sventurag/watchman-readout/Documentation/TARGETC_Datasheet/figures/targetchip.jpg

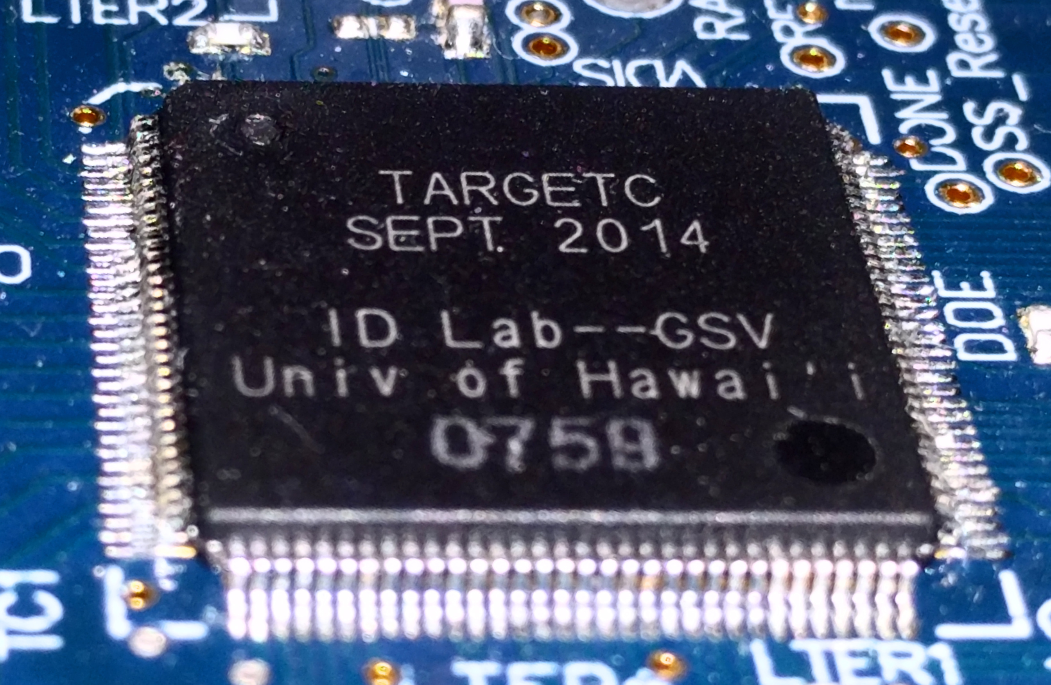
Documentation/TARGETC_Datasheet/figures/targetchip.jpg
