sventurag/watchman-readout/Documentation/MICROZED/Avnet Zed Board Definitions/picozed_7030_fmc2/1.1/PZCC-FMC-V2.jpg

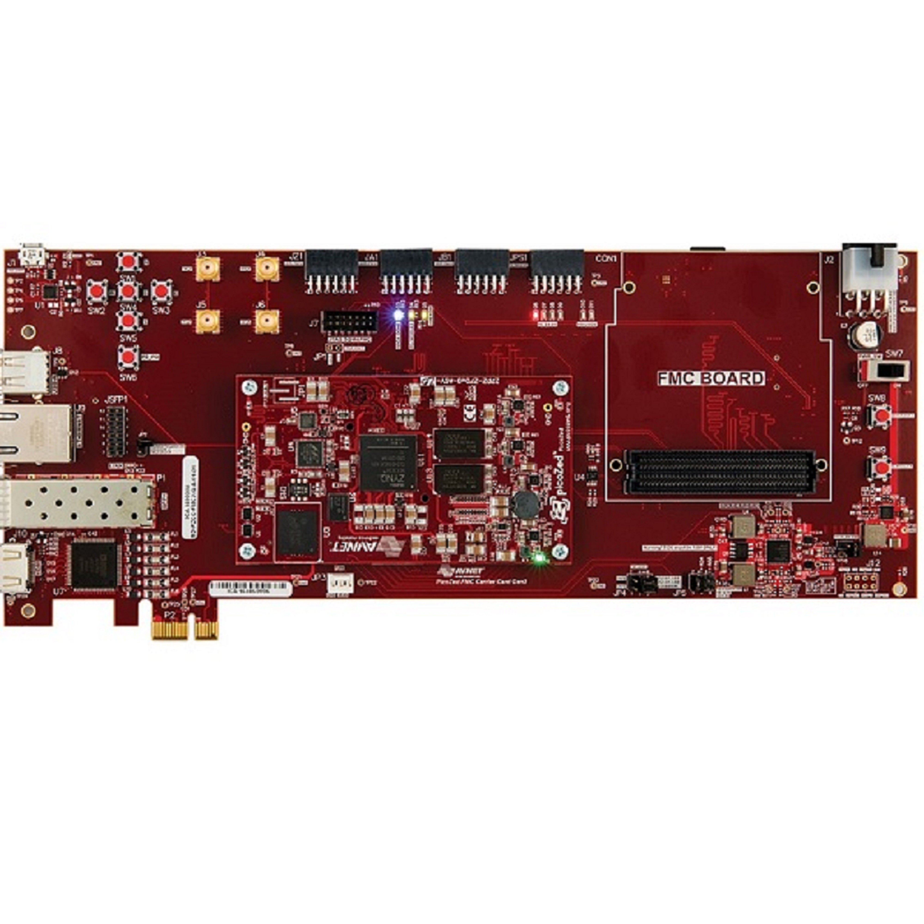
Documentation/MICROZED/Avnet Zed Board Definitions/picozed_7030_fmc2/1.1/PZCC-FMC-V2.jpg
