sventurag/watchman-readout/README.md

# watchman-readout repository
Vivado, SDK and Python files for the development of the readout for WATCHMAN project at the IDLAB.

# March, 2019

## Collaborators :
#### Jose Duron
#### Ky Ho
#### Anthony Schluchin
#### Hendriks Jonathan
#### Vasiliy Shebalin
#### Salvador Ventura
#### Elise Sueoka

## Folder Structure

#### Documentation
Documentation of the project and tutorials

#### GUI
Main interface based on Python 3.

#### Vivado Projects
Vivado Projects for implementing the watchman-readout project.

This repository was created from the original repository [WATCHMAN](https://github.com/WMidlab/WATCHMAN).
