sventurag/watchman-readout/Documentation/firmware_reports/clock_utilization_report.txt

Copyright 1986-2018 Xilinx, Inc. All Rights Reserved.
---------------------------------------------------------------------------------------------------------------------------------------------------------------------------------------------------
| Tool Version : Vivado v.2018.2 (lin64) Build 2258646 Thu Jun 14 20:02:38 MDT 2018
| Date         : Wed Aug 14 15:52:18 2019
| Host         : idlab52-OptiPlex-790 running 64-bit Ubuntu 14.04.6 LTS
| Command      : report_clock_utilization -name clock_utilization_2 -file /home/idlab-52/salvador_fork/fix_WR_address/watchman-readout/Documentation/firmware_reports/clock_utilization_report.txt
| Design       : base_zynq_wrapper
| Device       : 7z010-clg400
| Speed File   : -1  PRODUCTION 1.11 2014-09-11
---------------------------------------------------------------------------------------------------------------------------------------------------------------------------------------------------

Clock Utilization Report

Table of Contents
-----------------
1. Clock Primitive Utilization
2. Global Clock Resources
3. Global Clock Source Details
4. Clock Regions: Key Resource Utilization
5. Clock Regions : Global Clock Summary
6. Device Cell Placement Summary for Global Clock g0
7. Device Cell Placement Summary for Global Clock g1
8. Device Cell Placement Summary for Global Clock g2
9. Device Cell Placement Summary for Global Clock g3
10. Clock Region Cell Placement per Global Clock: Region X0Y0
11. Clock Region Cell Placement per Global Clock: Region X1Y0
12. Clock Region Cell Placement per Global Clock: Region X0Y1
13. Clock Region Cell Placement per Global Clock: Region X1Y1

1. Clock Primitive Utilization
------------------------------

+----------+------+-----------+-----+--------------+--------+
| Type     | Used | Available | LOC | Clock Region | Pblock |
+----------+------+-----------+-----+--------------+--------+
| BUFGCTRL |    4 |        32 |   0 |            0 |      0 |
| BUFH     |    0 |        48 |   0 |            0 |      0 |
| BUFIO    |    0 |         8 |   0 |            0 |      0 |
| BUFMR    |    0 |         4 |   0 |            0 |      0 |
| BUFR     |    0 |         8 |   0 |            0 |      0 |
| MMCM     |    1 |         2 |   0 |            0 |      0 |
| PLL      |    0 |         2 |   0 |            0 |      0 |
+----------+------+-----------+-----+--------------+--------+

2. Global Clock Resources
-------------------------

+-----------+-----------+-----------------+------------+---------------+--------------+-------------------+-------------+-----------------+--------------+--------------+---------------------------------------------------------------------------+------------------------------------------------------------------------+
| Global Id | Source Id | Driver Type/Pin | Constraint | Site          | Clock Region | Load Clock Region | Clock Loads | Non-Clock Loads | Clock Period | Clock        | Driver Pin                                                                | Net                                                                    |
+-----------+-----------+-----------------+------------+---------------+--------------+-------------------+-------------+-----------------+--------------+--------------+---------------------------------------------------------------------------+------------------------------------------------------------------------+
| g0        | src0      | BUFG/O          | None       | BUFGCTRL_X0Y0 | n/a          |                 4 |        8403 |               0 |       10.000 | clk_fpga_0   | base_zynq_i/processing_system7_0/inst/buffer_fclk_clk_0.FCLK_CLK_0_BUFG/O | base_zynq_i/processing_system7_0/inst/FCLK_CLK0                        |
| g1        | src1      | BUFG/O          | None       | BUFGCTRL_X0Y1 | n/a          |                 1 |           2 |               1 |        8.000 | CLK125MHzraw | base_zynq_i/TARGET_C_TopLevel_Sy_0/U0/TC_ClockMgmt_inst/BUFG_OUTCLK250/O  | base_zynq_i/TARGET_C_TopLevel_Sy_0/U0/TC_ClockMgmt_inst/CLK125MHz_bufg |
| g2        | src1      | BUFG/O          | None       | BUFGCTRL_X0Y2 | n/a          |                 1 |           1 |               0 |       10.000 | clkFbOut     | base_zynq_i/TARGET_C_TopLevel_Sy_0/U0/TC_ClockMgmt_inst/BUFG_FB/O         | base_zynq_i/TARGET_C_TopLevel_Sy_0/U0/TC_ClockMgmt_inst/CLKFBIN        |
| g3        | src1      | BUFG/O          | None       | BUFGCTRL_X0Y3 | n/a          |                 1 |           0 |               1 |       10.000 | CLK100MHzraw | base_zynq_i/TARGET_C_TopLevel_Sy_0/U0/TC_ClockMgmt_inst/BUFG_OUTCLK100/O  | base_zynq_i/TARGET_C_TopLevel_Sy_0/U0/TC_ClockMgmt_inst/CLK100MHz_bufg |
+-----------+-----------+-----------------+------------+---------------+--------------+-------------------+-------------+-----------------+--------------+--------------+---------------------------------------------------------------------------+------------------------------------------------------------------------+
* Clock Loads column represents the clock pin loads (pin count)
** Non-Clock Loads column represents the non-clock pin loads (pin count)

3. Global Clock Source Details
------------------------------

+-----------+-----------+---------------------+------------+-----------------+--------------+-------------+-----------------+---------------------+--------------+----------------------------------------------------------------------------------+----------------------------------------------------------------------+
| Source Id | Global Id | Driver Type/Pin     | Constraint | Site            | Clock Region | Clock Loads | Non-Clock Loads | Source Clock Period | Source Clock | Driver Pin                                                                       | Net                                                                  |
+-----------+-----------+---------------------+------------+-----------------+--------------+-------------+-----------------+---------------------+--------------+----------------------------------------------------------------------------------+----------------------------------------------------------------------+
| src0      | g0        | PS7/FCLKCLK[0]      | PS7_X0Y0   | PS7_X0Y0        | X0Y1         |           1 |               0 |              10.000 | clk_fpga_0   | base_zynq_i/processing_system7_0/inst/PS7_i/FCLKCLK[0]                           | base_zynq_i/processing_system7_0/inst/FCLK_CLK_unbuffered[0]         |
| src1      | g3        | MMCME2_ADV/CLKOUT0  | None       | MMCME2_ADV_X0Y0 | X1Y0         |           1 |               0 |              10.000 | CLK100MHzraw | base_zynq_i/TARGET_C_TopLevel_Sy_0/U0/TC_ClockMgmt_inst/TC_CLK_MNG_inst/CLKOUT0  | base_zynq_i/TARGET_C_TopLevel_Sy_0/U0/TC_ClockMgmt_inst/CLK100MHzraw |
| src1      | g1        | MMCME2_ADV/CLKOUT1  | None       | MMCME2_ADV_X0Y0 | X1Y0         |           1 |               0 |               8.000 | CLK125MHzraw | base_zynq_i/TARGET_C_TopLevel_Sy_0/U0/TC_ClockMgmt_inst/TC_CLK_MNG_inst/CLKOUT1  | base_zynq_i/TARGET_C_TopLevel_Sy_0/U0/TC_ClockMgmt_inst/CLK125MHzraw |
| src1      | g2        | MMCME2_ADV/CLKFBOUT | None       | MMCME2_ADV_X0Y0 | X1Y0         |           1 |               0 |              10.000 | clkFbOut     | base_zynq_i/TARGET_C_TopLevel_Sy_0/U0/TC_ClockMgmt_inst/TC_CLK_MNG_inst/CLKFBOUT | base_zynq_i/TARGET_C_TopLevel_Sy_0/U0/TC_ClockMgmt_inst/clkFbOut     |
+-----------+-----------+---------------------+------------+-----------------+--------------+-------------+-----------------+---------------------+--------------+----------------------------------------------------------------------------------+----------------------------------------------------------------------+
* Clock Loads column represents the clock pin loads (pin count)
** Non-Clock Loads column represents the non-clock pin loads (pin count)

4. Clock Regions: Key Resource Utilization
------------------------------------------

+-------------------+--------------+--------------+--------------+--------------+--------------+--------------+--------------+--------------+--------------+--------------+--------------+--------------+--------------+--------------+--------------+
|                   | Global Clock |     BUFRs    |    BUFMRs    |    BUFIOs    |     MMCM     |      PLL     |      GT      |      PCI     |    ILOGIC    |    OLOGIC    |      FF      |     LUTM     |    RAMB18    |    RAMB36    |    DSP48E2   |
+-------------------+------+-------+------+-------+------+-------+------+-------+------+-------+------+-------+------+-------+------+-------+------+-------+------+-------+------+-------+------+-------+------+-------+------+-------+------+-------+
| Clock Region Name | Used | Avail | Used | Avail | Used | Avail | Used | Avail | Used | Avail | Used | Avail | Used | Avail | Used | Avail | Used | Avail | Used | Avail | Used | Avail | Used | Avail | Used | Avail | Used | Avail | Used | Avail |
+-------------------+------+-------+------+-------+------+-------+------+-------+------+-------+------+-------+------+-------+------+-------+------+-------+------+-------+------+-------+------+-------+------+-------+------+-------+------+-------+
| X0Y0              |    1 |    12 |    0 |     0 |    0 |     0 |    0 |     0 |    0 |     0 |    0 |     0 |    0 |     0 |    0 |     0 |    0 |     0 |    0 |     0 | 3010 |  1100 | 1262 |   400 |    0 |    20 |    1 |    10 |    0 |    20 |
| X1Y0              |    4 |    12 |    0 |     4 |    0 |     2 |    0 |     4 |    1 |     1 |    0 |     1 |    0 |     0 |    0 |     0 |    0 |    50 |    0 |    50 | 1213 |  1100 |  311 |   350 |    1 |    40 |    1 |    20 |    0 |    20 |
| X0Y1              |    1 |    12 |    0 |     0 |    0 |     0 |    0 |     0 |    0 |     0 |    0 |     0 |    0 |     0 |    0 |     0 |    0 |     0 |    0 |     0 | 2429 |  1100 |  939 |   400 |    0 |    20 |    0 |    10 |    0 |    20 |
| X1Y1              |    1 |    12 |    0 |     4 |    0 |     2 |    0 |     4 |    0 |     1 |    0 |     1 |    0 |     0 |    0 |     0 |    0 |    50 |    0 |    50 | 1521 |  1100 |  458 |   350 |    0 |    40 |    0 |    20 |    0 |    20 |
+-------------------+------+-------+------+-------+------+-------+------+-------+------+-------+------+-------+------+-------+------+-------+------+-------+------+-------+------+-------+------+-------+------+-------+------+-------+------+-------+
* Global Clock column represents track count; while other columns represents cell counts

5. Clock Regions : Global Clock Summary
---------------------------------------

All Modules
+----+----+----+
|    | X0 | X1 |
+----+----+----+
| Y1 |  1 |  1 |
| Y0 |  1 |  4 |
+----+----+----+

6. Device Cell Placement Summary for Global Clock g0
----------------------------------------------------

+-----------+-----------------+-------------------+------------+-------------+---------------+-------------+----------+----------------+----------+-------------------------------------------------+
| Global Id | Driver Type/Pin | Driver Region (D) | Clock      | Period (ns) | Waveform (ns) | Slice Loads | IO Loads | Clocking Loads | GT Loads | Net                                             |
+-----------+-----------------+-------------------+------------+-------------+---------------+-------------+----------+----------------+----------+-------------------------------------------------+
| g0        | BUFG/O          | n/a               | clk_fpga_0 |      10.000 | {0.000 5.000} |        8363 |        0 |              1 |        0 | base_zynq_i/processing_system7_0/inst/FCLK_CLK0 |
+-----------+-----------------+-------------------+------------+-------------+---------------+-------------+----------+----------------+----------+-------------------------------------------------+
* Logic Loads column represents load cell count of all cell types other than IO, GT and clock resources
** IO Loads column represents load cell count of IO types
*** Clocking Loads column represents load cell count that are clock resources (global clock buffer, MMCM, PLL, etc)
**** GT Loads column represents load cell count of GT types

+----+-------+-------+
|    | X0    | X1    |
+----+-------+-------+
| Y1 |  2430 |  1521 |
| Y0 |  3197 |  1216 |
+----+-------+-------+

7. Device Cell Placement Summary for Global Clock g1
----------------------------------------------------

+-----------+-----------------+-------------------+--------------+-------------+---------------+-------------+----------+----------------+----------+------------------------------------------------------------------------+
| Global Id | Driver Type/Pin | Driver Region (D) | Clock        | Period (ns) | Waveform (ns) | Slice Loads | IO Loads | Clocking Loads | GT Loads | Net                                                                    |
+-----------+-----------------+-------------------+--------------+-------------+---------------+-------------+----------+----------------+----------+------------------------------------------------------------------------+
| g1        | BUFG/O          | n/a               | CLK125MHzraw |       8.000 | {0.000 4.000} |           3 |        0 |              0 |        0 | base_zynq_i/TARGET_C_TopLevel_Sy_0/U0/TC_ClockMgmt_inst/CLK125MHz_bufg |
+-----------+-----------------+-------------------+--------------+-------------+---------------+-------------+----------+----------------+----------+------------------------------------------------------------------------+
* Logic Loads column represents load cell count of all cell types other than IO, GT and clock resources
** IO Loads column represents load cell count of IO types
*** Clocking Loads column represents load cell count that are clock resources (global clock buffer, MMCM, PLL, etc)
**** GT Loads column represents load cell count of GT types

+----+----+----+
|    | X0 | X1 |
+----+----+----+
| Y1 |  0 |  0 |
| Y0 |  0 |  3 |
+----+----+----+

8. Device Cell Placement Summary for Global Clock g2
----------------------------------------------------

+-----------+-----------------+-------------------+----------+-------------+---------------+-------------+----------+----------------+----------+-----------------------------------------------------------------+
| Global Id | Driver Type/Pin | Driver Region (D) | Clock    | Period (ns) | Waveform (ns) | Slice Loads | IO Loads | Clocking Loads | GT Loads | Net                                                             |
+-----------+-----------------+-------------------+----------+-------------+---------------+-------------+----------+----------------+----------+-----------------------------------------------------------------+
| g2        | BUFG/O          | n/a               | clkFbOut |      10.000 | {0.000 5.000} |           0 |        0 |              1 |        0 | base_zynq_i/TARGET_C_TopLevel_Sy_0/U0/TC_ClockMgmt_inst/CLKFBIN |
+-----------+-----------------+-------------------+----------+-------------+---------------+-------------+----------+----------------+----------+-----------------------------------------------------------------+
* Logic Loads column represents load cell count of all cell types other than IO, GT and clock resources
** IO Loads column represents load cell count of IO types
*** Clocking Loads column represents load cell count that are clock resources (global clock buffer, MMCM, PLL, etc)
**** GT Loads column represents load cell count of GT types

+----+----+----+
|    | X0 | X1 |
+----+----+----+
| Y1 |  0 |  0 |
| Y0 |  0 |  1 |
+----+----+----+

9. Device Cell Placement Summary for Global Clock g3
----------------------------------------------------

+-----------+-----------------+-------------------+--------------+-------------+---------------+-------------+----------+----------------+----------+------------------------------------------------------------------------+
| Global Id | Driver Type/Pin | Driver Region (D) | Clock        | Period (ns) | Waveform (ns) | Slice Loads | IO Loads | Clocking Loads | GT Loads | Net                                                                    |
+-----------+-----------------+-------------------+--------------+-------------+---------------+-------------+----------+----------------+----------+------------------------------------------------------------------------+
| g3        | BUFG/O          | n/a               | CLK100MHzraw |      10.000 | {0.000 5.000} |           1 |        0 |              0 |        0 | base_zynq_i/TARGET_C_TopLevel_Sy_0/U0/TC_ClockMgmt_inst/CLK100MHz_bufg |
+-----------+-----------------+-------------------+--------------+-------------+---------------+-------------+----------+----------------+----------+------------------------------------------------------------------------+
* Logic Loads column represents load cell count of all cell types other than IO, GT and clock resources
** IO Loads column represents load cell count of IO types
*** Clocking Loads column represents load cell count that are clock resources (global clock buffer, MMCM, PLL, etc)
**** GT Loads column represents load cell count of GT types

+----+----+----+
|    | X0 | X1 |
+----+----+----+
| Y1 |  0 |  0 |
| Y0 |  0 |  1 |
+----+----+----+

10. Clock Region Cell Placement per Global Clock: Region X0Y0
-------------------------------------------------------------

+-----------+-------+-----------------+------------+-------------+-----------------+------+--------+------+-----+----+------+-----+---------+-------------------------------------------------+
| Global Id | Track | Driver Type/Pin | Constraint | Clock Loads | Non-Clock Loads | FF   | LUTRAM | RAMB | DSP | GT | MMCM | PLL | Hard IP | Net                                             |
+-----------+-------+-----------------+------------+-------------+-----------------+------+--------+------+-----+----+------+-----+---------+-------------------------------------------------+
| g0        | n/a   | BUFG/O          | None       |        3197 |               0 | 3010 |    185 |    1 |   0 |  0 |    0 |   0 |       0 | base_zynq_i/processing_system7_0/inst/FCLK_CLK0 |
+-----------+-------+-----------------+------------+-------------+-----------------+------+--------+------+-----+----+------+-----+---------+-------------------------------------------------+
* Clock Loads column represents the clock pin loads (pin count)
** Non-Clock Loads column represents the non-clock pin loads (pin count)
*** Columns FF, LUTRAM, RAMB through 'Hard IP' represents load cell counts

11. Clock Region Cell Placement per Global Clock: Region X1Y0
-------------------------------------------------------------

+-----------+-------+-----------------+------------+-------------+-----------------+------+--------+------+-----+----+------+-----+---------+------------------------------------------------------------------------+
| Global Id | Track | Driver Type/Pin | Constraint | Clock Loads | Non-Clock Loads | FF   | LUTRAM | RAMB | DSP | GT | MMCM | PLL | Hard IP | Net                                                                    |
+-----------+-------+-----------------+------------+-------------+-----------------+------+--------+------+-----+----+------+-----+---------+------------------------------------------------------------------------+
| g0        | n/a   | BUFG/O          | None       |        1216 |               0 | 1211 |      0 |    2 |   0 |  0 |    1 |   0 |       0 | base_zynq_i/processing_system7_0/inst/FCLK_CLK0                        |
| g1        | n/a   | BUFG/O          | None       |           2 |               1 |    2 |      0 |    0 |   0 |  0 |    0 |   0 |       0 | base_zynq_i/TARGET_C_TopLevel_Sy_0/U0/TC_ClockMgmt_inst/CLK125MHz_bufg |
| g2        | n/a   | BUFG/O          | None       |           1 |               0 |    0 |      0 |    0 |   0 |  0 |    1 |   0 |       0 | base_zynq_i/TARGET_C_TopLevel_Sy_0/U0/TC_ClockMgmt_inst/CLKFBIN        |
| g3        | n/a   | BUFG/O          | None       |           0 |               1 |    0 |      0 |    0 |   0 |  0 |    0 |   0 |       0 | base_zynq_i/TARGET_C_TopLevel_Sy_0/U0/TC_ClockMgmt_inst/CLK100MHz_bufg |
+-----------+-------+-----------------+------------+-------------+-----------------+------+--------+------+-----+----+------+-----+---------+------------------------------------------------------------------------+
* Clock Loads column represents the clock pin loads (pin count)
** Non-Clock Loads column represents the non-clock pin loads (pin count)
*** Columns FF, LUTRAM, RAMB through 'Hard IP' represents load cell counts

12. Clock Region Cell Placement per Global Clock: Region X0Y1
-------------------------------------------------------------

+-----------+-------+-----------------+------------+-------------+-----------------+------+--------+------+-----+----+------+-----+---------+-------------------------------------------------+
| Global Id | Track | Driver Type/Pin | Constraint | Clock Loads | Non-Clock Loads | FF   | LUTRAM | RAMB | DSP | GT | MMCM | PLL | Hard IP | Net                                             |
+-----------+-------+-----------------+------------+-------------+-----------------+------+--------+------+-----+----+------+-----+---------+-------------------------------------------------+
| g0        | n/a   | BUFG/O          | None       |        2430 |               0 | 2429 |      0 |    0 |   0 |  0 |    0 |   0 |       0 | base_zynq_i/processing_system7_0/inst/FCLK_CLK0 |
+-----------+-------+-----------------+------------+-------------+-----------------+------+--------+------+-----+----+------+-----+---------+-------------------------------------------------+
* Clock Loads column represents the clock pin loads (pin count)
** Non-Clock Loads column represents the non-clock pin loads (pin count)
*** Columns FF, LUTRAM, RAMB through 'Hard IP' represents load cell counts

13. Clock Region Cell Placement per Global Clock: Region X1Y1
-------------------------------------------------------------

+-----------+-------+-----------------+------------+-------------+-----------------+------+--------+------+-----+----+------+-----+---------+-------------------------------------------------+
| Global Id | Track | Driver Type/Pin | Constraint | Clock Loads | Non-Clock Loads | FF   | LUTRAM | RAMB | DSP | GT | MMCM | PLL | Hard IP | Net                                             |
+-----------+-------+-----------------+------------+-------------+-----------------+------+--------+------+-----+----+------+-----+---------+-------------------------------------------------+
| g0        | n/a   | BUFG/O          | None       |        1521 |               0 | 1521 |      0 |    0 |   0 |  0 |    0 |   0 |       0 | base_zynq_i/processing_system7_0/inst/FCLK_CLK0 |
+-----------+-------+-----------------+------------+-------------+-----------------+------+--------+------+-----+----+------+-----+---------+-------------------------------------------------+
* Clock Loads column represents the clock pin loads (pin count)
** Non-Clock Loads column represents the non-clock pin loads (pin count)
*** Columns FF, LUTRAM, RAMB through 'Hard IP' represents load cell counts

# Location of BUFG Primitives 
set_property LOC BUFGCTRL_X0Y0 [get_cells base_zynq_i/processing_system7_0/inst/buffer_fclk_clk_0.FCLK_CLK_0_BUFG]
set_property LOC BUFGCTRL_X0Y2 [get_cells base_zynq_i/TARGET_C_TopLevel_Sy_0/U0/TC_ClockMgmt_inst/BUFG_FB]
set_property LOC BUFGCTRL_X0Y1 [get_cells base_zynq_i/TARGET_C_TopLevel_Sy_0/U0/TC_ClockMgmt_inst/BUFG_OUTCLK250]
set_property LOC BUFGCTRL_X0Y3 [get_cells base_zynq_i/TARGET_C_TopLevel_Sy_0/U0/TC_ClockMgmt_inst/BUFG_OUTCLK100]

# Location of IO Primitives which is load of clock spine

# Location of clock ports

# Clock net "base_zynq_i/processing_system7_0/inst/FCLK_CLK0" driven by instance "base_zynq_i/processing_system7_0/inst/buffer_fclk_clk_0.FCLK_CLK_0_BUFG" located at site "BUFGCTRL_X0Y0"
#startgroup
create_pblock {CLKAG_base_zynq_i/processing_system7_0/inst/FCLK_CLK0}
add_cells_to_pblock [get_pblocks  {CLKAG_base_zynq_i/processing_system7_0/inst/FCLK_CLK0}] [get_cells -filter { PRIMITIVE_GROUP != I/O && IS_PRIMITIVE==1 && PRIMITIVE_LEVEL !=INTERNAL && NAME!=base_zynq_i/TARGET_C_TopLevel_Sy_0/U0/TC_ClockMgmt_inst/TC_CLK_MNG_inst} -of_object [get_pins -filter {DIRECTION==IN} -of_objects [get_nets -hierarchical -filter {PARENT=="base_zynq_i/processing_system7_0/inst/FCLK_CLK0"}]]]
resize_pblock [get_pblocks {CLKAG_base_zynq_i/processing_system7_0/inst/FCLK_CLK0}] -add {CLOCKREGION_X0Y0:CLOCKREGION_X0Y0 CLOCKREGION_X0Y1:CLOCKREGION_X0Y1 CLOCKREGION_X1Y0:CLOCKREGION_X1Y0 CLOCKREGION_X1Y1:CLOCKREGION_X1Y1}
#endgroup

# Clock net "base_zynq_i/TARGET_C_TopLevel_Sy_0/U0/TC_ClockMgmt_inst/CLK125MHz_bufg" driven by instance "base_zynq_i/TARGET_C_TopLevel_Sy_0/U0/TC_ClockMgmt_inst/BUFG_OUTCLK250" located at site "BUFGCTRL_X0Y1"
#startgroup
create_pblock {CLKAG_base_zynq_i/TARGET_C_TopLevel_Sy_0/U0/TC_ClockMgmt_inst/CLK125MHz_bufg}
add_cells_to_pblock [get_pblocks  {CLKAG_base_zynq_i/TARGET_C_TopLevel_Sy_0/U0/TC_ClockMgmt_inst/CLK125MHz_bufg}] [get_cells -filter { PRIMITIVE_GROUP != I/O && IS_PRIMITIVE==1 && PRIMITIVE_LEVEL !=INTERNAL } -of_object [get_pins -filter {DIRECTION==IN} -of_objects [get_nets -hierarchical -filter {PARENT=="base_zynq_i/TARGET_C_TopLevel_Sy_0/U0/TC_ClockMgmt_inst/CLK125MHz_bufg"}]]]
resize_pblock [get_pblocks {CLKAG_base_zynq_i/TARGET_C_TopLevel_Sy_0/U0/TC_ClockMgmt_inst/CLK125MHz_bufg}] -add {CLOCKREGION_X1Y0:CLOCKREGION_X1Y0}
#endgroup

# Clock net "base_zynq_i/TARGET_C_TopLevel_Sy_0/U0/TC_ClockMgmt_inst/CLK100MHz_bufg" driven by instance "base_zynq_i/TARGET_C_TopLevel_Sy_0/U0/TC_ClockMgmt_inst/BUFG_OUTCLK100" located at site "BUFGCTRL_X0Y3"
#startgroup
create_pblock {CLKAG_base_zynq_i/TARGET_C_TopLevel_Sy_0/U0/TC_ClockMgmt_inst/CLK100MHz_bufg}
add_cells_to_pblock [get_pblocks  {CLKAG_base_zynq_i/TARGET_C_TopLevel_Sy_0/U0/TC_ClockMgmt_inst/CLK100MHz_bufg}] [get_cells -filter { PRIMITIVE_GROUP != I/O && IS_PRIMITIVE==1 && PRIMITIVE_LEVEL !=INTERNAL } -of_object [get_pins -filter {DIRECTION==IN} -of_objects [get_nets -hierarchical -filter {PARENT=="base_zynq_i/TARGET_C_TopLevel_Sy_0/U0/TC_ClockMgmt_inst/CLK100MHz_bufg"}]]]
resize_pblock [get_pblocks {CLKAG_base_zynq_i/TARGET_C_TopLevel_Sy_0/U0/TC_ClockMgmt_inst/CLK100MHz_bufg}] -add {CLOCKREGION_X1Y0:CLOCKREGION_X1Y0}
#endgroup
