sventurag/watchman-readout/Documentation/TARGETC_Datasheet/src/TARGETC_pinout_hej.xlsx

Sheet: Sheet1
TARGETC ASIC pinout
Pin # | Pin Name | Direction | Connection type | Comments | = VDD
1 | RFin_1 |  | PMT input Ch. 1 | termination R | = GND
2 | RFN_1 |  | Termination ref input Ch. 1 | external, between pins | = Digital to FPGA
3 | RFin_2 |  | PMT input Ch. 2 | termination R | = Digital from FPGA
4 | RFN_2 |  | Termination ref input Ch. 2 | external, between pins | = Analog/bias value
5 | RFin_3 |  | PMT input Ch. 3 | termination R | = Feed to CCTV
6 | RFN_3 |  | Termination ref input Ch. 3 | external, between pins | = Signal input
7 | RFin_4 |  | PMT input Ch. 4 | termination R | = Reference terminal
8 | RFN_4 |  | Termination ref input Ch. 4 | external, between pins | = Test point
9 | RFin_5 |  | PMT input Ch. 5 | termination R | = LVDS inputs
10 | RFN_5 |  | Termination ref input Ch. 5 | external, between pins | = LVDS outputs
11 | RFin_6 |  | PMT input Ch. 6 | termination R
12 | RFN_6 |  | Termination ref input Ch. 6 | external, between pins | = no connect
13 | RFin_7 |  | PMT input Ch. 7 | termination R
14 | RFN_7 |  | Termination ref input Ch. 7 | external, between pins
15 | RFin_8 |  | PMT input Ch. 8 | termination R
16 | RFN_8 |  | Termination ref input Ch. 8 | external, between pins
17 | RFin_9 |  | PMT input Ch. 9 | termination R
18 | RFN_9 |  | Termination ref input Ch. 9 | external, between pins
19 | RFin_10 |  | PMT input Ch. 10 | termination R
20 | RFN_10 |  | Termination ref input Ch. 10 | external, between pins
21 | RFin_11 |  | PMT input Ch. 11 | termination R
22 | RFN_11 |  | Termination ref input Ch. 11 | external, between pins
23 | RFin_12 |  | PMT input Ch. 12 | termination R
24 | RFN_12 |  | Termination ref input Ch. 12 | external, between pins
25 | RFin_13 |  | PMT input Ch. 13 | termination R
26 | RFN_13 |  | Termination ref input Ch. 13 | external, between pins
27 | RFin_14 |  | PMT input Ch. 14 | termination R
28 | RFN_14 |  | Termination ref input Ch. 14 | external, between pins
29 | RFin_15 |  | PMT input Ch. 15 | termination R
30 | RFN_15 |  | Termination ref input Ch. 15 | external, between pins
31 | RFin_16 |  | PMT input Ch. 16 | termination R
32 | RFN_16 |  | Termination ref input Ch. 16 | external, between pins
33 | GND33 | GND | 0V power (GND = VSS)
34 | VDD34 | VDD | 2.5V power (VDD)
35 | eSin |  | Serial Input data | all bits, last = first
36 | eSCLK |  | Serial clock advance | shift in each bit
37 | ePCLK |  | Parallel clock load | transfer shifted data
38 | eSHout |  | Serial Shift Out | monitor output
39 | GND39 | GND | 0V power (GND = VSS)
40 | VDD40 | VDD | 2.5V power (VDD)
41 |  |  | no connect
42
43 | eHSclkN |  | Data Shift-out Clock | n
44 | eHSclkP |  | LVDS | p
45 | GND43 | GND | 0V power (GND = VSS)
46 | eWR_RS_S0 |  | WR Row Select Addr. 0 | Select
47 | eWR_CS_S1 |  | WR Row Select Addr. 1 | group
48 | eWR_CS_S0 |  | WR Column Select Addr. 0 | of 32
49 | eWR_CS_S1 |  | WR Column Select Addr. 1 | samples
50 | eWR_CS_S2 |  | WR Column Select Addr. 2 | for transfer to
51 | eWR_CS_S3 |  | WR Column Select Addr. 3 | Storage
52 | VDD52 | VDD | 2.5V power (VDD)
53 | GND53 | GND | 0V power (GND = VSS)
54 | eWR_CS_S4 |  | WR Column Select Addr. 4 | group of 32 to write
55 | eWR_CS_S5 |  | WR Column Select Addr. 5
56 | eGCC_Reset |  | Gray Code Counter Reset
57 | WL_CLK_n |  | Wilkinson Clock LVDS | n
58 | WL_CLK_p |  | Wilkinson Clock LVDS | p
59 | GND59 | GND | 0V power (GND = VSS)
60 | VDD60 | VDD | 2.5V power (VDD)
61 | eRDAD_clk |  | Read Address Set SCLK
62 | eRDAD_sin |  | Read Address Set Serial Input
63 | eRDAD_dir |  | Read Address Set DIR
64 |  |  | no connect
65 |  |  | no connect
66 | eSmplSl_Any |  | SelANY_TPG | TPG select
67 | VDD67 |  | 2.5V power (VDD)
68 | GND68 |  | 0V power (GND = VSS)
69 | eDO_16 |  | Serial Data Out Ch. 16 | MSB to LSB
70 | eDO_15 |  | Serial Data Out Ch. 15
71 | eDO_14 |  | Serial Data Out Ch. 14 | MSB to LSB
72 | eDO_13 |  | Serial Data Out Ch. 13
73 | eDO_12 |  | Serial Data Out Ch. 12 | MSB to LSB
74 | eDO_11 |  | Serial Data Out Ch. 11
75 | eDO_10 |  | Serial Data Out Ch. 10 | MSB to LSB
76 | eDO_9 |  | Serial Data Out Ch. 9
77 | VDD77 |  | 2.5V power (VDD)
78 | GND78 |  | 0V power (GND = VSS)
79 | eSS_Incr |  | Sample Select increment
80 | eDOE |  | Data Output Enable | tie high for CTA
81 |  |  | no connect
82 | VDD82 |  | 2.5V power (VDD)
83 | GND83 |  | 0V power (GND = VSS)
84 | eDO_8 |  | Serial Data Out Ch. 8 | MSB to LSB
85 | eDO_7 |  | Serial Data Out Ch. 7
86 | eDO_6 |  | Serial Data Out Ch. 6 | MSB to LSB
87 | eDO_5 |  | Serial Data Out Ch. 5
88 | eDO_4 |  | Serial Data Out Ch. 4 | MSB to LSB
89 | eDO_3 |  | Serial Data Out Ch. 3
90 | eDO_2 |  | Serial Data Out Ch. 2 | MSB to LSB
91 | eDO_1 |  | Serial Data Out Ch. 1
92 | VDD92 |  | 2.5V power (VDD)
93 | GND93 |  | 0V power (GND = VSS)
94 | eDONE |  | AND of all DONE | ADC complete
95 | eSS_Reset |  | Sample Select reset
96 | GND96 |  | 0V power (GND = VSS)
97 | VDD97 |  | 2.5V power (VDD)
98 | GND98 |  | 0V power (GND = VSS)
99 | eRegCLR |  | Global register clear | clear all registers
100 | emDOE |  | monitor DOE (was PCLK2)
101 | GND101 |  | 0V power (GND = VSS)
102 | VDD102 | VDD | 2.5V power (VDD)
103 | eSS_LD_sin |  | Sample select load data
104 | eSS_LD_dir |  | Sample select load ctrl
105 |  |  | no connect
106 | GND106 | GND | 0V power (GND = VSS)
107 | VDD107 | VDD | 2.5V power (VDD)
108 | eRamp |  | Wilkinson Ramp control | H=Ramp; L=Vdisc
109 | GND109 | GND | 0V power (GND = VSS)
110 | Vdischarge |  | Wilkinson Ramp Start voltage | set by int. DAC
111 | RampMon |  | Buffered copy of Wilk Ramp | direct observation
112 | ISEL |  | Monitor for Wilk Ramp I (V out) | set by int. DAC
113 | VrampRef |  | Charging node | 50-100pF typ
114 | GND114 | GND | 0V power (GND = VSS)
115 | VDD115 | VDD | 2.5V power (VDD)
116 |  |  | no connect
117 | eMonTimeN |  | Monitor internal Timebase gen | n
118 | eMonTimeP |  |  | p
119 |  |  | no connect
120
121 | GND121 | GND | 0V power (GND = VSS)
122 | VadjN |  | Sampling NMOS current Adj | int/ext
123 |  |  | no connect
124 | VadjP |  | Sampling PMOS current Adj | int/ext
125 | SSTin_p |  | SSTin LVDS | p
126 | SSTin_n |  | SSTin LVDS | n
127 | GND127 | GND | 0V power (GND = VSS)
128 | VDD128 | VDD | 2.5V power (VDD)

Sheet: Compatibility Report
Compatibility Report for TARGET2_pinout.xls
Run on 4/4/2011 11:09
The following features in this workbook are not supported by earlier versions of Excel. These features may be lost or degraded when you save this workbook in an earlier file format.
Minor loss of fidelity | # of occurrences
Some cells or styles in this workbook contain formatting that is not supported by the selected file format. These formats will be converted to the closest format available. | 1
