sventurag/watchman-readout/6UVMEboard_Zynq/hw/sim/TargetC_Internal_TB/TC_GCC_ShiftReg12/Screenshot from 2018-12-04 23-55-54.png

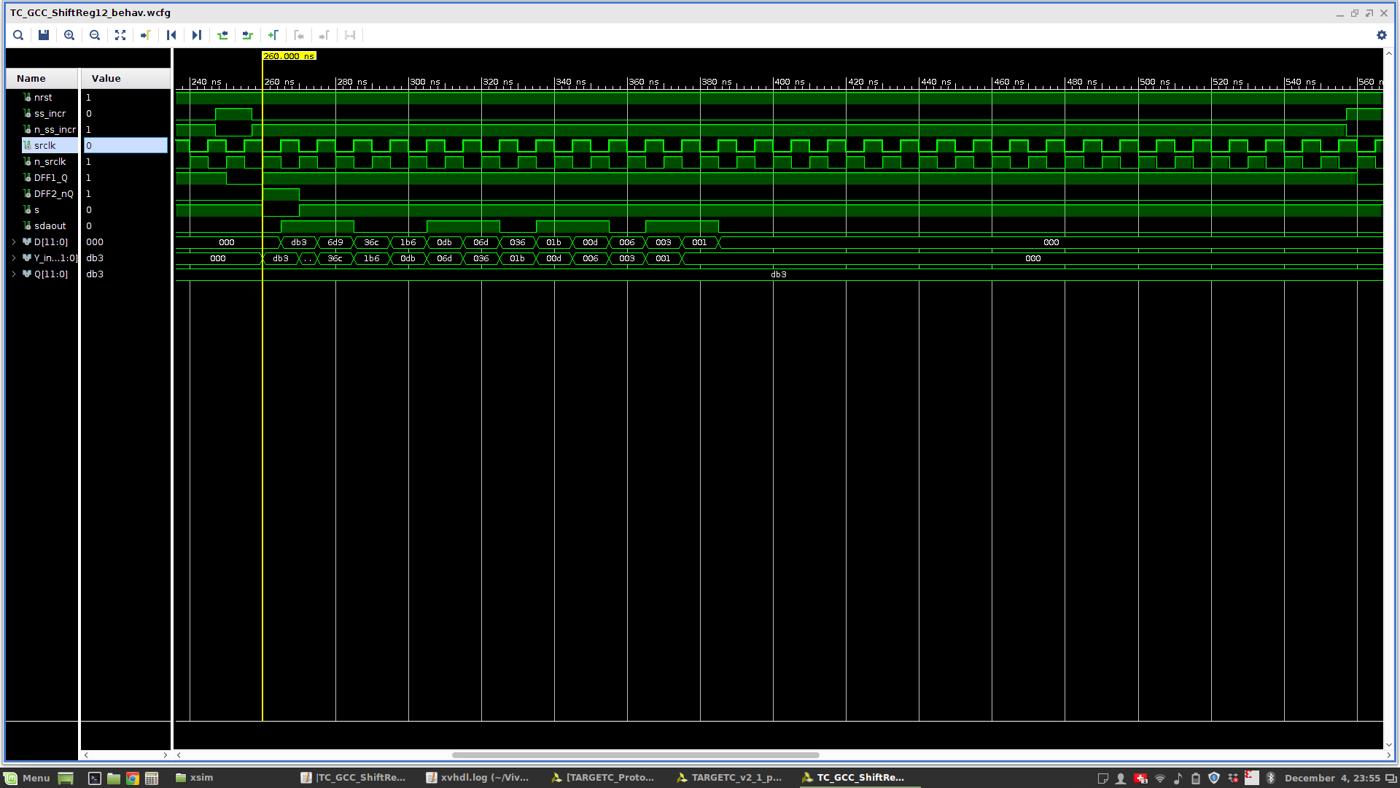
6UVMEboard_Zynq/hw/sim/TargetC_Internal_TB/TC_GCC_ShiftReg12/Screenshot from 2018-12-04 23-55-54.png
