sventurag/watchman-readout/6UVMEboard_Zynq/hw/sim/TargetC_Internal_TB/TC_GCC_ShiftReg12/TC_GCC_ShiftReg12.PNG

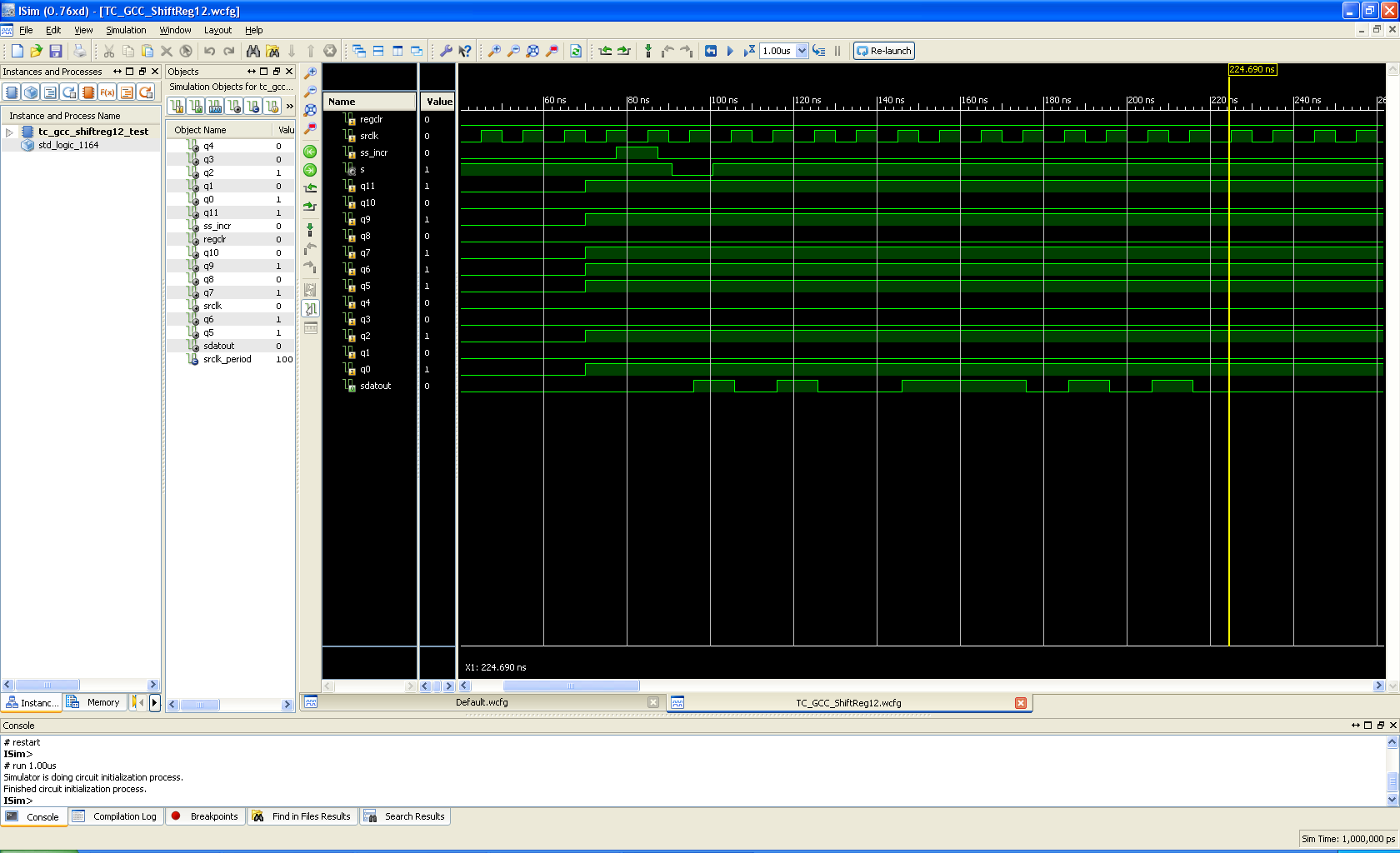
6UVMEboard_Zynq/hw/sim/TargetC_Internal_TB/TC_GCC_ShiftReg12/TC_GCC_ShiftReg12.PNG
