sventurag/watchman-readout/Documentation/Diagrams/pedestalTrigger.png

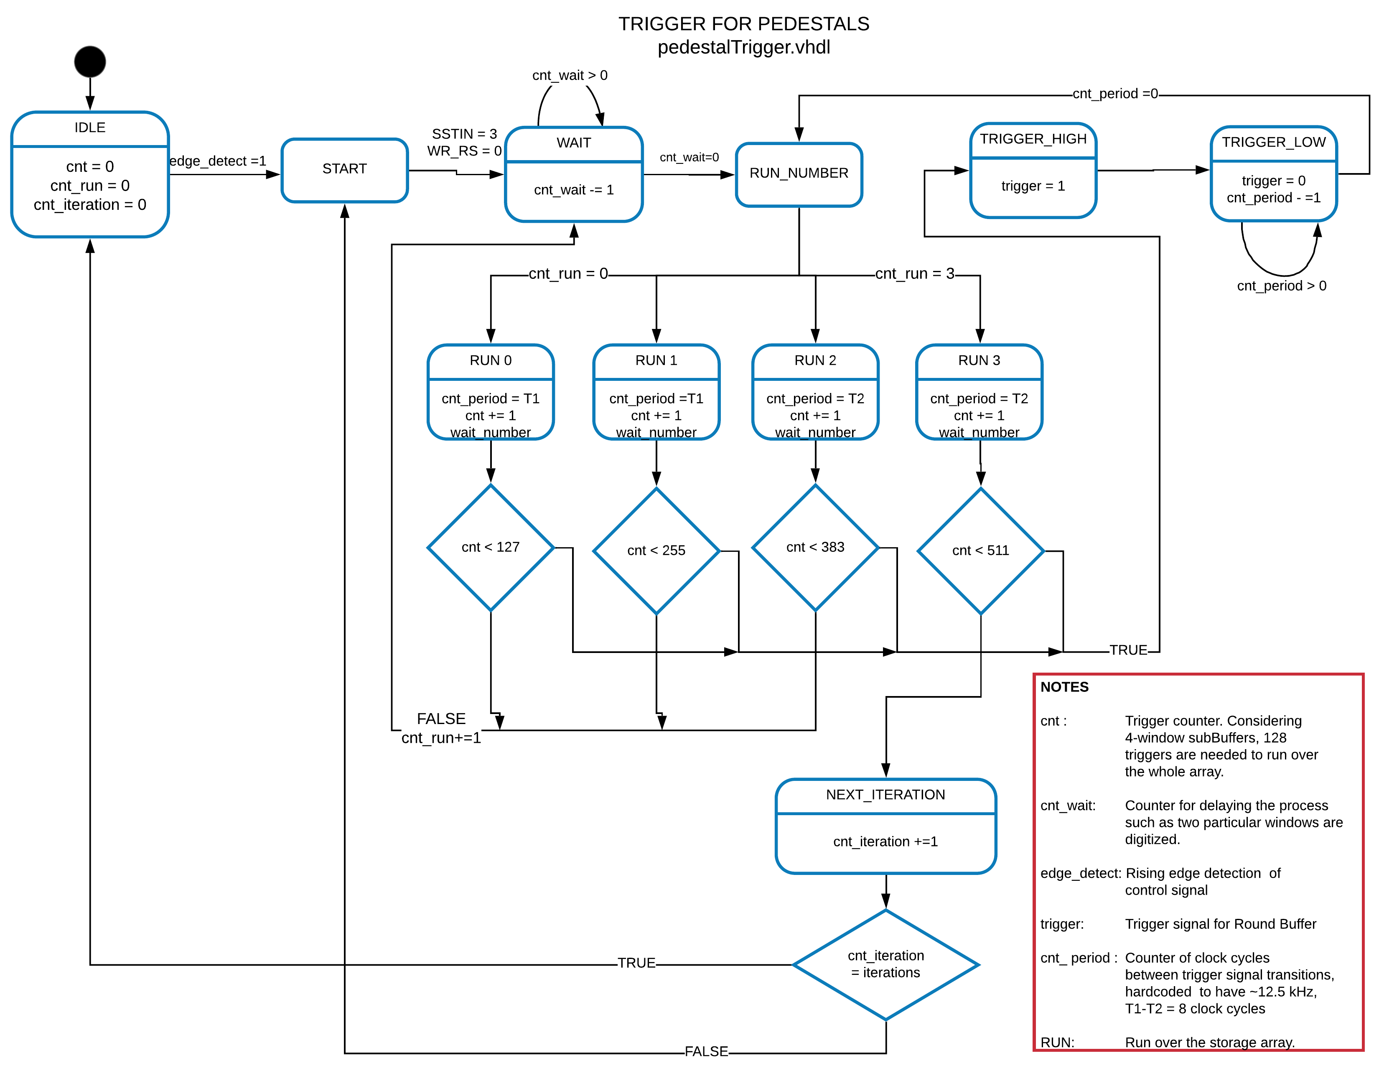
Documentation/Diagrams/pedestalTrigger.png
