sventurag/watchman-readout/Documentation/MICROZED/Avnet Zed Board Definitions/microzed_7010/1.1/MicroZed.jpg

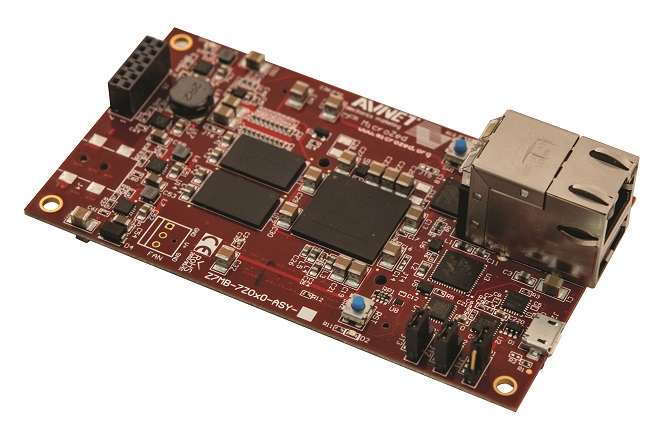
Documentation/MICROZED/Avnet Zed Board Definitions/microzed_7010/1.1/MicroZed.jpg
