sventurag/watchman-readout/Documentation/MICROZED/Avnet Zed Board Definitions/picozed_7010_fmc1/1.1/PZCC_FMC.jpg

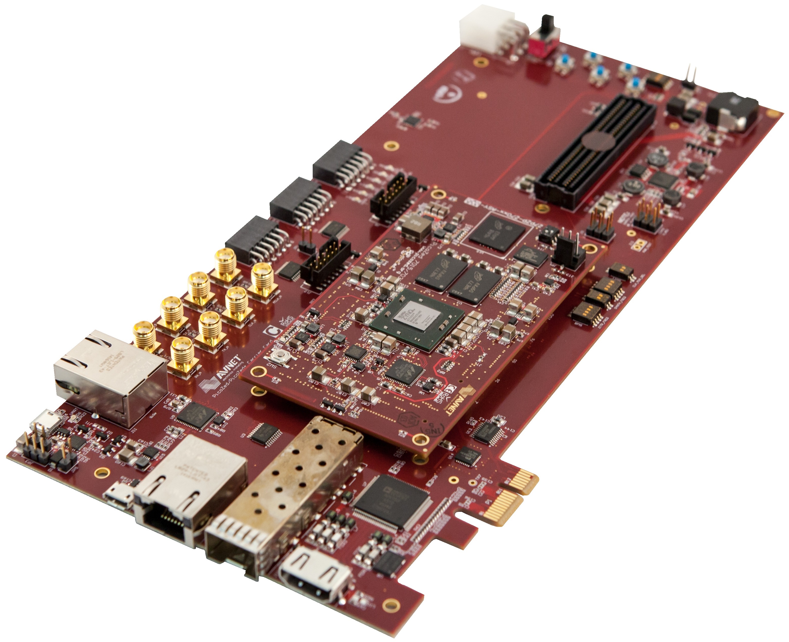
Documentation/MICROZED/Avnet Zed Board Definitions/picozed_7010_fmc1/1.1/PZCC_FMC.jpg
