sventurag/watchman-readout/Documentation/TARGETC_Datasheet/figures/capacitor_array.png

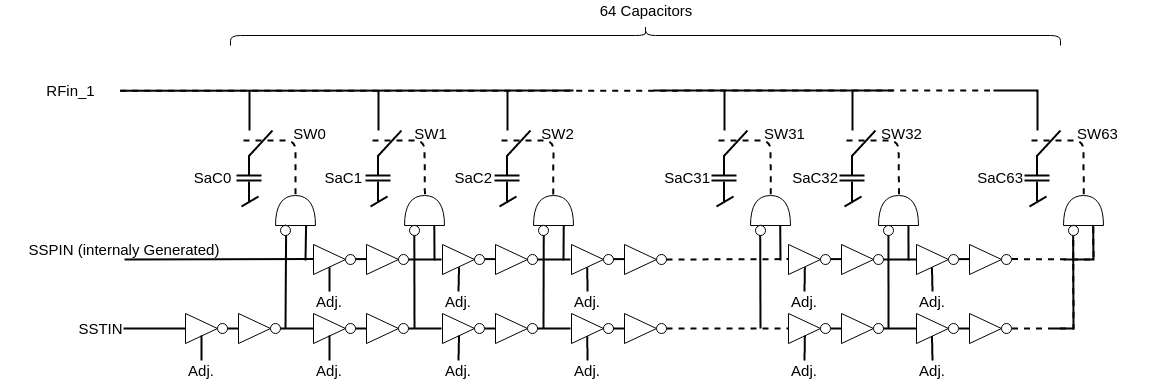
Documentation/TARGETC_Datasheet/figures/capacitor_array.png
