sventurag/watchman-readout/Documentation/TARGETC_Datasheet/figures/digit2.png

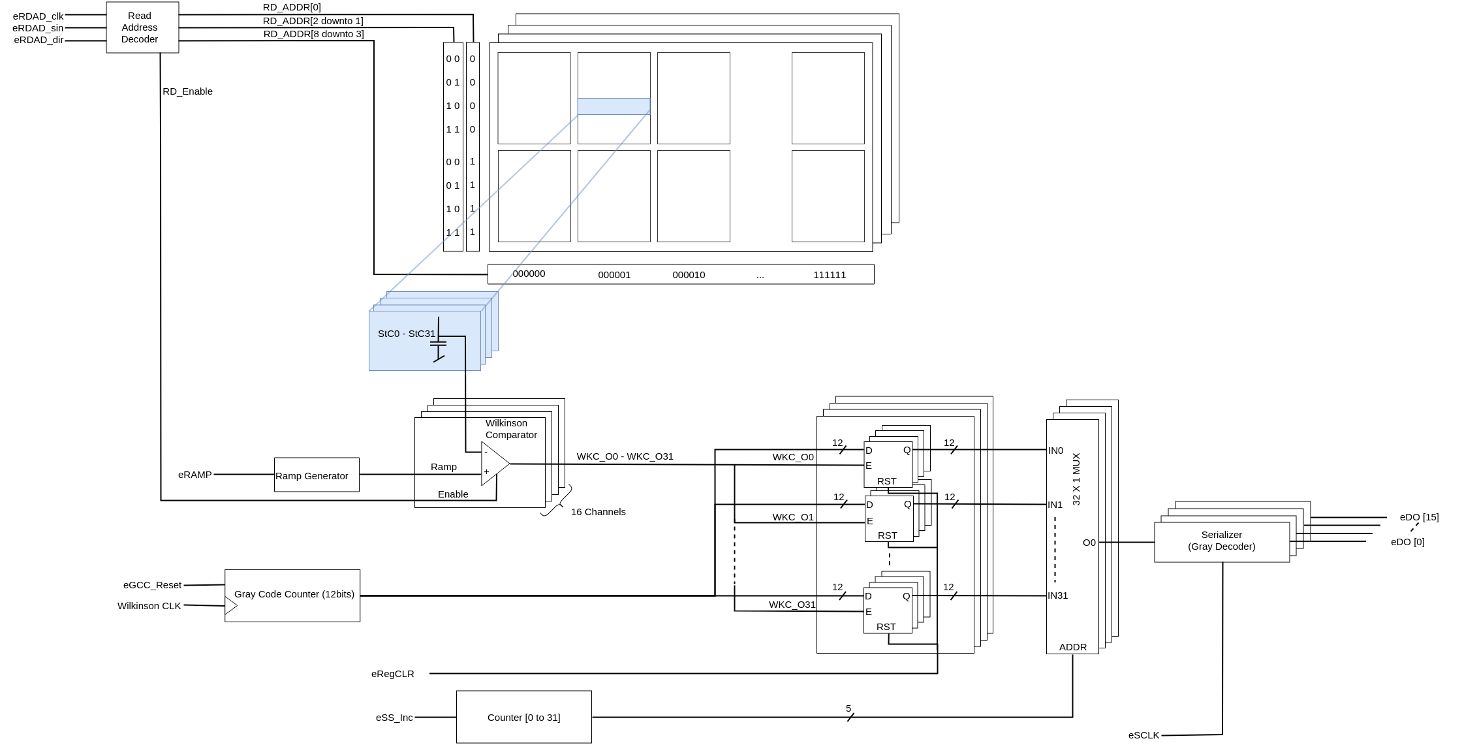
Documentation/TARGETC_Datasheet/figures/digit2.png
