sventurag/watchman-readout/Documentation/TARGETC_Datasheet/figures/digit.png

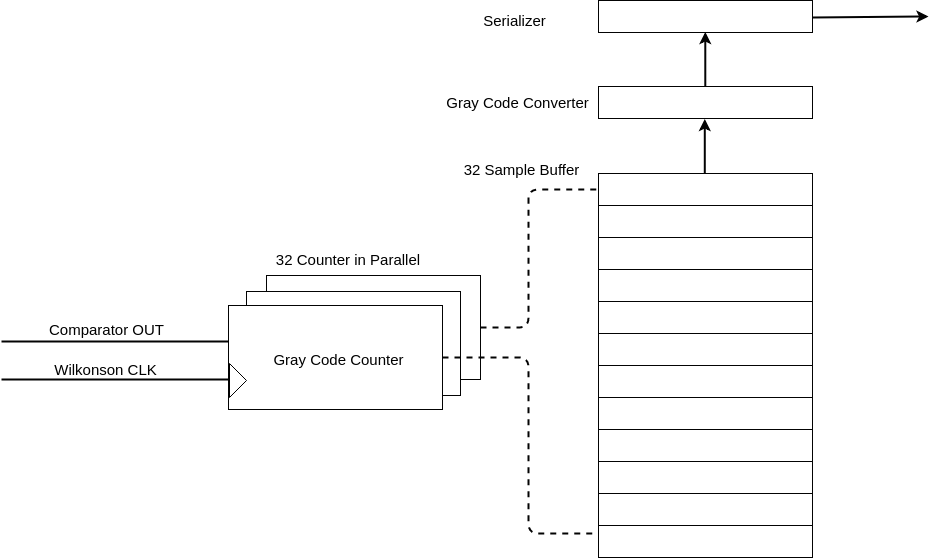
Documentation/TARGETC_Datasheet/figures/digit.png
