sventurag/watchman-readout/Documentation/TARGETC_Datasheet/figures/dll.png

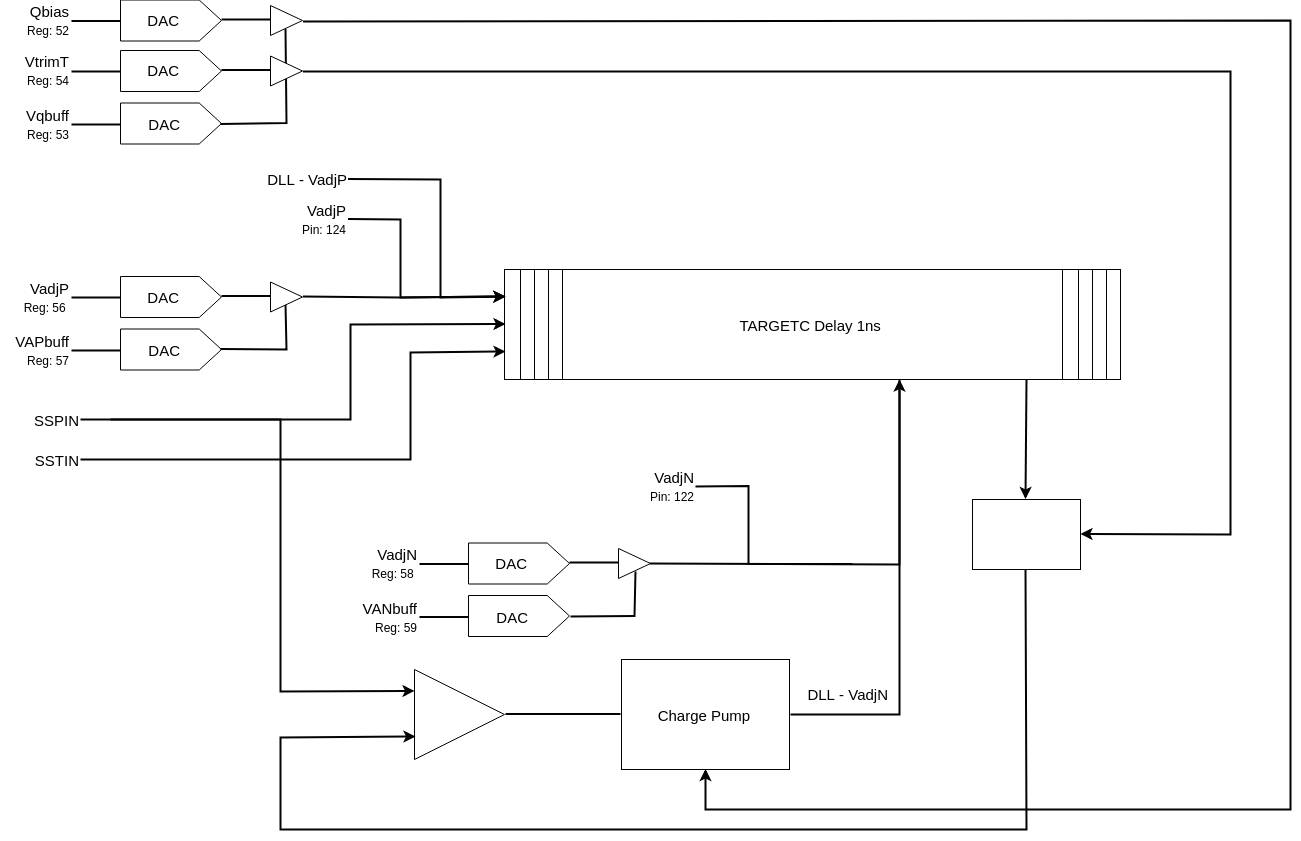
Documentation/TARGETC_Datasheet/figures/dll.png
