sventurag/watchman-readout/Documentation/TARGETC_Datasheet/figures/edone.png

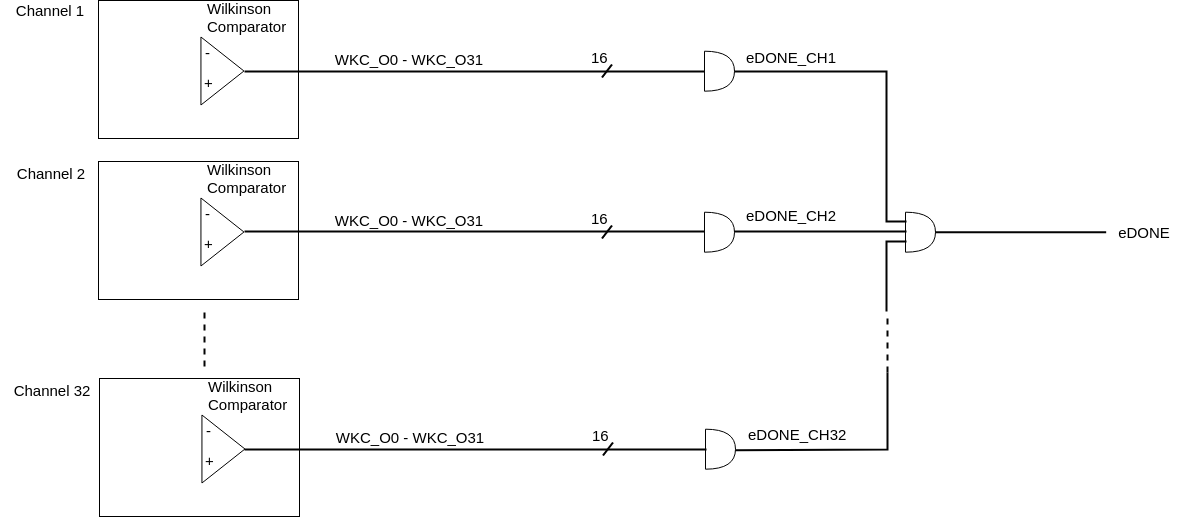
Documentation/TARGETC_Datasheet/figures/edone.png
