sventurag/watchman-readout/Documentation/TARGETC_Datasheet/figures/hesso.png

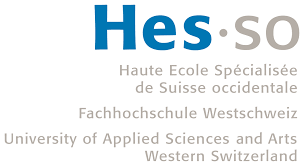
Documentation/TARGETC_Datasheet/figures/hesso.png
