sventurag/watchman-readout/Documentation/TARGETC_Datasheet/figures/inverseur.png

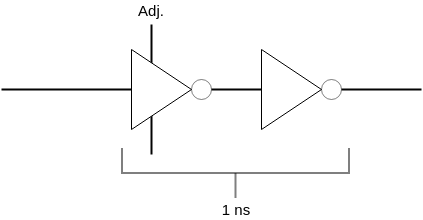
Documentation/TARGETC_Datasheet/figures/inverseur.png
