sventurag/watchman-readout/Documentation/TARGETC_Datasheet/figures/ISELWL.png

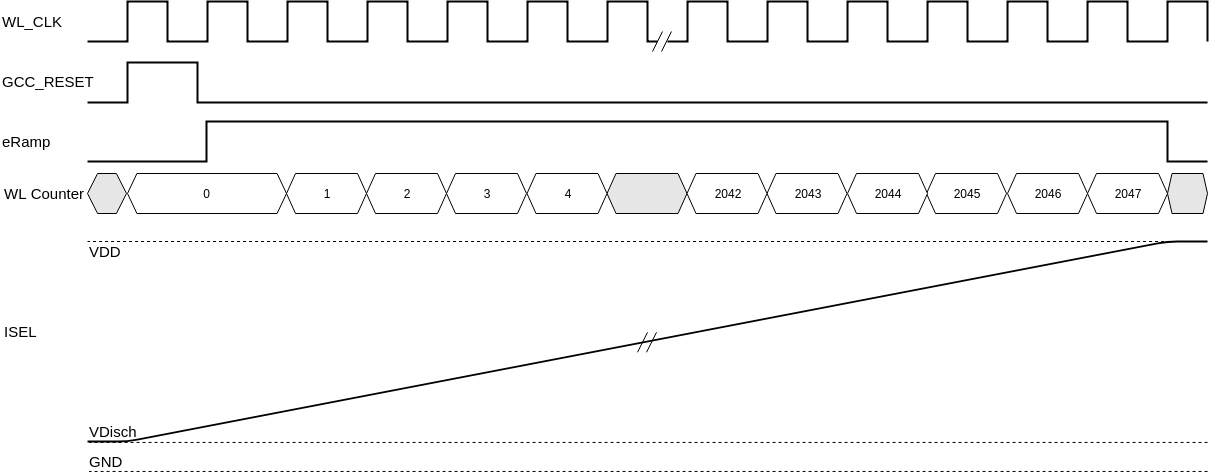
Documentation/TARGETC_Datasheet/figures/ISELWL.png
