sventurag/watchman-readout/Documentation/TARGETC_Datasheet/figures/montiming.png

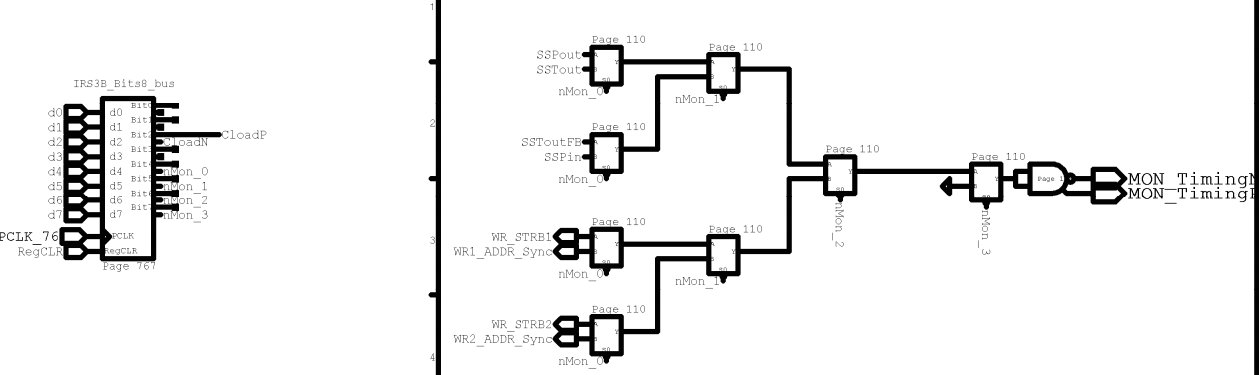
Documentation/TARGETC_Datasheet/figures/montiming.png
