sventurag/watchman-readout/Documentation/TARGETC_Datasheet/figures/ProtoTriggerSmall.png

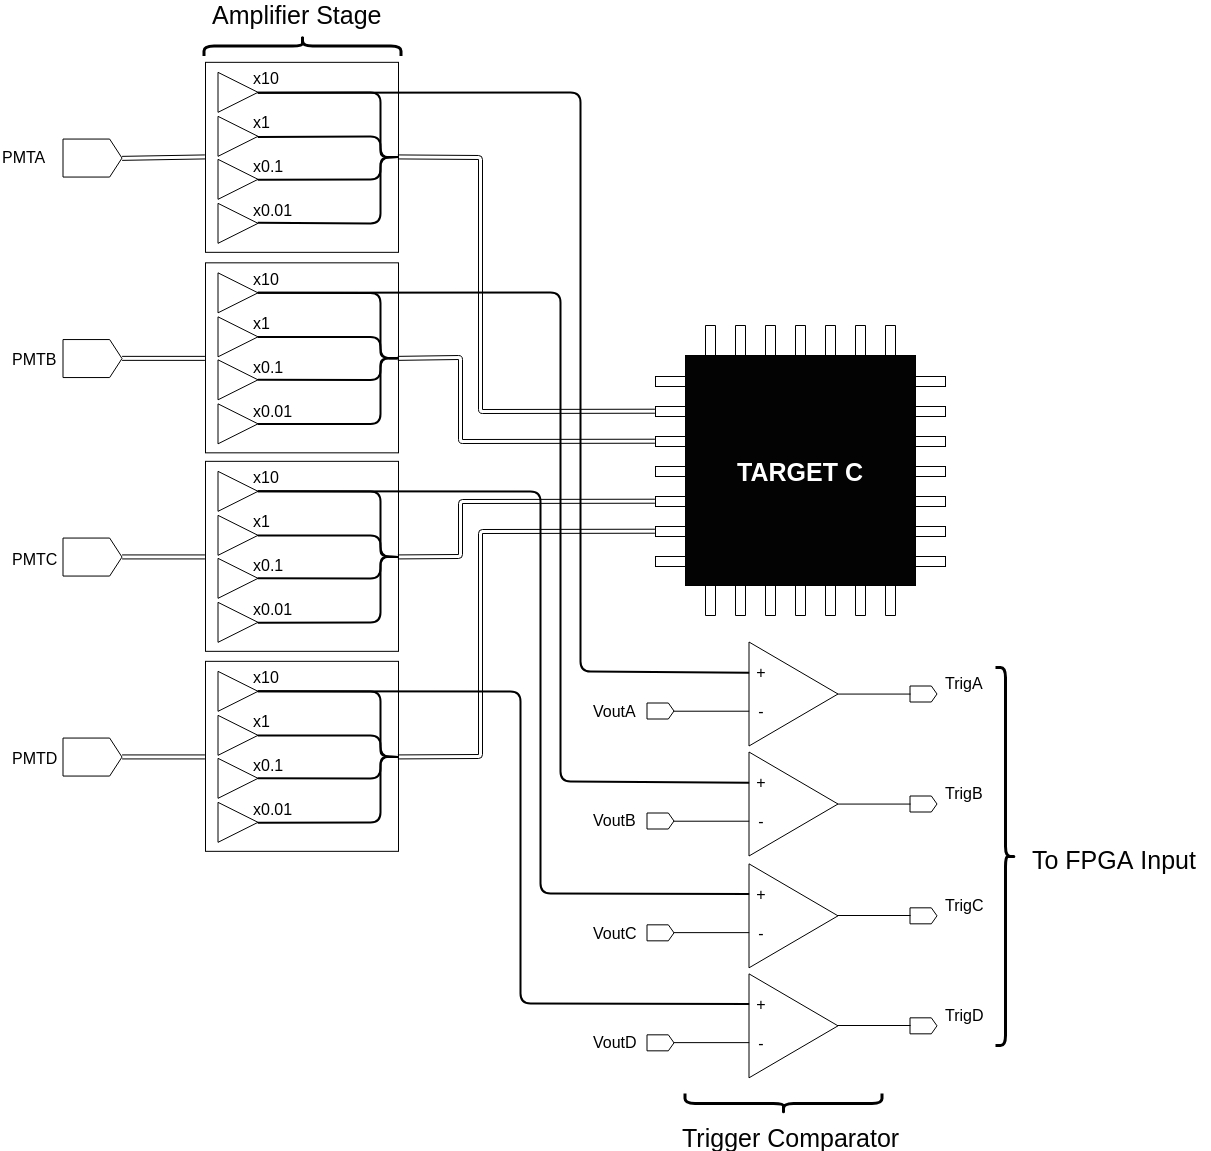
Documentation/TARGETC_Datasheet/figures/ProtoTriggerSmall.png
