sventurag/watchman-readout/Documentation/TARGETC_Datasheet/figures/SSTIN.png

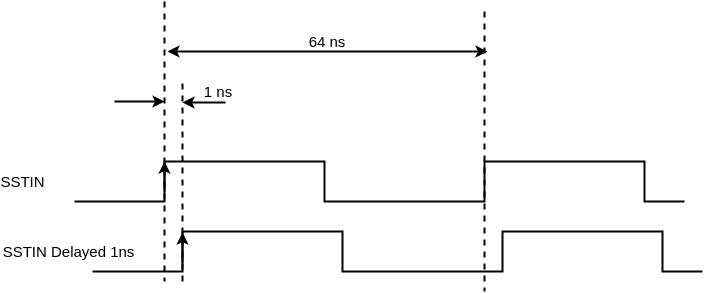
Documentation/TARGETC_Datasheet/figures/SSTIN.png
