sventurag/watchman-readout/Documentation/TARGETC_Datasheet/figures/SSTIN_signals.png

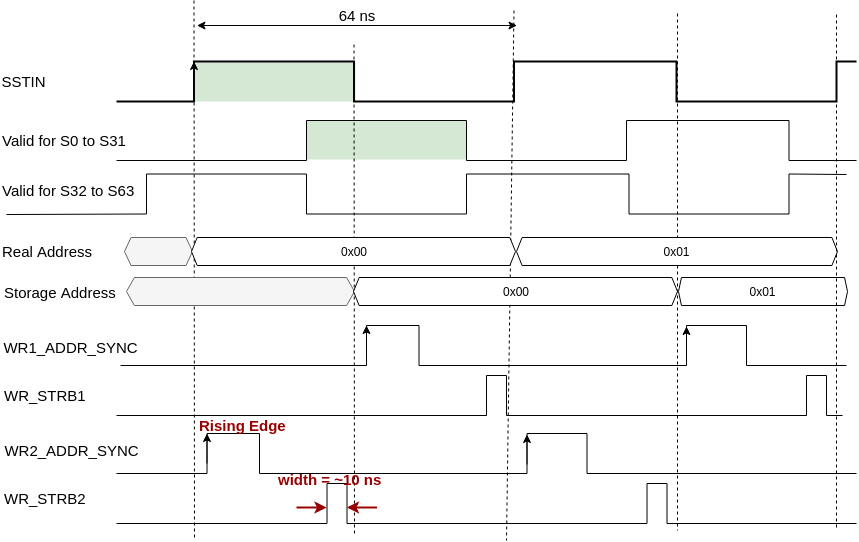
Documentation/TARGETC_Datasheet/figures/SSTIN_signals.png
