sventurag/watchman-readout/Documentation/TARGETC_Datasheet/figures/sstin_wr.png

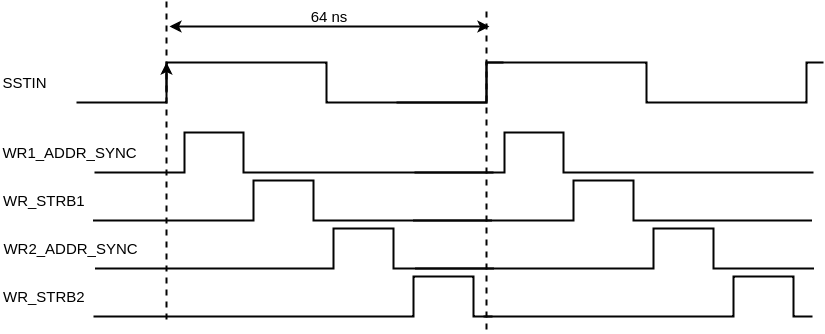
Documentation/TARGETC_Datasheet/figures/sstin_wr.png
