sventurag/watchman-readout/Documentation/TARGETC_Datasheet/figures/storagearea2.png

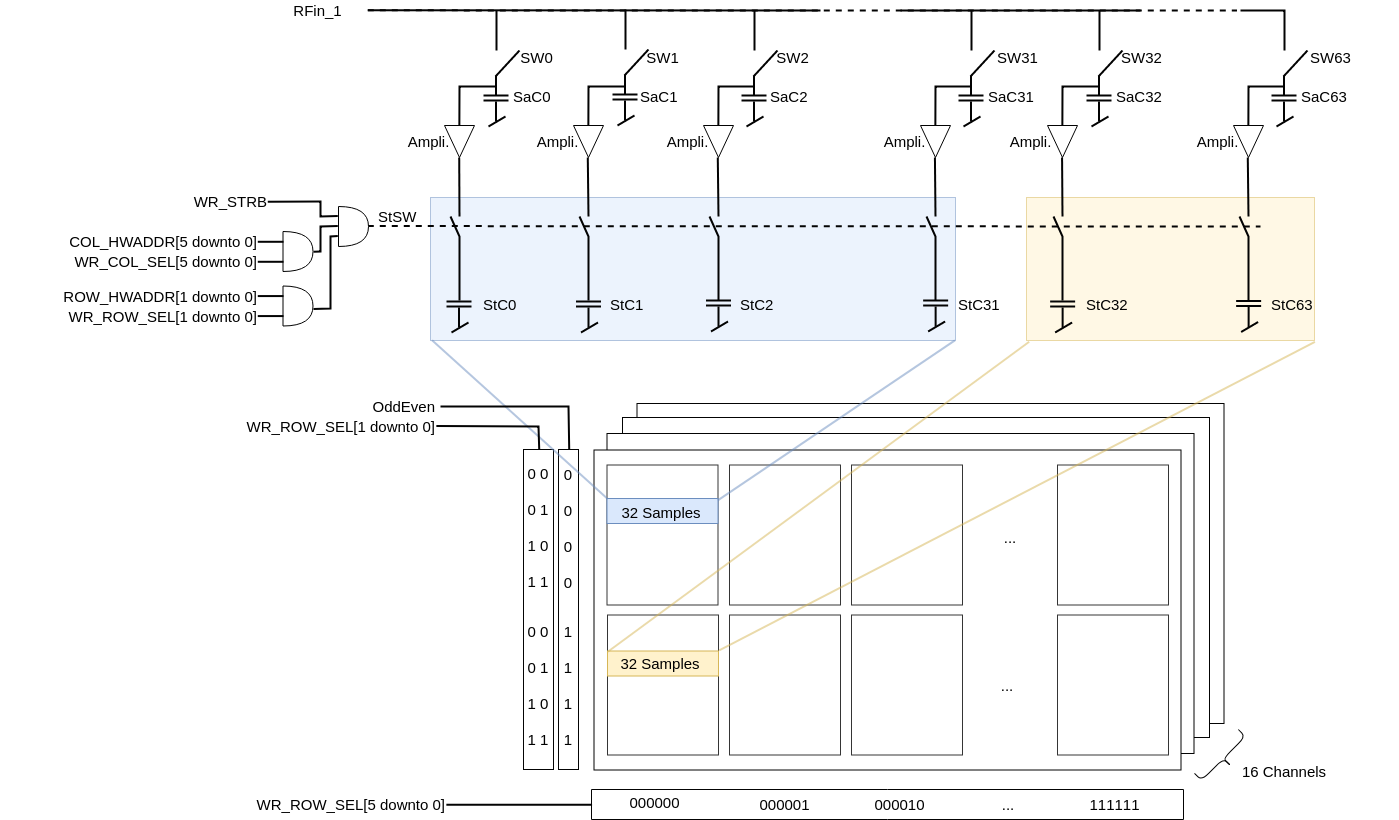
Documentation/TARGETC_Datasheet/figures/storagearea2.png
