sventurag/watchman-readout/Documentation/TARGETC_Datasheet/figures/StorageCell.png

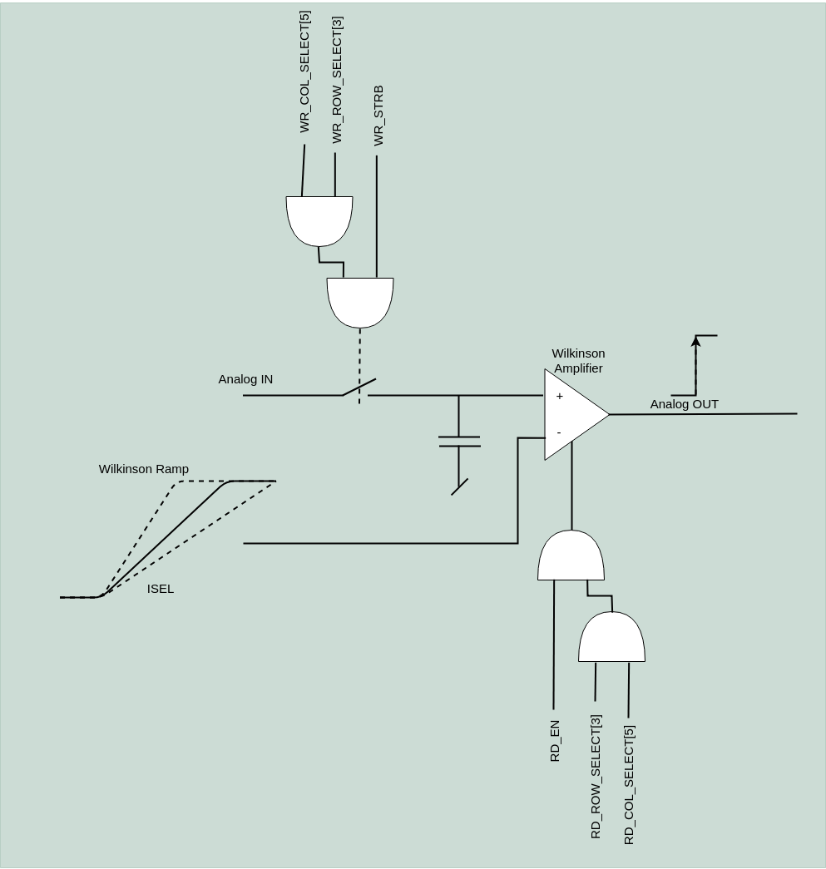
Documentation/TARGETC_Datasheet/figures/StorageCell.png
