sventurag/watchman-readout/Documentation/TARGETC_Datasheet/figures/StorageReadoutAddr.png

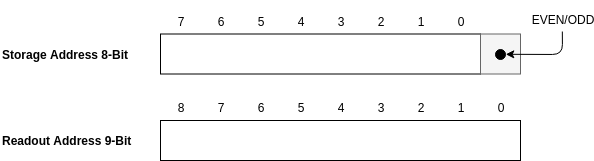
Documentation/TARGETC_Datasheet/figures/StorageReadoutAddr.png
