sventurag/watchman-readout/Documentation/TARGETC_Datasheet/figures/superbuffer.png

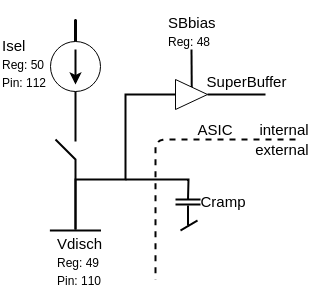
Documentation/TARGETC_Datasheet/figures/superbuffer.png
