sventurag/watchman-readout/Documentation/TARGETC_Datasheet/figures/TargetC_Top.png

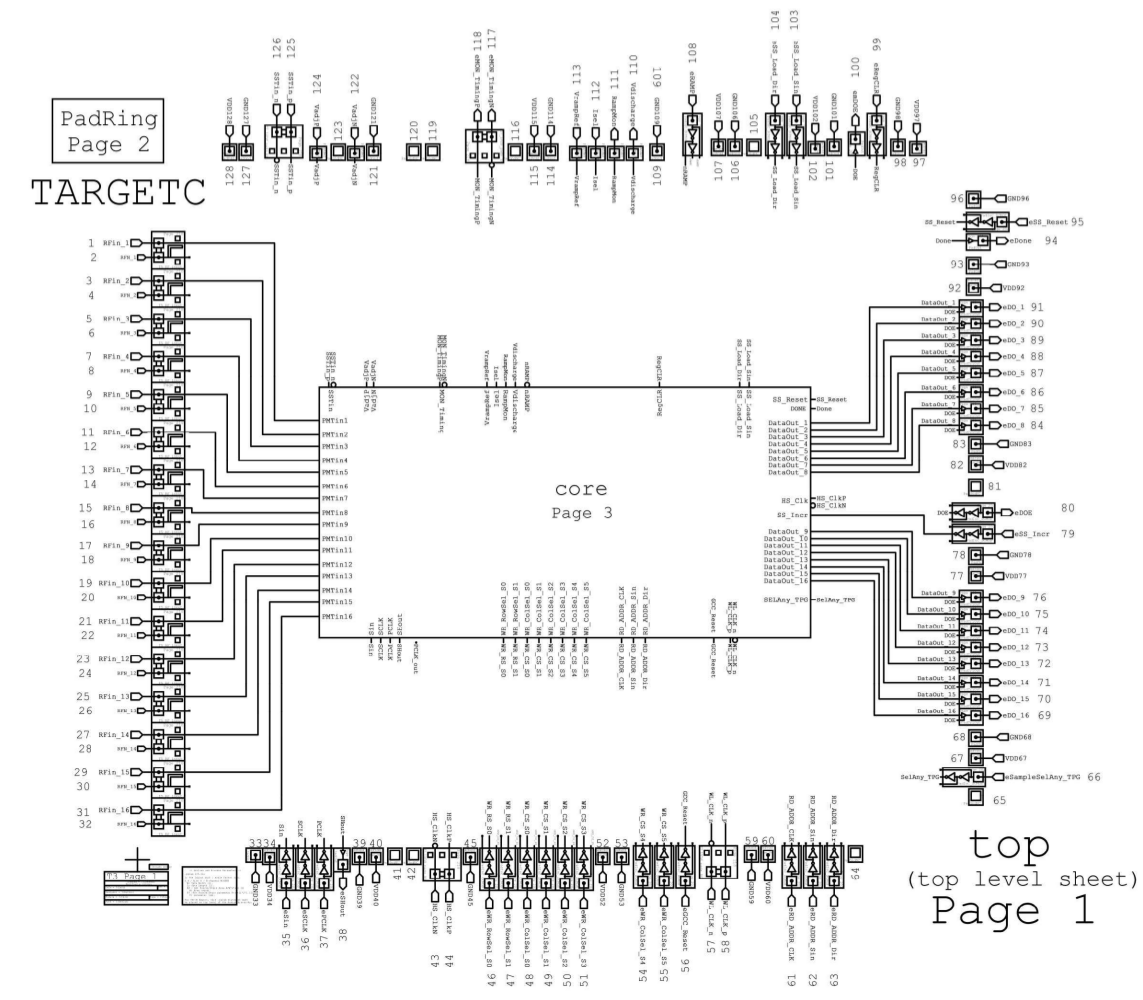
Documentation/TARGETC_Datasheet/figures/TargetC_Top.png
