sventurag/watchman-readout/Documentation/TARGETC_Datasheet/figures/TC_1dly.png

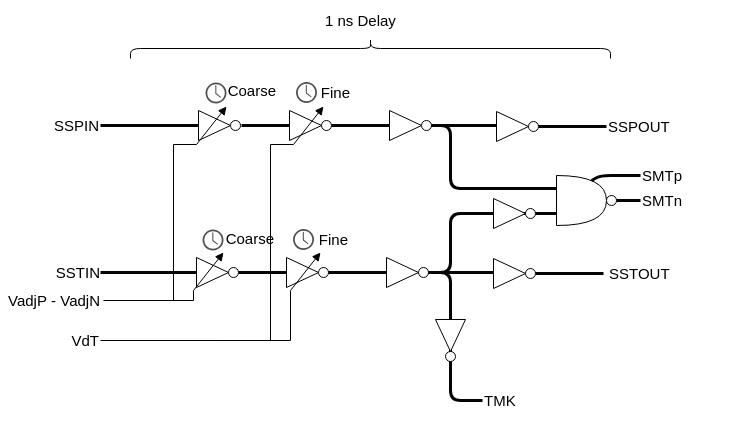
Documentation/TARGETC_Datasheet/figures/TC_1dly.png
