sventurag/watchman-readout/Documentation/TARGETC_Datasheet/figures/uhm.png

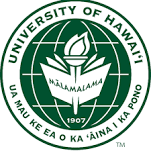
Documentation/TARGETC_Datasheet/figures/uhm.png
