sventurag/watchman-readout/Documentation/TARGETC_Datasheet/figures/vramp.png

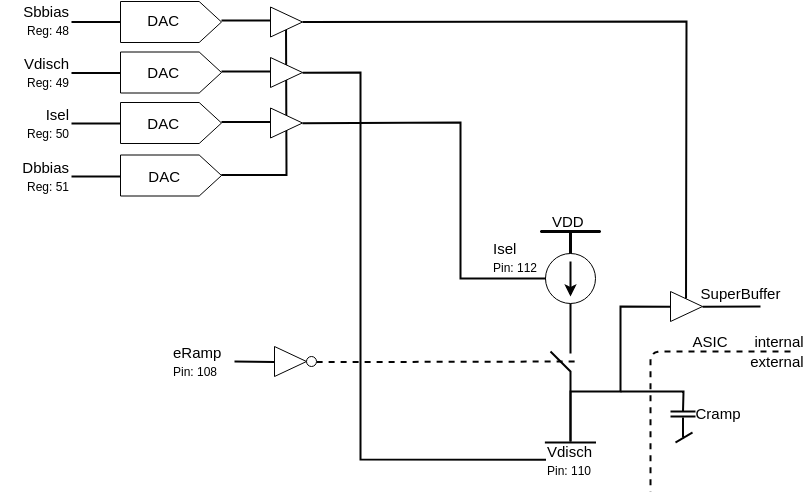
Documentation/TARGETC_Datasheet/figures/vramp.png
