sventurag/watchman-readout/Documentation/TARGETC_Datasheet/figures/wavedrom/registers2.png

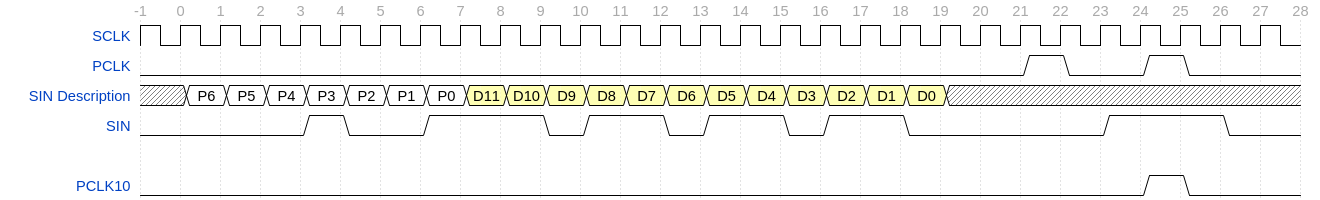
Documentation/TARGETC_Datasheet/figures/wavedrom/registers2.png
