sventurag/watchman-readout/Documentation/TARGETC_Datasheet/figures/wavedrom/registers.png

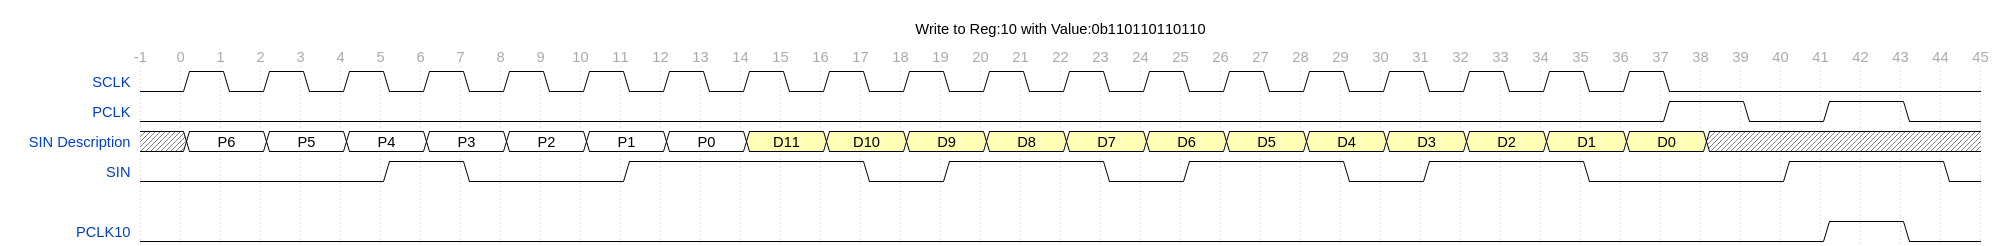
Documentation/TARGETC_Datasheet/figures/wavedrom/registers.png
