sventurag/watchman-readout/Documentation/TARGETC_Datasheet/figures/wavedrom/ssseq.png

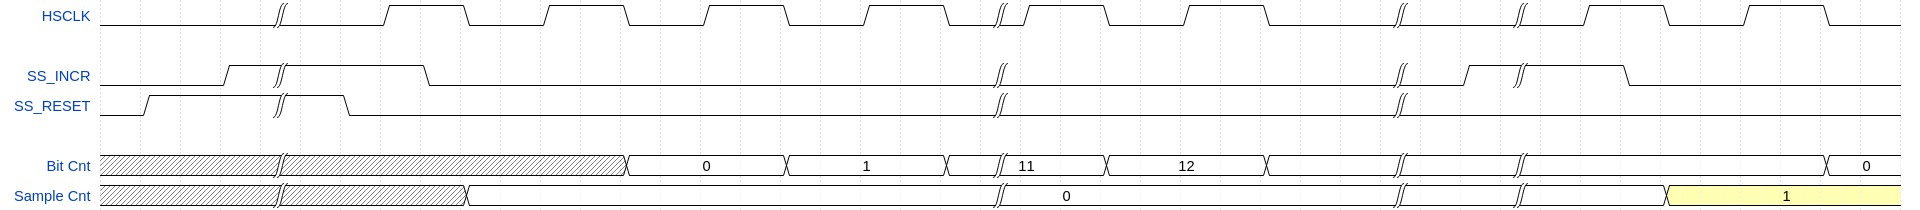
Documentation/TARGETC_Datasheet/figures/wavedrom/ssseq.png
