sventurag/watchman-readout/Documentation/TARGETC_Datasheet/figures/wavedrom/ssseq_2.png

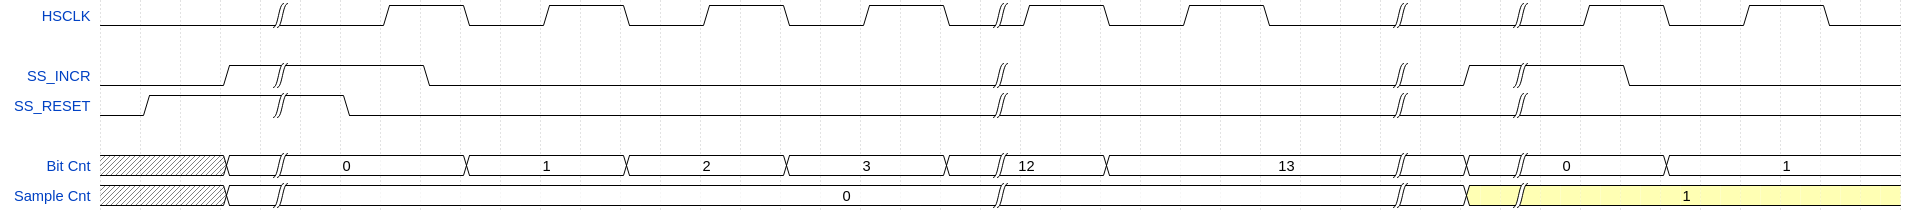
Documentation/TARGETC_Datasheet/figures/wavedrom/ssseq_2.png
