sventurag/watchman-readout/Documentation/TARGETC_Datasheet/figures/wavedrom/sstin_wr.png

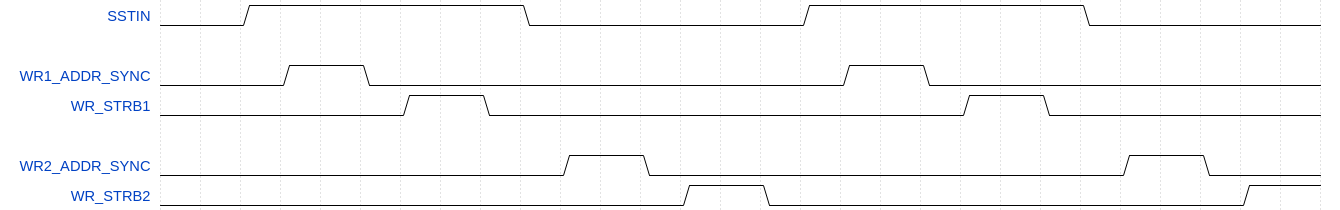
Documentation/TARGETC_Datasheet/figures/wavedrom/sstin_wr.png
