sventurag/watchman-readout/Documentation/TARGETC_Datasheet/figures/wavedrom/storageaddr.png

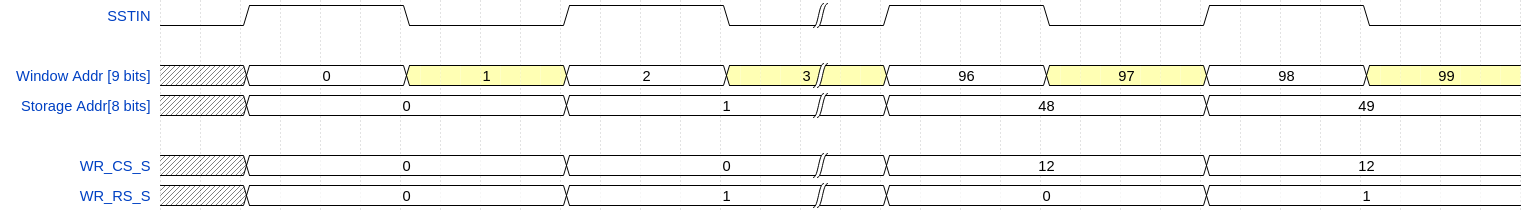
Documentation/TARGETC_Datasheet/figures/wavedrom/storageaddr.png
