sventurag/watchman-readout/Documentation/TARGETC_Datasheet/figures/wavedrom/storageaddr_correct.png

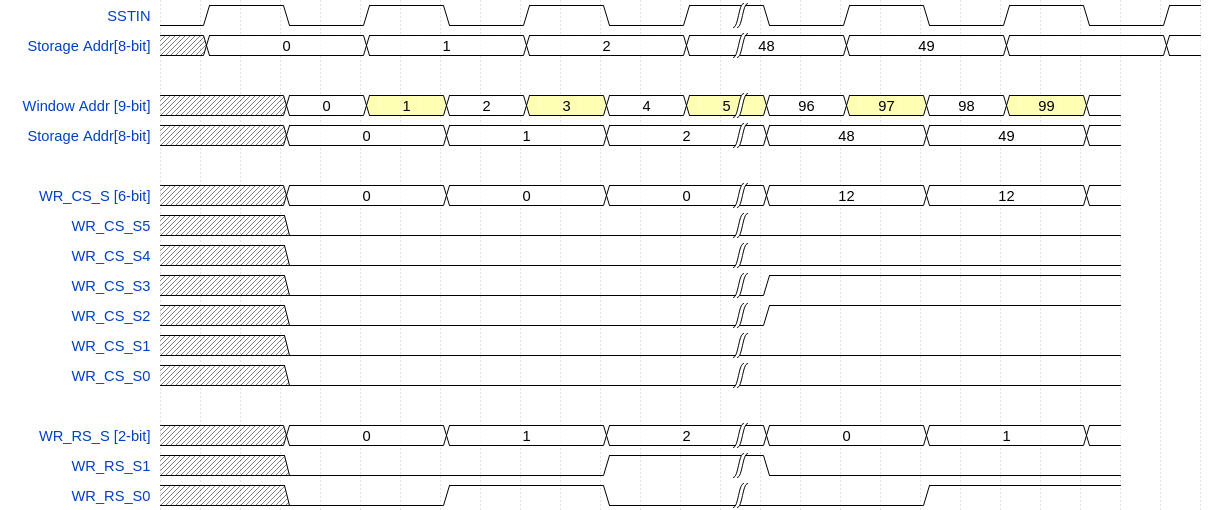
Documentation/TARGETC_Datasheet/figures/wavedrom/storageaddr_correct.png
