sventurag/watchman-readout/Documentation/TARGETC_Datasheet/figures/wavedrom/switchPulse.png

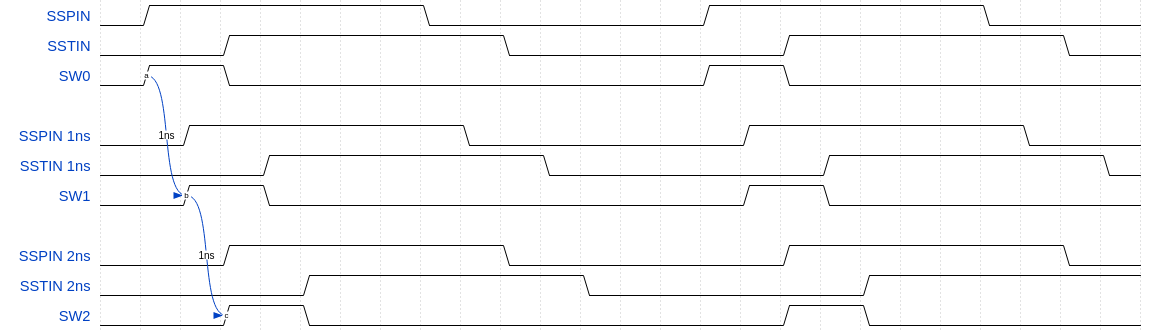
Documentation/TARGETC_Datasheet/figures/wavedrom/switchPulse.png
