sventurag/watchman-readout/Documentation/TARGETC_Datasheet/figures/wavedrom/wilkinsonseq.png

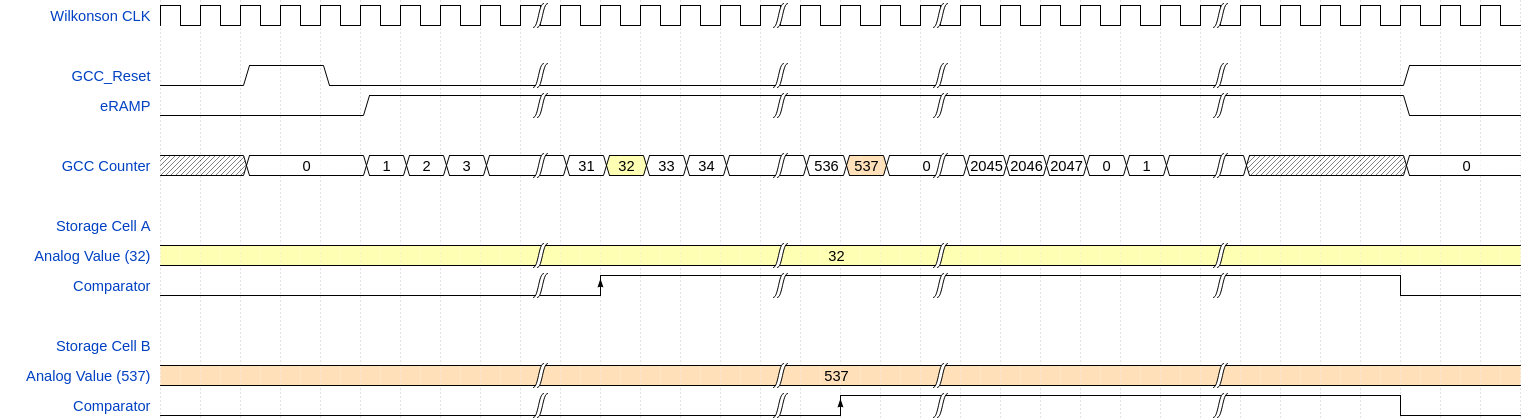
Documentation/TARGETC_Datasheet/figures/wavedrom/wilkinsonseq.png
