sventurag/watchman-readout/PCsoftware/Target0_2_5V_2300ISEL.png

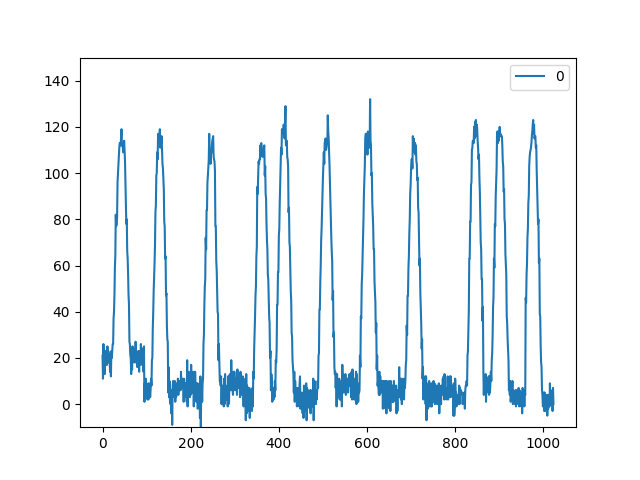
PCsoftware/Target0_2_5V_2300ISEL.png
