sventurag/watchman-readout/(threads)

Thread 4 (2019-11-16):

debug comparators signals

sventurag, 2019-11-16:
current state: no changes in the trigger[3 downto 0]  signal in the roundbuffer when a pulse is sent over the bnc inputs.
Possible causes:
- Wrong configuration in DAC for VPED and DAC_VOLTAGE to set the threshold, possible inverted signals.
- Mishandling of asynchronous signal in the TARGETC module.
Actions:
- Check test points
- Try different configurations for Vped and DAC_VOLTAGE.

sventurag, 2019-11-19:
Done, the comparators work with a threshold of 2.0, with a Vped = 1.75V

Closed 2019-11-19.

Thread 10 (2020-01-15):

Implement electronics delay in round buffer

sventurag, 2020-01-15:
Path of the PMT signal over the board introduce a delay in the trigger signal, causing errors when a window is digitized. This delay should be taken in account in the round buffer.

sventurag, 2020-02-27:
The implementation was tested on simulations

Closed 2020-02-27.
