sventurag/watchman-readout/6UVMEboard_Zynq/hw/Constraints/Timing.xdc

# ----------------------------------------------------------------------------
# TIMING Constraint File
# ----------------------------------------------------------------------------


set_property async_reg true [get_cells -hierarchical *cdc_reg*]
set_false_path -from [get_clocks *] -to [get_cells -hierarchical *cdc_reg*]

set_property async_reg true [get_cells -hierarchical *DFF_AB*]
#set_false_path -from [get_clocks *] -to [get_cells -hierarchical *DFF_AB*]

set_property async_reg true [get_cells -hierarchical *DFF_B*]
set_false_path -from [get_clocks *] -to [get_pins -hierarchical -filter Name=~*DFF_AB/Q_reg/D]

#set_property DRIVE 16 [get_ports BB3]
#set_property SLEW FAST [get_ports BB3]
set_property DIFF_TERM TRUE [get_ports MONTIMING_N]
set_property DIFF_TERM TRUE [get_ports MONTIMING_P]

set_false_path  -from [get_pins base_zynq_i/processing_system7_0/inst/PS7_i/MAXIGP0ACLK] -to [get_pins -filter Name=~*/CE -of [get_cells -hier -filter {name=~*/TCReg*}]]
