sventurag/watchman-readout/6UVMEboard_Zynq/ip_repo/TARGETC_1.0/drivers/TARGETC_v1_0/src/TARGETC.h

#ifndef TARGETC_H
#define TARGETC_H


/****************** Include Files ********************/
#include "xil_types.h"
#include "xstatus.h"

#define TARGETC_S00_AXI_SLV_REG0_OFFSET 0
#define TARGETC_S00_AXI_SLV_REG1_OFFSET 4
#define TARGETC_S00_AXI_SLV_REG2_OFFSET 8
#define TARGETC_S00_AXI_SLV_REG3_OFFSET 12
#define TARGETC_S00_AXI_SLV_REG4_OFFSET 16
#define TARGETC_S00_AXI_SLV_REG5_OFFSET 20
#define TARGETC_S00_AXI_SLV_REG6_OFFSET 24
#define TARGETC_S00_AXI_SLV_REG7_OFFSET 28
#define TARGETC_S00_AXI_SLV_REG8_OFFSET 32
#define TARGETC_S00_AXI_SLV_REG9_OFFSET 36
#define TARGETC_S00_AXI_SLV_REG10_OFFSET 40
#define TARGETC_S00_AXI_SLV_REG11_OFFSET 44
#define TARGETC_S00_AXI_SLV_REG12_OFFSET 48
#define TARGETC_S00_AXI_SLV_REG13_OFFSET 52
#define TARGETC_S00_AXI_SLV_REG14_OFFSET 56
#define TARGETC_S00_AXI_SLV_REG15_OFFSET 60
#define TARGETC_S00_AXI_SLV_REG16_OFFSET 64
#define TARGETC_S00_AXI_SLV_REG17_OFFSET 68
#define TARGETC_S00_AXI_SLV_REG18_OFFSET 72
#define TARGETC_S00_AXI_SLV_REG19_OFFSET 76
#define TARGETC_S00_AXI_SLV_REG20_OFFSET 80
#define TARGETC_S00_AXI_SLV_REG21_OFFSET 84
#define TARGETC_S00_AXI_SLV_REG22_OFFSET 88
#define TARGETC_S00_AXI_SLV_REG23_OFFSET 92
#define TARGETC_S00_AXI_SLV_REG24_OFFSET 96
#define TARGETC_S00_AXI_SLV_REG25_OFFSET 100
#define TARGETC_S00_AXI_SLV_REG26_OFFSET 104
#define TARGETC_S00_AXI_SLV_REG27_OFFSET 108
#define TARGETC_S00_AXI_SLV_REG28_OFFSET 112
#define TARGETC_S00_AXI_SLV_REG29_OFFSET 116
#define TARGETC_S00_AXI_SLV_REG30_OFFSET 120
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
#define TARGETC_S00_AXI_SLV_REG124_OFFSET 496
#define TARGETC_S00_AXI_SLV_REG125_OFFSET 500
#define TARGETC_S00_AXI_SLV_REG126_OFFSET 504
#define TARGETC_S00_AXI_SLV_REG127_OFFSET 508
#define TARGETC_S00_AXI_SLV_REG128_OFFSET 512
#define TARGETC_S00_AXI_SLV_REG129_OFFSET 516
#define TARGETC_S00_AXI_SLV_REG130_OFFSET 520
#define TARGETC_S00_AXI_SLV_REG131_OFFSET 524
#define TARGETC_S00_AXI_SLV_REG132_OFFSET 528
#define TARGETC_S00_AXI_SLV_REG133_OFFSET 532
#define TARGETC_S00_AXI_SLV_REG134_OFFSET 536
#define TARGETC_S00_AXI_SLV_REG135_OFFSET 540
#define TARGETC_S00_AXI_SLV_REG136_OFFSET 544
#define TARGETC_S00_AXI_SLV_REG137_OFFSET 548
#define TARGETC_S00_AXI_SLV_REG138_OFFSET 552
#define TARGETC_S00_AXI_SLV_REG139_OFFSET 556
#define TARGETC_S00_AXI_SLV_REG140_OFFSET 560
#define TARGETC_S00_AXI_SLV_REG141_OFFSET 564
#define TARGETC_S00_AXI_SLV_REG142_OFFSET 568
#define TARGETC_S00_AXI_SLV_REG143_OFFSET 572
#define TARGETC_S00_AXI_SLV_REG144_OFFSET 576
#define TARGETC_S00_AXI_SLV_REG145_OFFSET 580
#define TARGETC_S00_AXI_SLV_REG146_OFFSET 584
#define TARGETC_S00_AXI_SLV_REG147_OFFSET 588
#define TARGETC_S00_AXI_SLV_REG148_OFFSET 592
#define TARGETC_S00_AXI_SLV_REG149_OFFSET 596
#define TARGETC_S00_AXI_SLV_REG150_OFFSET 600
#define TARGETC_S00_AXI_SLV_REG151_OFFSET 604
#define TARGETC_S00_AXI_SLV_REG152_OFFSET 608


/**************************** Type Definitions *****************************/
/**
 *
 * Write a value to a TARGETC register. A 32 bit write is performed.
 * If the component is implemented in a smaller width, only the least
 * significant data is written.
 *
 * @param   BaseAddress is the base address of the TARGETCdevice.
 * @param   RegOffset is the register offset from the base to write to.
 * @param   Data is the data written to the register.
 *
 * @return  None.
 *
 * @note
 * C-style signature:
 * 	void TARGETC_mWriteReg(u32 BaseAddress, unsigned RegOffset, u32 Data)
 *
 */
#define TARGETC_mWriteReg(BaseAddress, RegOffset, Data) \
  	Xil_Out32((BaseAddress) + (RegOffset), (u32)(Data))

/**
 *
 * Read a value from a TARGETC register. A 32 bit read is performed.
 * If the component is implemented in a smaller width, only the least
 * significant data is read from the register. The most significant data
 * will be read as 0.
 *
 * @param   BaseAddress is the base address of the TARGETC device.
 * @param   RegOffset is the register offset from the base to write to.
 *
 * @return  Data is the data from the register.
 *
 * @note
 * C-style signature:
 * 	u32 TARGETC_mReadReg(u32 BaseAddress, unsigned RegOffset)
 *
 */
#define TARGETC_mReadReg(BaseAddress, RegOffset) \
    Xil_In32((BaseAddress) + (RegOffset))

/************************** Function Prototypes ****************************/
/**
 *
 * Run a self-test on the driver/device. Note this may be a destructive test if
 * resets of the device are performed.
 *
 * If the hardware system is not built correctly, this function may never
 * return to the caller.
 *
 * @param   baseaddr_p is the base address of the TARGETC instance to be worked on.
 *
 * @return
 *
 *    - XST_SUCCESS   if all self-test code passed
 *    - XST_FAILURE   if any self-test code failed
 *
 * @note    Caching must be turned off for this function to work.
 * @note    Self test may fail if data memory and device are not on the same bus.
 *
 */
XStatus TARGETC_Reg_SelfTest(void * baseaddr_p);

#endif // TARGETC_H
