sventurag/watchman-readout/6UVMEboard_Zynq/hw/bd/base_zynq/synth/base_zynq.vhd

--Copyright 1986-2020 Xilinx, Inc. All Rights Reserved.
----------------------------------------------------------------------------------
--Tool Version: Vivado v.2020.2 (lin64) Build 3064766 Wed Nov 18 09:12:47 MST 2020
--Date        : Wed Jul  7 11:24:21 2021
--Host        : idlab2 running 64-bit Ubuntu 20.04.2 LTS
--Command     : generate_target base_zynq.bd
--Design      : base_zynq
--Purpose     : IP block netlist
----------------------------------------------------------------------------------
library IEEE;
use IEEE.STD_LOGIC_1164.ALL;
library UNISIM;
use UNISIM.VCOMPONENTS.ALL;
entity m00_couplers_imp_DSJXWU is
  port (
    M_AXIS_ACLK : in STD_LOGIC;
    M_AXIS_ARESETN : in STD_LOGIC;
    M_AXIS_tdata : out STD_LOGIC_VECTOR ( 31 downto 0 );
    M_AXIS_tkeep : out STD_LOGIC_VECTOR ( 3 downto 0 );
    M_AXIS_tlast : out STD_LOGIC;
    M_AXIS_tready : in STD_LOGIC;
    M_AXIS_tvalid : out STD_LOGIC;
    S_AXIS_ACLK : in STD_LOGIC;
    S_AXIS_ARESETN : in STD_LOGIC;
    S_AXIS_tdata : in STD_LOGIC_VECTOR ( 31 downto 0 );
    S_AXIS_tid : in STD_LOGIC_VECTOR ( 1 downto 0 );
    S_AXIS_tlast : in STD_LOGIC;
    S_AXIS_tready : out STD_LOGIC;
    S_AXIS_tstrb : in STD_LOGIC_VECTOR ( 3 downto 0 );
    S_AXIS_tvalid : in STD_LOGIC
  );
end m00_couplers_imp_DSJXWU;

architecture STRUCTURE of m00_couplers_imp_DSJXWU is
  component base_zynq_m00_data_fifo_0 is
  port (
    s_axis_aresetn : in STD_LOGIC;
    s_axis_aclk : in STD_LOGIC;
    s_axis_tvalid : in STD_LOGIC;
    s_axis_tready : out STD_LOGIC;
    s_axis_tdata : in STD_LOGIC_VECTOR ( 31 downto 0 );
    s_axis_tstrb : in STD_LOGIC_VECTOR ( 3 downto 0 );
    s_axis_tlast : in STD_LOGIC;
    s_axis_tid : in STD_LOGIC_VECTOR ( 1 downto 0 );
    m_axis_tvalid : out STD_LOGIC;
    m_axis_tready : in STD_LOGIC;
    m_axis_tdata : out STD_LOGIC_VECTOR ( 31 downto 0 );
    m_axis_tstrb : out STD_LOGIC_VECTOR ( 3 downto 0 );
    m_axis_tlast : out STD_LOGIC;
    m_axis_tid : out STD_LOGIC_VECTOR ( 1 downto 0 );
    axis_wr_data_count : out STD_LOGIC_VECTOR ( 31 downto 0 );
    axis_rd_data_count : out STD_LOGIC_VECTOR ( 31 downto 0 )
  );
  end component base_zynq_m00_data_fifo_0;
  component base_zynq_auto_ss_k_0 is
  port (
    aclk : in STD_LOGIC;
    aresetn : in STD_LOGIC;
    s_axis_tvalid : in STD_LOGIC;
    s_axis_tready : out STD_LOGIC;
    s_axis_tdata : in STD_LOGIC_VECTOR ( 31 downto 0 );
    s_axis_tstrb : in STD_LOGIC_VECTOR ( 3 downto 0 );
    s_axis_tlast : in STD_LOGIC;
    s_axis_tid : in STD_LOGIC_VECTOR ( 1 downto 0 );
    m_axis_tvalid : out STD_LOGIC;
    m_axis_tready : in STD_LOGIC;
    m_axis_tdata : out STD_LOGIC_VECTOR ( 31 downto 0 );
    m_axis_tstrb : out STD_LOGIC_VECTOR ( 3 downto 0 );
    m_axis_tkeep : out STD_LOGIC_VECTOR ( 3 downto 0 );
    m_axis_tlast : out STD_LOGIC;
    m_axis_tid : out STD_LOGIC_VECTOR ( 1 downto 0 )
  );
  end component base_zynq_auto_ss_k_0;
  component base_zynq_auto_ss_slidr_0 is
  port (
    aclk : in STD_LOGIC;
    aresetn : in STD_LOGIC;
    s_axis_tvalid : in STD_LOGIC;
    s_axis_tready : out STD_LOGIC;
    s_axis_tdata : in STD_LOGIC_VECTOR ( 31 downto 0 );
    s_axis_tstrb : in STD_LOGIC_VECTOR ( 3 downto 0 );
    s_axis_tkeep : in STD_LOGIC_VECTOR ( 3 downto 0 );
    s_axis_tlast : in STD_LOGIC;
    s_axis_tid : in STD_LOGIC_VECTOR ( 1 downto 0 );
    m_axis_tvalid : out STD_LOGIC;
    m_axis_tready : in STD_LOGIC;
    m_axis_tdata : out STD_LOGIC_VECTOR ( 31 downto 0 );
    m_axis_tkeep : out STD_LOGIC_VECTOR ( 3 downto 0 );
    m_axis_tlast : out STD_LOGIC
  );
  end component base_zynq_auto_ss_slidr_0;
  signal AXIS_RD_DATA_COUNT_to_S_AXIS_RD_DATA_COUNT : STD_LOGIC_VECTOR ( 31 downto 0 );
  signal AXIS_WR_DATA_COUNT_to_S_AXIS_WR_DATA_COUNT : STD_LOGIC_VECTOR ( 31 downto 0 );
  signal auto_ss_k_to_auto_ss_slidr_TDATA : STD_LOGIC_VECTOR ( 31 downto 0 );
  signal auto_ss_k_to_auto_ss_slidr_TID : STD_LOGIC_VECTOR ( 1 downto 0 );
  signal auto_ss_k_to_auto_ss_slidr_TKEEP : STD_LOGIC_VECTOR ( 3 downto 0 );
  signal auto_ss_k_to_auto_ss_slidr_TLAST : STD_LOGIC;
  signal auto_ss_k_to_auto_ss_slidr_TREADY : STD_LOGIC;
  signal auto_ss_k_to_auto_ss_slidr_TSTRB : STD_LOGIC_VECTOR ( 3 downto 0 );
  signal auto_ss_k_to_auto_ss_slidr_TVALID : STD_LOGIC;
  signal auto_ss_slidr_to_m00_couplers_TDATA : STD_LOGIC_VECTOR ( 31 downto 0 );
  signal auto_ss_slidr_to_m00_couplers_TKEEP : STD_LOGIC_VECTOR ( 3 downto 0 );
  signal auto_ss_slidr_to_m00_couplers_TLAST : STD_LOGIC;
  signal auto_ss_slidr_to_m00_couplers_TREADY : STD_LOGIC;
  signal auto_ss_slidr_to_m00_couplers_TVALID : STD_LOGIC;
  signal m00_couplers_to_m00_data_fifo_TDATA : STD_LOGIC_VECTOR ( 31 downto 0 );
  signal m00_couplers_to_m00_data_fifo_TID : STD_LOGIC_VECTOR ( 1 downto 0 );
  signal m00_couplers_to_m00_data_fifo_TLAST : STD_LOGIC;
  signal m00_couplers_to_m00_data_fifo_TREADY : STD_LOGIC;
  signal m00_couplers_to_m00_data_fifo_TSTRB : STD_LOGIC_VECTOR ( 3 downto 0 );
  signal m00_couplers_to_m00_data_fifo_TVALID : STD_LOGIC;
  signal m00_data_fifo_to_auto_ss_k_TDATA : STD_LOGIC_VECTOR ( 31 downto 0 );
  signal m00_data_fifo_to_auto_ss_k_TID : STD_LOGIC_VECTOR ( 1 downto 0 );
  signal m00_data_fifo_to_auto_ss_k_TLAST : STD_LOGIC;
  signal m00_data_fifo_to_auto_ss_k_TREADY : STD_LOGIC;
  signal m00_data_fifo_to_auto_ss_k_TSTRB : STD_LOGIC_VECTOR ( 3 downto 0 );
  signal m00_data_fifo_to_auto_ss_k_TVALID : STD_LOGIC;
begin
  M_AXIS_tdata(31 downto 0) <= auto_ss_slidr_to_m00_couplers_TDATA(31 downto 0);
  M_AXIS_tkeep(3 downto 0) <= auto_ss_slidr_to_m00_couplers_TKEEP(3 downto 0);
  M_AXIS_tlast <= auto_ss_slidr_to_m00_couplers_TLAST;
  M_AXIS_tvalid <= auto_ss_slidr_to_m00_couplers_TVALID;
  S_AXIS_tready <= m00_couplers_to_m00_data_fifo_TREADY;
  auto_ss_slidr_to_m00_couplers_TREADY <= M_AXIS_tready;
  m00_couplers_to_m00_data_fifo_TDATA(31 downto 0) <= S_AXIS_tdata(31 downto 0);
  m00_couplers_to_m00_data_fifo_TID(1 downto 0) <= S_AXIS_tid(1 downto 0);
  m00_couplers_to_m00_data_fifo_TLAST <= S_AXIS_tlast;
  m00_couplers_to_m00_data_fifo_TSTRB(3 downto 0) <= S_AXIS_tstrb(3 downto 0);
  m00_couplers_to_m00_data_fifo_TVALID <= S_AXIS_tvalid;
auto_ss_k: component base_zynq_auto_ss_k_0
     port map (
      aclk => S_AXIS_ACLK,
      aresetn => S_AXIS_ARESETN,
      m_axis_tdata(31 downto 0) => auto_ss_k_to_auto_ss_slidr_TDATA(31 downto 0),
      m_axis_tid(1 downto 0) => auto_ss_k_to_auto_ss_slidr_TID(1 downto 0),
      m_axis_tkeep(3 downto 0) => auto_ss_k_to_auto_ss_slidr_TKEEP(3 downto 0),
      m_axis_tlast => auto_ss_k_to_auto_ss_slidr_TLAST,
      m_axis_tready => auto_ss_k_to_auto_ss_slidr_TREADY,
      m_axis_tstrb(3 downto 0) => auto_ss_k_to_auto_ss_slidr_TSTRB(3 downto 0),
      m_axis_tvalid => auto_ss_k_to_auto_ss_slidr_TVALID,
      s_axis_tdata(31 downto 0) => m00_data_fifo_to_auto_ss_k_TDATA(31 downto 0),
      s_axis_tid(1 downto 0) => m00_data_fifo_to_auto_ss_k_TID(1 downto 0),
      s_axis_tlast => m00_data_fifo_to_auto_ss_k_TLAST,
      s_axis_tready => m00_data_fifo_to_auto_ss_k_TREADY,
      s_axis_tstrb(3 downto 0) => m00_data_fifo_to_auto_ss_k_TSTRB(3 downto 0),
      s_axis_tvalid => m00_data_fifo_to_auto_ss_k_TVALID
    );
auto_ss_slidr: component base_zynq_auto_ss_slidr_0
     port map (
      aclk => S_AXIS_ACLK,
      aresetn => S_AXIS_ARESETN,
      m_axis_tdata(31 downto 0) => auto_ss_slidr_to_m00_couplers_TDATA(31 downto 0),
      m_axis_tkeep(3 downto 0) => auto_ss_slidr_to_m00_couplers_TKEEP(3 downto 0),
      m_axis_tlast => auto_ss_slidr_to_m00_couplers_TLAST,
      m_axis_tready => auto_ss_slidr_to_m00_couplers_TREADY,
      m_axis_tvalid => auto_ss_slidr_to_m00_couplers_TVALID,
      s_axis_tdata(31 downto 0) => auto_ss_k_to_auto_ss_slidr_TDATA(31 downto 0),
      s_axis_tid(1 downto 0) => auto_ss_k_to_auto_ss_slidr_TID(1 downto 0),
      s_axis_tkeep(3 downto 0) => auto_ss_k_to_auto_ss_slidr_TKEEP(3 downto 0),
      s_axis_tlast => auto_ss_k_to_auto_ss_slidr_TLAST,
      s_axis_tready => auto_ss_k_to_auto_ss_slidr_TREADY,
      s_axis_tstrb(3 downto 0) => auto_ss_k_to_auto_ss_slidr_TSTRB(3 downto 0),
      s_axis_tvalid => auto_ss_k_to_auto_ss_slidr_TVALID
    );
m00_data_fifo: component base_zynq_m00_data_fifo_0
     port map (
      axis_rd_data_count(31 downto 0) => AXIS_RD_DATA_COUNT_to_S_AXIS_RD_DATA_COUNT(31 downto 0),
      axis_wr_data_count(31 downto 0) => AXIS_WR_DATA_COUNT_to_S_AXIS_WR_DATA_COUNT(31 downto 0),
      m_axis_tdata(31 downto 0) => m00_data_fifo_to_auto_ss_k_TDATA(31 downto 0),
      m_axis_tid(1 downto 0) => m00_data_fifo_to_auto_ss_k_TID(1 downto 0),
      m_axis_tlast => m00_data_fifo_to_auto_ss_k_TLAST,
      m_axis_tready => m00_data_fifo_to_auto_ss_k_TREADY,
      m_axis_tstrb(3 downto 0) => m00_data_fifo_to_auto_ss_k_TSTRB(3 downto 0),
      m_axis_tvalid => m00_data_fifo_to_auto_ss_k_TVALID,
      s_axis_aclk => S_AXIS_ACLK,
      s_axis_aresetn => S_AXIS_ARESETN,
      s_axis_tdata(31 downto 0) => m00_couplers_to_m00_data_fifo_TDATA(31 downto 0),
      s_axis_tid(1 downto 0) => m00_couplers_to_m00_data_fifo_TID(1 downto 0),
      s_axis_tlast => m00_couplers_to_m00_data_fifo_TLAST,
      s_axis_tready => m00_couplers_to_m00_data_fifo_TREADY,
      s_axis_tstrb(3 downto 0) => m00_couplers_to_m00_data_fifo_TSTRB(3 downto 0),
      s_axis_tvalid => m00_couplers_to_m00_data_fifo_TVALID
    );
end STRUCTURE;
library IEEE;
use IEEE.STD_LOGIC_1164.ALL;
library UNISIM;
use UNISIM.VCOMPONENTS.ALL;
entity m00_couplers_imp_QHT96L is
  port (
    M_ACLK : in STD_LOGIC;
    M_ARESETN : in STD_LOGIC;
    M_AXI_araddr : out STD_LOGIC_VECTOR ( 31 downto 0 );
    M_AXI_arprot : out STD_LOGIC_VECTOR ( 2 downto 0 );
    M_AXI_arready : in STD_LOGIC;
    M_AXI_arvalid : out STD_LOGIC;
    M_AXI_awaddr : out STD_LOGIC_VECTOR ( 31 downto 0 );
    M_AXI_awprot : out STD_LOGIC_VECTOR ( 2 downto 0 );
    M_AXI_awready : in STD_LOGIC;
    M_AXI_awvalid : out STD_LOGIC;
    M_AXI_bready : out STD_LOGIC;
    M_AXI_bresp : in STD_LOGIC_VECTOR ( 1 downto 0 );
    M_AXI_bvalid : in STD_LOGIC;
    M_AXI_rdata : in STD_LOGIC_VECTOR ( 31 downto 0 );
    M_AXI_rready : out STD_LOGIC;
    M_AXI_rresp : in STD_LOGIC_VECTOR ( 1 downto 0 );
    M_AXI_rvalid : in STD_LOGIC;
    M_AXI_wdata : out STD_LOGIC_VECTOR ( 31 downto 0 );
    M_AXI_wready : in STD_LOGIC;
    M_AXI_wstrb : out STD_LOGIC_VECTOR ( 3 downto 0 );
    M_AXI_wvalid : out STD_LOGIC;
    S_ACLK : in STD_LOGIC;
    S_ARESETN : in STD_LOGIC;
    S_AXI_araddr : in STD_LOGIC_VECTOR ( 31 downto 0 );
    S_AXI_arprot : in STD_LOGIC_VECTOR ( 2 downto 0 );
    S_AXI_arready : out STD_LOGIC;
    S_AXI_arvalid : in STD_LOGIC;
    S_AXI_awaddr : in STD_LOGIC_VECTOR ( 31 downto 0 );
    S_AXI_awprot : in STD_LOGIC_VECTOR ( 2 downto 0 );
    S_AXI_awready : out STD_LOGIC;
    S_AXI_awvalid : in STD_LOGIC;
    S_AXI_bready : in STD_LOGIC;
    S_AXI_bresp : out STD_LOGIC_VECTOR ( 1 downto 0 );
    S_AXI_bvalid : out STD_LOGIC;
    S_AXI_rdata : out STD_LOGIC_VECTOR ( 31 downto 0 );
    S_AXI_rready : in STD_LOGIC;
    S_AXI_rresp : out STD_LOGIC_VECTOR ( 1 downto 0 );
    S_AXI_rvalid : out STD_LOGIC;
    S_AXI_wdata : in STD_LOGIC_VECTOR ( 31 downto 0 );
    S_AXI_wready : out STD_LOGIC;
    S_AXI_wstrb : in STD_LOGIC_VECTOR ( 3 downto 0 );
    S_AXI_wvalid : in STD_LOGIC
  );
end m00_couplers_imp_QHT96L;

architecture STRUCTURE of m00_couplers_imp_QHT96L is
  signal m00_couplers_to_m00_couplers_ARADDR : STD_LOGIC_VECTOR ( 31 downto 0 );
  signal m00_couplers_to_m00_couplers_ARPROT : STD_LOGIC_VECTOR ( 2 downto 0 );
  signal m00_couplers_to_m00_couplers_ARREADY : STD_LOGIC;
  signal m00_couplers_to_m00_couplers_ARVALID : STD_LOGIC;
  signal m00_couplers_to_m00_couplers_AWADDR : STD_LOGIC_VECTOR ( 31 downto 0 );
  signal m00_couplers_to_m00_couplers_AWPROT : STD_LOGIC_VECTOR ( 2 downto 0 );
  signal m00_couplers_to_m00_couplers_AWREADY : STD_LOGIC;
  signal m00_couplers_to_m00_couplers_AWVALID : STD_LOGIC;
  signal m00_couplers_to_m00_couplers_BREADY : STD_LOGIC;
  signal m00_couplers_to_m00_couplers_BRESP : STD_LOGIC_VECTOR ( 1 downto 0 );
  signal m00_couplers_to_m00_couplers_BVALID : STD_LOGIC;
  signal m00_couplers_to_m00_couplers_RDATA : STD_LOGIC_VECTOR ( 31 downto 0 );
  signal m00_couplers_to_m00_couplers_RREADY : STD_LOGIC;
  signal m00_couplers_to_m00_couplers_RRESP : STD_LOGIC_VECTOR ( 1 downto 0 );
  signal m00_couplers_to_m00_couplers_RVALID : STD_LOGIC;
  signal m00_couplers_to_m00_couplers_WDATA : STD_LOGIC_VECTOR ( 31 downto 0 );
  signal m00_couplers_to_m00_couplers_WREADY : STD_LOGIC;
  signal m00_couplers_to_m00_couplers_WSTRB : STD_LOGIC_VECTOR ( 3 downto 0 );
  signal m00_couplers_to_m00_couplers_WVALID : STD_LOGIC;
begin
  M_AXI_araddr(31 downto 0) <= m00_couplers_to_m00_couplers_ARADDR(31 downto 0);
  M_AXI_arprot(2 downto 0) <= m00_couplers_to_m00_couplers_ARPROT(2 downto 0);
  M_AXI_arvalid <= m00_couplers_to_m00_couplers_ARVALID;
  M_AXI_awaddr(31 downto 0) <= m00_couplers_to_m00_couplers_AWADDR(31 downto 0);
  M_AXI_awprot(2 downto 0) <= m00_couplers_to_m00_couplers_AWPROT(2 downto 0);
  M_AXI_awvalid <= m00_couplers_to_m00_couplers_AWVALID;
  M_AXI_bready <= m00_couplers_to_m00_couplers_BREADY;
  M_AXI_rready <= m00_couplers_to_m00_couplers_RREADY;
  M_AXI_wdata(31 downto 0) <= m00_couplers_to_m00_couplers_WDATA(31 downto 0);
  M_AXI_wstrb(3 downto 0) <= m00_couplers_to_m00_couplers_WSTRB(3 downto 0);
  M_AXI_wvalid <= m00_couplers_to_m00_couplers_WVALID;
  S_AXI_arready <= m00_couplers_to_m00_couplers_ARREADY;
  S_AXI_awready <= m00_couplers_to_m00_couplers_AWREADY;
  S_AXI_bresp(1 downto 0) <= m00_couplers_to_m00_couplers_BRESP(1 downto 0);
  S_AXI_bvalid <= m00_couplers_to_m00_couplers_BVALID;
  S_AXI_rdata(31 downto 0) <= m00_couplers_to_m00_couplers_RDATA(31 downto 0);
  S_AXI_rresp(1 downto 0) <= m00_couplers_to_m00_couplers_RRESP(1 downto 0);
  S_AXI_rvalid <= m00_couplers_to_m00_couplers_RVALID;
  S_AXI_wready <= m00_couplers_to_m00_couplers_WREADY;
  m00_couplers_to_m00_couplers_ARADDR(31 downto 0) <= S_AXI_araddr(31 downto 0);
  m00_couplers_to_m00_couplers_ARPROT(2 downto 0) <= S_AXI_arprot(2 downto 0);
  m00_couplers_to_m00_couplers_ARREADY <= M_AXI_arready;
  m00_couplers_to_m00_couplers_ARVALID <= S_AXI_arvalid;
  m00_couplers_to_m00_couplers_AWADDR(31 downto 0) <= S_AXI_awaddr(31 downto 0);
  m00_couplers_to_m00_couplers_AWPROT(2 downto 0) <= S_AXI_awprot(2 downto 0);
  m00_couplers_to_m00_couplers_AWREADY <= M_AXI_awready;
  m00_couplers_to_m00_couplers_AWVALID <= S_AXI_awvalid;
  m00_couplers_to_m00_couplers_BREADY <= S_AXI_bready;
  m00_couplers_to_m00_couplers_BRESP(1 downto 0) <= M_AXI_bresp(1 downto 0);
  m00_couplers_to_m00_couplers_BVALID <= M_AXI_bvalid;
  m00_couplers_to_m00_couplers_RDATA(31 downto 0) <= M_AXI_rdata(31 downto 0);
  m00_couplers_to_m00_couplers_RREADY <= S_AXI_rready;
  m00_couplers_to_m00_couplers_RRESP(1 downto 0) <= M_AXI_rresp(1 downto 0);
  m00_couplers_to_m00_couplers_RVALID <= M_AXI_rvalid;
  m00_couplers_to_m00_couplers_WDATA(31 downto 0) <= S_AXI_wdata(31 downto 0);
  m00_couplers_to_m00_couplers_WREADY <= M_AXI_wready;
  m00_couplers_to_m00_couplers_WSTRB(3 downto 0) <= S_AXI_wstrb(3 downto 0);
  m00_couplers_to_m00_couplers_WVALID <= S_AXI_wvalid;
end STRUCTURE;
library IEEE;
use IEEE.STD_LOGIC_1164.ALL;
library UNISIM;
use UNISIM.VCOMPONENTS.ALL;
entity m01_couplers_imp_11WP2HX is
  port (
    M_ACLK : in STD_LOGIC;
    M_ARESETN : in STD_LOGIC;
    M_AXI_araddr : out STD_LOGIC_VECTOR ( 31 downto 0 );
    M_AXI_arready : in STD_LOGIC_VECTOR ( 0 to 0 );
    M_AXI_arvalid : out STD_LOGIC_VECTOR ( 0 to 0 );
    M_AXI_awaddr : out STD_LOGIC_VECTOR ( 31 downto 0 );
    M_AXI_awready : in STD_LOGIC_VECTOR ( 0 to 0 );
    M_AXI_awvalid : out STD_LOGIC_VECTOR ( 0 to 0 );
    M_AXI_bready : out STD_LOGIC_VECTOR ( 0 to 0 );
    M_AXI_bresp : in STD_LOGIC_VECTOR ( 1 downto 0 );
    M_AXI_bvalid : in STD_LOGIC_VECTOR ( 0 to 0 );
    M_AXI_rdata : in STD_LOGIC_VECTOR ( 31 downto 0 );
    M_AXI_rready : out STD_LOGIC_VECTOR ( 0 to 0 );
    M_AXI_rresp : in STD_LOGIC_VECTOR ( 1 downto 0 );
    M_AXI_rvalid : in STD_LOGIC_VECTOR ( 0 to 0 );
    M_AXI_wdata : out STD_LOGIC_VECTOR ( 31 downto 0 );
    M_AXI_wready : in STD_LOGIC_VECTOR ( 0 to 0 );
    M_AXI_wvalid : out STD_LOGIC_VECTOR ( 0 to 0 );
    S_ACLK : in STD_LOGIC;
    S_ARESETN : in STD_LOGIC;
    S_AXI_araddr : in STD_LOGIC_VECTOR ( 31 downto 0 );
    S_AXI_arready : out STD_LOGIC_VECTOR ( 0 to 0 );
    S_AXI_arvalid : in STD_LOGIC_VECTOR ( 0 to 0 );
    S_AXI_awaddr : in STD_LOGIC_VECTOR ( 31 downto 0 );
    S_AXI_awready : out STD_LOGIC_VECTOR ( 0 to 0 );
    S_AXI_awvalid : in STD_LOGIC_VECTOR ( 0 to 0 );
    S_AXI_bready : in STD_LOGIC_VECTOR ( 0 to 0 );
    S_AXI_bresp : out STD_LOGIC_VECTOR ( 1 downto 0 );
    S_AXI_bvalid : out STD_LOGIC_VECTOR ( 0 to 0 );
    S_AXI_rdata : out STD_LOGIC_VECTOR ( 31 downto 0 );
    S_AXI_rready : in STD_LOGIC_VECTOR ( 0 to 0 );
    S_AXI_rresp : out STD_LOGIC_VECTOR ( 1 downto 0 );
    S_AXI_rvalid : out STD_LOGIC_VECTOR ( 0 to 0 );
    S_AXI_wdata : in STD_LOGIC_VECTOR ( 31 downto 0 );
    S_AXI_wready : out STD_LOGIC_VECTOR ( 0 to 0 );
    S_AXI_wvalid : in STD_LOGIC_VECTOR ( 0 to 0 )
  );
end m01_couplers_imp_11WP2HX;

architecture STRUCTURE of m01_couplers_imp_11WP2HX is
  signal m01_couplers_to_m01_couplers_ARADDR : STD_LOGIC_VECTOR ( 31 downto 0 );
  signal m01_couplers_to_m01_couplers_ARREADY : STD_LOGIC_VECTOR ( 0 to 0 );
  signal m01_couplers_to_m01_couplers_ARVALID : STD_LOGIC_VECTOR ( 0 to 0 );
  signal m01_couplers_to_m01_couplers_AWADDR : STD_LOGIC_VECTOR ( 31 downto 0 );
  signal m01_couplers_to_m01_couplers_AWREADY : STD_LOGIC_VECTOR ( 0 to 0 );
  signal m01_couplers_to_m01_couplers_AWVALID : STD_LOGIC_VECTOR ( 0 to 0 );
  signal m01_couplers_to_m01_couplers_BREADY : STD_LOGIC_VECTOR ( 0 to 0 );
  signal m01_couplers_to_m01_couplers_BRESP : STD_LOGIC_VECTOR ( 1 downto 0 );
  signal m01_couplers_to_m01_couplers_BVALID : STD_LOGIC_VECTOR ( 0 to 0 );
  signal m01_couplers_to_m01_couplers_RDATA : STD_LOGIC_VECTOR ( 31 downto 0 );
  signal m01_couplers_to_m01_couplers_RREADY : STD_LOGIC_VECTOR ( 0 to 0 );
  signal m01_couplers_to_m01_couplers_RRESP : STD_LOGIC_VECTOR ( 1 downto 0 );
  signal m01_couplers_to_m01_couplers_RVALID : STD_LOGIC_VECTOR ( 0 to 0 );
  signal m01_couplers_to_m01_couplers_WDATA : STD_LOGIC_VECTOR ( 31 downto 0 );
  signal m01_couplers_to_m01_couplers_WREADY : STD_LOGIC_VECTOR ( 0 to 0 );
  signal m01_couplers_to_m01_couplers_WVALID : STD_LOGIC_VECTOR ( 0 to 0 );
begin
  M_AXI_araddr(31 downto 0) <= m01_couplers_to_m01_couplers_ARADDR(31 downto 0);
  M_AXI_arvalid(0) <= m01_couplers_to_m01_couplers_ARVALID(0);
  M_AXI_awaddr(31 downto 0) <= m01_couplers_to_m01_couplers_AWADDR(31 downto 0);
  M_AXI_awvalid(0) <= m01_couplers_to_m01_couplers_AWVALID(0);
  M_AXI_bready(0) <= m01_couplers_to_m01_couplers_BREADY(0);
  M_AXI_rready(0) <= m01_couplers_to_m01_couplers_RREADY(0);
  M_AXI_wdata(31 downto 0) <= m01_couplers_to_m01_couplers_WDATA(31 downto 0);
  M_AXI_wvalid(0) <= m01_couplers_to_m01_couplers_WVALID(0);
  S_AXI_arready(0) <= m01_couplers_to_m01_couplers_ARREADY(0);
  S_AXI_awready(0) <= m01_couplers_to_m01_couplers_AWREADY(0);
  S_AXI_bresp(1 downto 0) <= m01_couplers_to_m01_couplers_BRESP(1 downto 0);
  S_AXI_bvalid(0) <= m01_couplers_to_m01_couplers_BVALID(0);
  S_AXI_rdata(31 downto 0) <= m01_couplers_to_m01_couplers_RDATA(31 downto 0);
  S_AXI_rresp(1 downto 0) <= m01_couplers_to_m01_couplers_RRESP(1 downto 0);
  S_AXI_rvalid(0) <= m01_couplers_to_m01_couplers_RVALID(0);
  S_AXI_wready(0) <= m01_couplers_to_m01_couplers_WREADY(0);
  m01_couplers_to_m01_couplers_ARADDR(31 downto 0) <= S_AXI_araddr(31 downto 0);
  m01_couplers_to_m01_couplers_ARREADY(0) <= M_AXI_arready(0);
  m01_couplers_to_m01_couplers_ARVALID(0) <= S_AXI_arvalid(0);
  m01_couplers_to_m01_couplers_AWADDR(31 downto 0) <= S_AXI_awaddr(31 downto 0);
  m01_couplers_to_m01_couplers_AWREADY(0) <= M_AXI_awready(0);
  m01_couplers_to_m01_couplers_AWVALID(0) <= S_AXI_awvalid(0);
  m01_couplers_to_m01_couplers_BREADY(0) <= S_AXI_bready(0);
  m01_couplers_to_m01_couplers_BRESP(1 downto 0) <= M_AXI_bresp(1 downto 0);
  m01_couplers_to_m01_couplers_BVALID(0) <= M_AXI_bvalid(0);
  m01_couplers_to_m01_couplers_RDATA(31 downto 0) <= M_AXI_rdata(31 downto 0);
  m01_couplers_to_m01_couplers_RREADY(0) <= S_AXI_rready(0);
  m01_couplers_to_m01_couplers_RRESP(1 downto 0) <= M_AXI_rresp(1 downto 0);
  m01_couplers_to_m01_couplers_RVALID(0) <= M_AXI_rvalid(0);
  m01_couplers_to_m01_couplers_WDATA(31 downto 0) <= S_AXI_wdata(31 downto 0);
  m01_couplers_to_m01_couplers_WREADY(0) <= M_AXI_wready(0);
  m01_couplers_to_m01_couplers_WVALID(0) <= S_AXI_wvalid(0);
end STRUCTURE;
library IEEE;
use IEEE.STD_LOGIC_1164.ALL;
library UNISIM;
use UNISIM.VCOMPONENTS.ALL;
entity m02_couplers_imp_C5D3YK is
  port (
    M_ACLK : in STD_LOGIC;
    M_ARESETN : in STD_LOGIC;
    M_AXI_araddr : out STD_LOGIC_VECTOR ( 31 downto 0 );
    M_AXI_arprot : out STD_LOGIC_VECTOR ( 2 downto 0 );
    M_AXI_arready : in STD_LOGIC;
    M_AXI_arvalid : out STD_LOGIC;
    M_AXI_awaddr : out STD_LOGIC_VECTOR ( 31 downto 0 );
    M_AXI_awprot : out STD_LOGIC_VECTOR ( 2 downto 0 );
    M_AXI_awready : in STD_LOGIC;
    M_AXI_awvalid : out STD_LOGIC;
    M_AXI_bready : out STD_LOGIC;
    M_AXI_bresp : in STD_LOGIC_VECTOR ( 1 downto 0 );
    M_AXI_bvalid : in STD_LOGIC;
    M_AXI_rdata : in STD_LOGIC_VECTOR ( 31 downto 0 );
    M_AXI_rready : out STD_LOGIC;
    M_AXI_rresp : in STD_LOGIC_VECTOR ( 1 downto 0 );
    M_AXI_rvalid : in STD_LOGIC;
    M_AXI_wdata : out STD_LOGIC_VECTOR ( 31 downto 0 );
    M_AXI_wready : in STD_LOGIC;
    M_AXI_wstrb : out STD_LOGIC_VECTOR ( 3 downto 0 );
    M_AXI_wvalid : out STD_LOGIC;
    S_ACLK : in STD_LOGIC;
    S_ARESETN : in STD_LOGIC;
    S_AXI_araddr : in STD_LOGIC_VECTOR ( 31 downto 0 );
    S_AXI_arprot : in STD_LOGIC_VECTOR ( 2 downto 0 );
    S_AXI_arready : out STD_LOGIC;
    S_AXI_arvalid : in STD_LOGIC;
    S_AXI_awaddr : in STD_LOGIC_VECTOR ( 31 downto 0 );
    S_AXI_awprot : in STD_LOGIC_VECTOR ( 2 downto 0 );
    S_AXI_awready : out STD_LOGIC;
    S_AXI_awvalid : in STD_LOGIC;
    S_AXI_bready : in STD_LOGIC;
    S_AXI_bresp : out STD_LOGIC_VECTOR ( 1 downto 0 );
    S_AXI_bvalid : out STD_LOGIC;
    S_AXI_rdata : out STD_LOGIC_VECTOR ( 31 downto 0 );
    S_AXI_rready : in STD_LOGIC;
    S_AXI_rresp : out STD_LOGIC_VECTOR ( 1 downto 0 );
    S_AXI_rvalid : out STD_LOGIC;
    S_AXI_wdata : in STD_LOGIC_VECTOR ( 31 downto 0 );
    S_AXI_wready : out STD_LOGIC;
    S_AXI_wstrb : in STD_LOGIC_VECTOR ( 3 downto 0 );
    S_AXI_wvalid : in STD_LOGIC
  );
end m02_couplers_imp_C5D3YK;

architecture STRUCTURE of m02_couplers_imp_C5D3YK is
  signal m02_couplers_to_m02_couplers_ARADDR : STD_LOGIC_VECTOR ( 31 downto 0 );
  signal m02_couplers_to_m02_couplers_ARPROT : STD_LOGIC_VECTOR ( 2 downto 0 );
  signal m02_couplers_to_m02_couplers_ARREADY : STD_LOGIC;
  signal m02_couplers_to_m02_couplers_ARVALID : STD_LOGIC;
  signal m02_couplers_to_m02_couplers_AWADDR : STD_LOGIC_VECTOR ( 31 downto 0 );
  signal m02_couplers_to_m02_couplers_AWPROT : STD_LOGIC_VECTOR ( 2 downto 0 );
  signal m02_couplers_to_m02_couplers_AWREADY : STD_LOGIC;
  signal m02_couplers_to_m02_couplers_AWVALID : STD_LOGIC;
  signal m02_couplers_to_m02_couplers_BREADY : STD_LOGIC;
  signal m02_couplers_to_m02_couplers_BRESP : STD_LOGIC_VECTOR ( 1 downto 0 );
  signal m02_couplers_to_m02_couplers_BVALID : STD_LOGIC;
  signal m02_couplers_to_m02_couplers_RDATA : STD_LOGIC_VECTOR ( 31 downto 0 );
  signal m02_couplers_to_m02_couplers_RREADY : STD_LOGIC;
  signal m02_couplers_to_m02_couplers_RRESP : STD_LOGIC_VECTOR ( 1 downto 0 );
  signal m02_couplers_to_m02_couplers_RVALID : STD_LOGIC;
  signal m02_couplers_to_m02_couplers_WDATA : STD_LOGIC_VECTOR ( 31 downto 0 );
  signal m02_couplers_to_m02_couplers_WREADY : STD_LOGIC;
  signal m02_couplers_to_m02_couplers_WSTRB : STD_LOGIC_VECTOR ( 3 downto 0 );
  signal m02_couplers_to_m02_couplers_WVALID : STD_LOGIC;
begin
  M_AXI_araddr(31 downto 0) <= m02_couplers_to_m02_couplers_ARADDR(31 downto 0);
  M_AXI_arprot(2 downto 0) <= m02_couplers_to_m02_couplers_ARPROT(2 downto 0);
  M_AXI_arvalid <= m02_couplers_to_m02_couplers_ARVALID;
  M_AXI_awaddr(31 downto 0) <= m02_couplers_to_m02_couplers_AWADDR(31 downto 0);
  M_AXI_awprot(2 downto 0) <= m02_couplers_to_m02_couplers_AWPROT(2 downto 0);
  M_AXI_awvalid <= m02_couplers_to_m02_couplers_AWVALID;
  M_AXI_bready <= m02_couplers_to_m02_couplers_BREADY;
  M_AXI_rready <= m02_couplers_to_m02_couplers_RREADY;
  M_AXI_wdata(31 downto 0) <= m02_couplers_to_m02_couplers_WDATA(31 downto 0);
  M_AXI_wstrb(3 downto 0) <= m02_couplers_to_m02_couplers_WSTRB(3 downto 0);
  M_AXI_wvalid <= m02_couplers_to_m02_couplers_WVALID;
  S_AXI_arready <= m02_couplers_to_m02_couplers_ARREADY;
  S_AXI_awready <= m02_couplers_to_m02_couplers_AWREADY;
  S_AXI_bresp(1 downto 0) <= m02_couplers_to_m02_couplers_BRESP(1 downto 0);
  S_AXI_bvalid <= m02_couplers_to_m02_couplers_BVALID;
  S_AXI_rdata(31 downto 0) <= m02_couplers_to_m02_couplers_RDATA(31 downto 0);
  S_AXI_rresp(1 downto 0) <= m02_couplers_to_m02_couplers_RRESP(1 downto 0);
  S_AXI_rvalid <= m02_couplers_to_m02_couplers_RVALID;
  S_AXI_wready <= m02_couplers_to_m02_couplers_WREADY;
  m02_couplers_to_m02_couplers_ARADDR(31 downto 0) <= S_AXI_araddr(31 downto 0);
  m02_couplers_to_m02_couplers_ARPROT(2 downto 0) <= S_AXI_arprot(2 downto 0);
  m02_couplers_to_m02_couplers_ARREADY <= M_AXI_arready;
  m02_couplers_to_m02_couplers_ARVALID <= S_AXI_arvalid;
  m02_couplers_to_m02_couplers_AWADDR(31 downto 0) <= S_AXI_awaddr(31 downto 0);
  m02_couplers_to_m02_couplers_AWPROT(2 downto 0) <= S_AXI_awprot(2 downto 0);
  m02_couplers_to_m02_couplers_AWREADY <= M_AXI_awready;
  m02_couplers_to_m02_couplers_AWVALID <= S_AXI_awvalid;
  m02_couplers_to_m02_couplers_BREADY <= S_AXI_bready;
  m02_couplers_to_m02_couplers_BRESP(1 downto 0) <= M_AXI_bresp(1 downto 0);
  m02_couplers_to_m02_couplers_BVALID <= M_AXI_bvalid;
  m02_couplers_to_m02_couplers_RDATA(31 downto 0) <= M_AXI_rdata(31 downto 0);
  m02_couplers_to_m02_couplers_RREADY <= S_AXI_rready;
  m02_couplers_to_m02_couplers_RRESP(1 downto 0) <= M_AXI_rresp(1 downto 0);
  m02_couplers_to_m02_couplers_RVALID <= M_AXI_rvalid;
  m02_couplers_to_m02_couplers_WDATA(31 downto 0) <= S_AXI_wdata(31 downto 0);
  m02_couplers_to_m02_couplers_WREADY <= M_AXI_wready;
  m02_couplers_to_m02_couplers_WSTRB(3 downto 0) <= S_AXI_wstrb(3 downto 0);
  m02_couplers_to_m02_couplers_WVALID <= S_AXI_wvalid;
end STRUCTURE;
library IEEE;
use IEEE.STD_LOGIC_1164.ALL;
library UNISIM;
use UNISIM.VCOMPONENTS.ALL;
entity m03_couplers_imp_1XYV0GK is
  port (
    M_ACLK : in STD_LOGIC;
    M_ARESETN : in STD_LOGIC;
    M_AXI_araddr : out STD_LOGIC_VECTOR ( 31 downto 0 );
    M_AXI_arprot : out STD_LOGIC_VECTOR ( 2 downto 0 );
    M_AXI_arready : in STD_LOGIC;
    M_AXI_arvalid : out STD_LOGIC;
    M_AXI_awaddr : out STD_LOGIC_VECTOR ( 31 downto 0 );
    M_AXI_awprot : out STD_LOGIC_VECTOR ( 2 downto 0 );
    M_AXI_awready : in STD_LOGIC;
    M_AXI_awvalid : out STD_LOGIC;
    M_AXI_bready : out STD_LOGIC;
    M_AXI_bresp : in STD_LOGIC_VECTOR ( 1 downto 0 );
    M_AXI_bvalid : in STD_LOGIC;
    M_AXI_rdata : in STD_LOGIC_VECTOR ( 31 downto 0 );
    M_AXI_rready : out STD_LOGIC;
    M_AXI_rresp : in STD_LOGIC_VECTOR ( 1 downto 0 );
    M_AXI_rvalid : in STD_LOGIC;
    M_AXI_wdata : out STD_LOGIC_VECTOR ( 31 downto 0 );
    M_AXI_wready : in STD_LOGIC;
    M_AXI_wstrb : out STD_LOGIC_VECTOR ( 3 downto 0 );
    M_AXI_wvalid : out STD_LOGIC;
    S_ACLK : in STD_LOGIC;
    S_ARESETN : in STD_LOGIC;
    S_AXI_araddr : in STD_LOGIC_VECTOR ( 31 downto 0 );
    S_AXI_arprot : in STD_LOGIC_VECTOR ( 2 downto 0 );
    S_AXI_arready : out STD_LOGIC;
    S_AXI_arvalid : in STD_LOGIC;
    S_AXI_awaddr : in STD_LOGIC_VECTOR ( 31 downto 0 );
    S_AXI_awprot : in STD_LOGIC_VECTOR ( 2 downto 0 );
    S_AXI_awready : out STD_LOGIC;
    S_AXI_awvalid : in STD_LOGIC;
    S_AXI_bready : in STD_LOGIC;
    S_AXI_bresp : out STD_LOGIC_VECTOR ( 1 downto 0 );
    S_AXI_bvalid : out STD_LOGIC;
    S_AXI_rdata : out STD_LOGIC_VECTOR ( 31 downto 0 );
    S_AXI_rready : in STD_LOGIC;
    S_AXI_rresp : out STD_LOGIC_VECTOR ( 1 downto 0 );
    S_AXI_rvalid : out STD_LOGIC;
    S_AXI_wdata : in STD_LOGIC_VECTOR ( 31 downto 0 );
    S_AXI_wready : out STD_LOGIC;
    S_AXI_wstrb : in STD_LOGIC_VECTOR ( 3 downto 0 );
    S_AXI_wvalid : in STD_LOGIC
  );
end m03_couplers_imp_1XYV0GK;

architecture STRUCTURE of m03_couplers_imp_1XYV0GK is
  signal m03_couplers_to_m03_couplers_ARADDR : STD_LOGIC_VECTOR ( 31 downto 0 );
  signal m03_couplers_to_m03_couplers_ARPROT : STD_LOGIC_VECTOR ( 2 downto 0 );
  signal m03_couplers_to_m03_couplers_ARREADY : STD_LOGIC;
  signal m03_couplers_to_m03_couplers_ARVALID : STD_LOGIC;
  signal m03_couplers_to_m03_couplers_AWADDR : STD_LOGIC_VECTOR ( 31 downto 0 );
  signal m03_couplers_to_m03_couplers_AWPROT : STD_LOGIC_VECTOR ( 2 downto 0 );
  signal m03_couplers_to_m03_couplers_AWREADY : STD_LOGIC;
  signal m03_couplers_to_m03_couplers_AWVALID : STD_LOGIC;
  signal m03_couplers_to_m03_couplers_BREADY : STD_LOGIC;
  signal m03_couplers_to_m03_couplers_BRESP : STD_LOGIC_VECTOR ( 1 downto 0 );
  signal m03_couplers_to_m03_couplers_BVALID : STD_LOGIC;
  signal m03_couplers_to_m03_couplers_RDATA : STD_LOGIC_VECTOR ( 31 downto 0 );
  signal m03_couplers_to_m03_couplers_RREADY : STD_LOGIC;
  signal m03_couplers_to_m03_couplers_RRESP : STD_LOGIC_VECTOR ( 1 downto 0 );
  signal m03_couplers_to_m03_couplers_RVALID : STD_LOGIC;
  signal m03_couplers_to_m03_couplers_WDATA : STD_LOGIC_VECTOR ( 31 downto 0 );
  signal m03_couplers_to_m03_couplers_WREADY : STD_LOGIC;
  signal m03_couplers_to_m03_couplers_WSTRB : STD_LOGIC_VECTOR ( 3 downto 0 );
  signal m03_couplers_to_m03_couplers_WVALID : STD_LOGIC;
begin
  M_AXI_araddr(31 downto 0) <= m03_couplers_to_m03_couplers_ARADDR(31 downto 0);
  M_AXI_arprot(2 downto 0) <= m03_couplers_to_m03_couplers_ARPROT(2 downto 0);
  M_AXI_arvalid <= m03_couplers_to_m03_couplers_ARVALID;
  M_AXI_awaddr(31 downto 0) <= m03_couplers_to_m03_couplers_AWADDR(31 downto 0);
  M_AXI_awprot(2 downto 0) <= m03_couplers_to_m03_couplers_AWPROT(2 downto 0);
  M_AXI_awvalid <= m03_couplers_to_m03_couplers_AWVALID;
  M_AXI_bready <= m03_couplers_to_m03_couplers_BREADY;
  M_AXI_rready <= m03_couplers_to_m03_couplers_RREADY;
  M_AXI_wdata(31 downto 0) <= m03_couplers_to_m03_couplers_WDATA(31 downto 0);
  M_AXI_wstrb(3 downto 0) <= m03_couplers_to_m03_couplers_WSTRB(3 downto 0);
  M_AXI_wvalid <= m03_couplers_to_m03_couplers_WVALID;
  S_AXI_arready <= m03_couplers_to_m03_couplers_ARREADY;
  S_AXI_awready <= m03_couplers_to_m03_couplers_AWREADY;
  S_AXI_bresp(1 downto 0) <= m03_couplers_to_m03_couplers_BRESP(1 downto 0);
  S_AXI_bvalid <= m03_couplers_to_m03_couplers_BVALID;
  S_AXI_rdata(31 downto 0) <= m03_couplers_to_m03_couplers_RDATA(31 downto 0);
  S_AXI_rresp(1 downto 0) <= m03_couplers_to_m03_couplers_RRESP(1 downto 0);
  S_AXI_rvalid <= m03_couplers_to_m03_couplers_RVALID;
  S_AXI_wready <= m03_couplers_to_m03_couplers_WREADY;
  m03_couplers_to_m03_couplers_ARADDR(31 downto 0) <= S_AXI_araddr(31 downto 0);
  m03_couplers_to_m03_couplers_ARPROT(2 downto 0) <= S_AXI_arprot(2 downto 0);
  m03_couplers_to_m03_couplers_ARREADY <= M_AXI_arready;
  m03_couplers_to_m03_couplers_ARVALID <= S_AXI_arvalid;
  m03_couplers_to_m03_couplers_AWADDR(31 downto 0) <= S_AXI_awaddr(31 downto 0);
  m03_couplers_to_m03_couplers_AWPROT(2 downto 0) <= S_AXI_awprot(2 downto 0);
  m03_couplers_to_m03_couplers_AWREADY <= M_AXI_awready;
  m03_couplers_to_m03_couplers_AWVALID <= S_AXI_awvalid;
  m03_couplers_to_m03_couplers_BREADY <= S_AXI_bready;
  m03_couplers_to_m03_couplers_BRESP(1 downto 0) <= M_AXI_bresp(1 downto 0);
  m03_couplers_to_m03_couplers_BVALID <= M_AXI_bvalid;
  m03_couplers_to_m03_couplers_RDATA(31 downto 0) <= M_AXI_rdata(31 downto 0);
  m03_couplers_to_m03_couplers_RREADY <= S_AXI_rready;
  m03_couplers_to_m03_couplers_RRESP(1 downto 0) <= M_AXI_rresp(1 downto 0);
  m03_couplers_to_m03_couplers_RVALID <= M_AXI_rvalid;
  m03_couplers_to_m03_couplers_WDATA(31 downto 0) <= S_AXI_wdata(31 downto 0);
  m03_couplers_to_m03_couplers_WREADY <= M_AXI_wready;
  m03_couplers_to_m03_couplers_WSTRB(3 downto 0) <= S_AXI_wstrb(3 downto 0);
  m03_couplers_to_m03_couplers_WVALID <= S_AXI_wvalid;
end STRUCTURE;
library IEEE;
use IEEE.STD_LOGIC_1164.ALL;
library UNISIM;
use UNISIM.VCOMPONENTS.ALL;
entity s00_couplers_imp_1B288QA is
  port (
    M_AXIS_ACLK : in STD_LOGIC;
    M_AXIS_ARESETN : in STD_LOGIC;
    M_AXIS_tdata : out STD_LOGIC_VECTOR ( 31 downto 0 );
    M_AXIS_tid : out STD_LOGIC_VECTOR ( 1 downto 0 );
    M_AXIS_tlast : out STD_LOGIC;
    M_AXIS_tready : in STD_LOGIC;
    M_AXIS_tstrb : out STD_LOGIC_VECTOR ( 3 downto 0 );
    M_AXIS_tvalid : out STD_LOGIC;
    S_AXIS_ACLK : in STD_LOGIC;
    S_AXIS_ARESETN : in STD_LOGIC;
    S_AXIS_tdata : in STD_LOGIC_VECTOR ( 31 downto 0 );
    S_AXIS_tid : in STD_LOGIC_VECTOR ( 1 downto 0 );
    S_AXIS_tlast : in STD_LOGIC;
    S_AXIS_tready : out STD_LOGIC;
    S_AXIS_tstrb : in STD_LOGIC_VECTOR ( 3 downto 0 );
    S_AXIS_tvalid : in STD_LOGIC
  );
end s00_couplers_imp_1B288QA;

architecture STRUCTURE of s00_couplers_imp_1B288QA is
  component base_zynq_s00_data_fifo_0 is
  port (
    s_axis_aresetn : in STD_LOGIC;
    s_axis_aclk : in STD_LOGIC;
    s_axis_tvalid : in STD_LOGIC;
    s_axis_tready : out STD_LOGIC;
    s_axis_tdata : in STD_LOGIC_VECTOR ( 31 downto 0 );
    s_axis_tstrb : in STD_LOGIC_VECTOR ( 3 downto 0 );
    s_axis_tlast : in STD_LOGIC;
    s_axis_tid : in STD_LOGIC_VECTOR ( 1 downto 0 );
    m_axis_tvalid : out STD_LOGIC;
    m_axis_tready : in STD_LOGIC;
    m_axis_tdata : out STD_LOGIC_VECTOR ( 31 downto 0 );
    m_axis_tstrb : out STD_LOGIC_VECTOR ( 3 downto 0 );
    m_axis_tlast : out STD_LOGIC;
    m_axis_tid : out STD_LOGIC_VECTOR ( 1 downto 0 );
    axis_wr_data_count : out STD_LOGIC_VECTOR ( 31 downto 0 );
    axis_rd_data_count : out STD_LOGIC_VECTOR ( 31 downto 0 )
  );
  end component base_zynq_s00_data_fifo_0;
  signal AXIS_RD_DATA_COUNT_to_S_AXIS_RD_DATA_COUNT : STD_LOGIC_VECTOR ( 31 downto 0 );
  signal AXIS_WR_DATA_COUNT_to_S_AXIS_WR_DATA_COUNT : STD_LOGIC_VECTOR ( 31 downto 0 );
  signal s00_couplers_to_s00_data_fifo_TDATA : STD_LOGIC_VECTOR ( 31 downto 0 );
  signal s00_couplers_to_s00_data_fifo_TID : STD_LOGIC_VECTOR ( 1 downto 0 );
  signal s00_couplers_to_s00_data_fifo_TLAST : STD_LOGIC;
  signal s00_couplers_to_s00_data_fifo_TREADY : STD_LOGIC;
  signal s00_couplers_to_s00_data_fifo_TSTRB : STD_LOGIC_VECTOR ( 3 downto 0 );
  signal s00_couplers_to_s00_data_fifo_TVALID : STD_LOGIC;
  signal s00_data_fifo_to_s00_couplers_TDATA : STD_LOGIC_VECTOR ( 31 downto 0 );
  signal s00_data_fifo_to_s00_couplers_TID : STD_LOGIC_VECTOR ( 1 downto 0 );
  signal s00_data_fifo_to_s00_couplers_TLAST : STD_LOGIC;
  signal s00_data_fifo_to_s00_couplers_TREADY : STD_LOGIC;
  signal s00_data_fifo_to_s00_couplers_TSTRB : STD_LOGIC_VECTOR ( 3 downto 0 );
  signal s00_data_fifo_to_s00_couplers_TVALID : STD_LOGIC;
begin
  M_AXIS_tdata(31 downto 0) <= s00_data_fifo_to_s00_couplers_TDATA(31 downto 0);
  M_AXIS_tid(1 downto 0) <= s00_data_fifo_to_s00_couplers_TID(1 downto 0);
  M_AXIS_tlast <= s00_data_fifo_to_s00_couplers_TLAST;
  M_AXIS_tstrb(3 downto 0) <= s00_data_fifo_to_s00_couplers_TSTRB(3 downto 0);
  M_AXIS_tvalid <= s00_data_fifo_to_s00_couplers_TVALID;
  S_AXIS_tready <= s00_couplers_to_s00_data_fifo_TREADY;
  s00_couplers_to_s00_data_fifo_TDATA(31 downto 0) <= S_AXIS_tdata(31 downto 0);
  s00_couplers_to_s00_data_fifo_TID(1 downto 0) <= S_AXIS_tid(1 downto 0);
  s00_couplers_to_s00_data_fifo_TLAST <= S_AXIS_tlast;
  s00_couplers_to_s00_data_fifo_TSTRB(3 downto 0) <= S_AXIS_tstrb(3 downto 0);
  s00_couplers_to_s00_data_fifo_TVALID <= S_AXIS_tvalid;
  s00_data_fifo_to_s00_couplers_TREADY <= M_AXIS_tready;
s00_data_fifo: component base_zynq_s00_data_fifo_0
     port map (
      axis_rd_data_count(31 downto 0) => AXIS_RD_DATA_COUNT_to_S_AXIS_RD_DATA_COUNT(31 downto 0),
      axis_wr_data_count(31 downto 0) => AXIS_WR_DATA_COUNT_to_S_AXIS_WR_DATA_COUNT(31 downto 0),
      m_axis_tdata(31 downto 0) => s00_data_fifo_to_s00_couplers_TDATA(31 downto 0),
      m_axis_tid(1 downto 0) => s00_data_fifo_to_s00_couplers_TID(1 downto 0),
      m_axis_tlast => s00_data_fifo_to_s00_couplers_TLAST,
      m_axis_tready => s00_data_fifo_to_s00_couplers_TREADY,
      m_axis_tstrb(3 downto 0) => s00_data_fifo_to_s00_couplers_TSTRB(3 downto 0),
      m_axis_tvalid => s00_data_fifo_to_s00_couplers_TVALID,
      s_axis_aclk => M_AXIS_ACLK,
      s_axis_aresetn => M_AXIS_ARESETN,
      s_axis_tdata(31 downto 0) => s00_couplers_to_s00_data_fifo_TDATA(31 downto 0),
      s_axis_tid(1 downto 0) => s00_couplers_to_s00_data_fifo_TID(1 downto 0),
      s_axis_tlast => s00_couplers_to_s00_data_fifo_TLAST,
      s_axis_tready => s00_couplers_to_s00_data_fifo_TREADY,
      s_axis_tstrb(3 downto 0) => s00_couplers_to_s00_data_fifo_TSTRB(3 downto 0),
      s_axis_tvalid => s00_couplers_to_s00_data_fifo_TVALID
    );
end STRUCTURE;
library IEEE;
use IEEE.STD_LOGIC_1164.ALL;
library UNISIM;
use UNISIM.VCOMPONENTS.ALL;
entity s00_couplers_imp_1IAW1WV is
  port (
    M_ACLK : in STD_LOGIC;
    M_ARESETN : in STD_LOGIC;
    M_AXI_awaddr : out STD_LOGIC_VECTOR ( 31 downto 0 );
    M_AXI_awburst : out STD_LOGIC_VECTOR ( 1 downto 0 );
    M_AXI_awcache : out STD_LOGIC_VECTOR ( 3 downto 0 );
    M_AXI_awlen : out STD_LOGIC_VECTOR ( 3 downto 0 );
    M_AXI_awlock : out STD_LOGIC_VECTOR ( 1 downto 0 );
    M_AXI_awprot : out STD_LOGIC_VECTOR ( 2 downto 0 );
    M_AXI_awqos : out STD_LOGIC_VECTOR ( 3 downto 0 );
    M_AXI_awready : in STD_LOGIC;
    M_AXI_awsize : out STD_LOGIC_VECTOR ( 2 downto 0 );
    M_AXI_awvalid : out STD_LOGIC;
    M_AXI_bready : out STD_LOGIC;
    M_AXI_bresp : in STD_LOGIC_VECTOR ( 1 downto 0 );
    M_AXI_bvalid : in STD_LOGIC;
    M_AXI_wdata : out STD_LOGIC_VECTOR ( 31 downto 0 );
    M_AXI_wlast : out STD_LOGIC;
    M_AXI_wready : in STD_LOGIC;
    M_AXI_wstrb : out STD_LOGIC_VECTOR ( 3 downto 0 );
    M_AXI_wvalid : out STD_LOGIC;
    S_ACLK : in STD_LOGIC;
    S_ARESETN : in STD_LOGIC;
    S_AXI_awaddr : in STD_LOGIC_VECTOR ( 31 downto 0 );
    S_AXI_awburst : in STD_LOGIC_VECTOR ( 1 downto 0 );
    S_AXI_awcache : in STD_LOGIC_VECTOR ( 3 downto 0 );
    S_AXI_awlen : in STD_LOGIC_VECTOR ( 7 downto 0 );
    S_AXI_awprot : in STD_LOGIC_VECTOR ( 2 downto 0 );
    S_AXI_awready : out STD_LOGIC;
    S_AXI_awsize : in STD_LOGIC_VECTOR ( 2 downto 0 );
    S_AXI_awvalid : in STD_LOGIC;
    S_AXI_bready : in STD_LOGIC;
    S_AXI_bresp : out STD_LOGIC_VECTOR ( 1 downto 0 );
    S_AXI_bvalid : out STD_LOGIC;
    S_AXI_wdata : in STD_LOGIC_VECTOR ( 31 downto 0 );
    S_AXI_wlast : in STD_LOGIC;
    S_AXI_wready : out STD_LOGIC;
    S_AXI_wstrb : in STD_LOGIC_VECTOR ( 3 downto 0 );
    S_AXI_wvalid : in STD_LOGIC
  );
end s00_couplers_imp_1IAW1WV;

architecture STRUCTURE of s00_couplers_imp_1IAW1WV is
  component base_zynq_auto_pc_0 is
  port (
    aclk : in STD_LOGIC;
    aresetn : in STD_LOGIC;
    s_axi_awaddr : in STD_LOGIC_VECTOR ( 31 downto 0 );
    s_axi_awlen : in STD_LOGIC_VECTOR ( 7 downto 0 );
    s_axi_awsize : in STD_LOGIC_VECTOR ( 2 downto 0 );
    s_axi_awburst : in STD_LOGIC_VECTOR ( 1 downto 0 );
    s_axi_awlock : in STD_LOGIC_VECTOR ( 0 to 0 );
    s_axi_awcache : in STD_LOGIC_VECTOR ( 3 downto 0 );
    s_axi_awprot : in STD_LOGIC_VECTOR ( 2 downto 0 );
    s_axi_awregion : in STD_LOGIC_VECTOR ( 3 downto 0 );
    s_axi_awqos : in STD_LOGIC_VECTOR ( 3 downto 0 );
    s_axi_awvalid : in STD_LOGIC;
    s_axi_awready : out STD_LOGIC;
    s_axi_wdata : in STD_LOGIC_VECTOR ( 31 downto 0 );
    s_axi_wstrb : in STD_LOGIC_VECTOR ( 3 downto 0 );
    s_axi_wlast : in STD_LOGIC;
    s_axi_wvalid : in STD_LOGIC;
    s_axi_wready : out STD_LOGIC;
    s_axi_bresp : out STD_LOGIC_VECTOR ( 1 downto 0 );
    s_axi_bvalid : out STD_LOGIC;
    s_axi_bready : in STD_LOGIC;
    m_axi_awaddr : out STD_LOGIC_VECTOR ( 31 downto 0 );
    m_axi_awlen : out STD_LOGIC_VECTOR ( 3 downto 0 );
    m_axi_awsize : out STD_LOGIC_VECTOR ( 2 downto 0 );
    m_axi_awburst : out STD_LOGIC_VECTOR ( 1 downto 0 );
    m_axi_awlock : out STD_LOGIC_VECTOR ( 1 downto 0 );
    m_axi_awcache : out STD_LOGIC_VECTOR ( 3 downto 0 );
    m_axi_awprot : out STD_LOGIC_VECTOR ( 2 downto 0 );
    m_axi_awqos : out STD_LOGIC_VECTOR ( 3 downto 0 );
    m_axi_awvalid : out STD_LOGIC;
    m_axi_awready : in STD_LOGIC;
    m_axi_wdata : out STD_LOGIC_VECTOR ( 31 downto 0 );
    m_axi_wstrb : out STD_LOGIC_VECTOR ( 3 downto 0 );
    m_axi_wlast : out STD_LOGIC;
    m_axi_wvalid : out STD_LOGIC;
    m_axi_wready : in STD_LOGIC;
    m_axi_bresp : in STD_LOGIC_VECTOR ( 1 downto 0 );
    m_axi_bvalid : in STD_LOGIC;
    m_axi_bready : out STD_LOGIC
  );
  end component base_zynq_auto_pc_0;
  signal S_ACLK_1 : STD_LOGIC;
  signal S_ARESETN_1 : STD_LOGIC;
  signal auto_pc_to_s00_couplers_AWADDR : STD_LOGIC_VECTOR ( 31 downto 0 );
  signal auto_pc_to_s00_couplers_AWBURST : STD_LOGIC_VECTOR ( 1 downto 0 );
  signal auto_pc_to_s00_couplers_AWCACHE : STD_LOGIC_VECTOR ( 3 downto 0 );
  signal auto_pc_to_s00_couplers_AWLEN : STD_LOGIC_VECTOR ( 3 downto 0 );
  signal auto_pc_to_s00_couplers_AWLOCK : STD_LOGIC_VECTOR ( 1 downto 0 );
  signal auto_pc_to_s00_couplers_AWPROT : STD_LOGIC_VECTOR ( 2 downto 0 );
  signal auto_pc_to_s00_couplers_AWQOS : STD_LOGIC_VECTOR ( 3 downto 0 );
  signal auto_pc_to_s00_couplers_AWREADY : STD_LOGIC;
  signal auto_pc_to_s00_couplers_AWSIZE : STD_LOGIC_VECTOR ( 2 downto 0 );
  signal auto_pc_to_s00_couplers_AWVALID : STD_LOGIC;
  signal auto_pc_to_s00_couplers_BREADY : STD_LOGIC;
  signal auto_pc_to_s00_couplers_BRESP : STD_LOGIC_VECTOR ( 1 downto 0 );
  signal auto_pc_to_s00_couplers_BVALID : STD_LOGIC;
  signal auto_pc_to_s00_couplers_WDATA : STD_LOGIC_VECTOR ( 31 downto 0 );
  signal auto_pc_to_s00_couplers_WLAST : STD_LOGIC;
  signal auto_pc_to_s00_couplers_WREADY : STD_LOGIC;
  signal auto_pc_to_s00_couplers_WSTRB : STD_LOGIC_VECTOR ( 3 downto 0 );
  signal auto_pc_to_s00_couplers_WVALID : STD_LOGIC;
  signal s00_couplers_to_auto_pc_AWADDR : STD_LOGIC_VECTOR ( 31 downto 0 );
  signal s00_couplers_to_auto_pc_AWBURST : STD_LOGIC_VECTOR ( 1 downto 0 );
  signal s00_couplers_to_auto_pc_AWCACHE : STD_LOGIC_VECTOR ( 3 downto 0 );
  signal s00_couplers_to_auto_pc_AWLEN : STD_LOGIC_VECTOR ( 7 downto 0 );
  signal s00_couplers_to_auto_pc_AWPROT : STD_LOGIC_VECTOR ( 2 downto 0 );
  signal s00_couplers_to_auto_pc_AWREADY : STD_LOGIC;
  signal s00_couplers_to_auto_pc_AWSIZE : STD_LOGIC_VECTOR ( 2 downto 0 );
  signal s00_couplers_to_auto_pc_AWVALID : STD_LOGIC;
  signal s00_couplers_to_auto_pc_BREADY : STD_LOGIC;
  signal s00_couplers_to_auto_pc_BRESP : STD_LOGIC_VECTOR ( 1 downto 0 );
  signal s00_couplers_to_auto_pc_BVALID : STD_LOGIC;
  signal s00_couplers_to_auto_pc_WDATA : STD_LOGIC_VECTOR ( 31 downto 0 );
  signal s00_couplers_to_auto_pc_WLAST : STD_LOGIC;
  signal s00_couplers_to_auto_pc_WREADY : STD_LOGIC;
  signal s00_couplers_to_auto_pc_WSTRB : STD_LOGIC_VECTOR ( 3 downto 0 );
  signal s00_couplers_to_auto_pc_WVALID : STD_LOGIC;
begin
  M_AXI_awaddr(31 downto 0) <= auto_pc_to_s00_couplers_AWADDR(31 downto 0);
  M_AXI_awburst(1 downto 0) <= auto_pc_to_s00_couplers_AWBURST(1 downto 0);
  M_AXI_awcache(3 downto 0) <= auto_pc_to_s00_couplers_AWCACHE(3 downto 0);
  M_AXI_awlen(3 downto 0) <= auto_pc_to_s00_couplers_AWLEN(3 downto 0);
  M_AXI_awlock(1 downto 0) <= auto_pc_to_s00_couplers_AWLOCK(1 downto 0);
  M_AXI_awprot(2 downto 0) <= auto_pc_to_s00_couplers_AWPROT(2 downto 0);
  M_AXI_awqos(3 downto 0) <= auto_pc_to_s00_couplers_AWQOS(3 downto 0);
  M_AXI_awsize(2 downto 0) <= auto_pc_to_s00_couplers_AWSIZE(2 downto 0);
  M_AXI_awvalid <= auto_pc_to_s00_couplers_AWVALID;
  M_AXI_bready <= auto_pc_to_s00_couplers_BREADY;
  M_AXI_wdata(31 downto 0) <= auto_pc_to_s00_couplers_WDATA(31 downto 0);
  M_AXI_wlast <= auto_pc_to_s00_couplers_WLAST;
  M_AXI_wstrb(3 downto 0) <= auto_pc_to_s00_couplers_WSTRB(3 downto 0);
  M_AXI_wvalid <= auto_pc_to_s00_couplers_WVALID;
  S_ACLK_1 <= S_ACLK;
  S_ARESETN_1 <= S_ARESETN;
  S_AXI_awready <= s00_couplers_to_auto_pc_AWREADY;
  S_AXI_bresp(1 downto 0) <= s00_couplers_to_auto_pc_BRESP(1 downto 0);
  S_AXI_bvalid <= s00_couplers_to_auto_pc_BVALID;
  S_AXI_wready <= s00_couplers_to_auto_pc_WREADY;
  auto_pc_to_s00_couplers_AWREADY <= M_AXI_awready;
  auto_pc_to_s00_couplers_BRESP(1 downto 0) <= M_AXI_bresp(1 downto 0);
  auto_pc_to_s00_couplers_BVALID <= M_AXI_bvalid;
  auto_pc_to_s00_couplers_WREADY <= M_AXI_wready;
  s00_couplers_to_auto_pc_AWADDR(31 downto 0) <= S_AXI_awaddr(31 downto 0);
  s00_couplers_to_auto_pc_AWBURST(1 downto 0) <= S_AXI_awburst(1 downto 0);
  s00_couplers_to_auto_pc_AWCACHE(3 downto 0) <= S_AXI_awcache(3 downto 0);
  s00_couplers_to_auto_pc_AWLEN(7 downto 0) <= S_AXI_awlen(7 downto 0);
  s00_couplers_to_auto_pc_AWPROT(2 downto 0) <= S_AXI_awprot(2 downto 0);
  s00_couplers_to_auto_pc_AWSIZE(2 downto 0) <= S_AXI_awsize(2 downto 0);
  s00_couplers_to_auto_pc_AWVALID <= S_AXI_awvalid;
  s00_couplers_to_auto_pc_BREADY <= S_AXI_bready;
  s00_couplers_to_auto_pc_WDATA(31 downto 0) <= S_AXI_wdata(31 downto 0);
  s00_couplers_to_auto_pc_WLAST <= S_AXI_wlast;
  s00_couplers_to_auto_pc_WSTRB(3 downto 0) <= S_AXI_wstrb(3 downto 0);
  s00_couplers_to_auto_pc_WVALID <= S_AXI_wvalid;
auto_pc: component base_zynq_auto_pc_0
     port map (
      aclk => S_ACLK_1,
      aresetn => S_ARESETN_1,
      m_axi_awaddr(31 downto 0) => auto_pc_to_s00_couplers_AWADDR(31 downto 0),
      m_axi_awburst(1 downto 0) => auto_pc_to_s00_couplers_AWBURST(1 downto 0),
      m_axi_awcache(3 downto 0) => auto_pc_to_s00_couplers_AWCACHE(3 downto 0),
      m_axi_awlen(3 downto 0) => auto_pc_to_s00_couplers_AWLEN(3 downto 0),
      m_axi_awlock(1 downto 0) => auto_pc_to_s00_couplers_AWLOCK(1 downto 0),
      m_axi_awprot(2 downto 0) => auto_pc_to_s00_couplers_AWPROT(2 downto 0),
      m_axi_awqos(3 downto 0) => auto_pc_to_s00_couplers_AWQOS(3 downto 0),
      m_axi_awready => auto_pc_to_s00_couplers_AWREADY,
      m_axi_awsize(2 downto 0) => auto_pc_to_s00_couplers_AWSIZE(2 downto 0),
      m_axi_awvalid => auto_pc_to_s00_couplers_AWVALID,
      m_axi_bready => auto_pc_to_s00_couplers_BREADY,
      m_axi_bresp(1 downto 0) => auto_pc_to_s00_couplers_BRESP(1 downto 0),
      m_axi_bvalid => auto_pc_to_s00_couplers_BVALID,
      m_axi_wdata(31 downto 0) => auto_pc_to_s00_couplers_WDATA(31 downto 0),
      m_axi_wlast => auto_pc_to_s00_couplers_WLAST,
      m_axi_wready => auto_pc_to_s00_couplers_WREADY,
      m_axi_wstrb(3 downto 0) => auto_pc_to_s00_couplers_WSTRB(3 downto 0),
      m_axi_wvalid => auto_pc_to_s00_couplers_WVALID,
      s_axi_awaddr(31 downto 0) => s00_couplers_to_auto_pc_AWADDR(31 downto 0),
      s_axi_awburst(1 downto 0) => s00_couplers_to_auto_pc_AWBURST(1 downto 0),
      s_axi_awcache(3 downto 0) => s00_couplers_to_auto_pc_AWCACHE(3 downto 0),
      s_axi_awlen(7 downto 0) => s00_couplers_to_auto_pc_AWLEN(7 downto 0),
      s_axi_awlock(0) => '0',
      s_axi_awprot(2 downto 0) => s00_couplers_to_auto_pc_AWPROT(2 downto 0),
      s_axi_awqos(3 downto 0) => B"0000",
      s_axi_awready => s00_couplers_to_auto_pc_AWREADY,
      s_axi_awregion(3 downto 0) => B"0000",
      s_axi_awsize(2 downto 0) => s00_couplers_to_auto_pc_AWSIZE(2 downto 0),
      s_axi_awvalid => s00_couplers_to_auto_pc_AWVALID,
      s_axi_bready => s00_couplers_to_auto_pc_BREADY,
      s_axi_bresp(1 downto 0) => s00_couplers_to_auto_pc_BRESP(1 downto 0),
      s_axi_bvalid => s00_couplers_to_auto_pc_BVALID,
      s_axi_wdata(31 downto 0) => s00_couplers_to_auto_pc_WDATA(31 downto 0),
      s_axi_wlast => s00_couplers_to_auto_pc_WLAST,
      s_axi_wready => s00_couplers_to_auto_pc_WREADY,
      s_axi_wstrb(3 downto 0) => s00_couplers_to_auto_pc_WSTRB(3 downto 0),
      s_axi_wvalid => s00_couplers_to_auto_pc_WVALID
    );
end STRUCTURE;
library IEEE;
use IEEE.STD_LOGIC_1164.ALL;
library UNISIM;
use UNISIM.VCOMPONENTS.ALL;
entity s00_couplers_imp_1JB4A1T is
  port (
    M_ACLK : in STD_LOGIC;
    M_ARESETN : in STD_LOGIC;
    M_AXI_araddr : out STD_LOGIC_VECTOR ( 31 downto 0 );
    M_AXI_arprot : out STD_LOGIC_VECTOR ( 2 downto 0 );
    M_AXI_arready : in STD_LOGIC;
    M_AXI_arvalid : out STD_LOGIC;
    M_AXI_awaddr : out STD_LOGIC_VECTOR ( 31 downto 0 );
    M_AXI_awprot : out STD_LOGIC_VECTOR ( 2 downto 0 );
    M_AXI_awready : in STD_LOGIC;
    M_AXI_awvalid : out STD_LOGIC;
    M_AXI_bready : out STD_LOGIC;
    M_AXI_bresp : in STD_LOGIC_VECTOR ( 1 downto 0 );
    M_AXI_bvalid : in STD_LOGIC;
    M_AXI_rdata : in STD_LOGIC_VECTOR ( 31 downto 0 );
    M_AXI_rready : out STD_LOGIC;
    M_AXI_rresp : in STD_LOGIC_VECTOR ( 1 downto 0 );
    M_AXI_rvalid : in STD_LOGIC;
    M_AXI_wdata : out STD_LOGIC_VECTOR ( 31 downto 0 );
    M_AXI_wready : in STD_LOGIC;
    M_AXI_wstrb : out STD_LOGIC_VECTOR ( 3 downto 0 );
    M_AXI_wvalid : out STD_LOGIC;
    S_ACLK : in STD_LOGIC;
    S_ARESETN : in STD_LOGIC;
    S_AXI_araddr : in STD_LOGIC_VECTOR ( 31 downto 0 );
    S_AXI_arburst : in STD_LOGIC_VECTOR ( 1 downto 0 );
    S_AXI_arcache : in STD_LOGIC_VECTOR ( 3 downto 0 );
    S_AXI_arid : in STD_LOGIC_VECTOR ( 11 downto 0 );
    S_AXI_arlen : in STD_LOGIC_VECTOR ( 3 downto 0 );
    S_AXI_arlock : in STD_LOGIC_VECTOR ( 1 downto 0 );
    S_AXI_arprot : in STD_LOGIC_VECTOR ( 2 downto 0 );
    S_AXI_arqos : in STD_LOGIC_VECTOR ( 3 downto 0 );
    S_AXI_arready : out STD_LOGIC;
    S_AXI_arsize : in STD_LOGIC_VECTOR ( 2 downto 0 );
    S_AXI_arvalid : in STD_LOGIC;
    S_AXI_awaddr : in STD_LOGIC_VECTOR ( 31 downto 0 );
    S_AXI_awburst : in STD_LOGIC_VECTOR ( 1 downto 0 );
    S_AXI_awcache : in STD_LOGIC_VECTOR ( 3 downto 0 );
    S_AXI_awid : in STD_LOGIC_VECTOR ( 11 downto 0 );
    S_AXI_awlen : in STD_LOGIC_VECTOR ( 3 downto 0 );
    S_AXI_awlock : in STD_LOGIC_VECTOR ( 1 downto 0 );
    S_AXI_awprot : in STD_LOGIC_VECTOR ( 2 downto 0 );
    S_AXI_awqos : in STD_LOGIC_VECTOR ( 3 downto 0 );
    S_AXI_awready : out STD_LOGIC;
    S_AXI_awsize : in STD_LOGIC_VECTOR ( 2 downto 0 );
    S_AXI_awvalid : in STD_LOGIC;
    S_AXI_bid : out STD_LOGIC_VECTOR ( 11 downto 0 );
    S_AXI_bready : in STD_LOGIC;
    S_AXI_bresp : out STD_LOGIC_VECTOR ( 1 downto 0 );
    S_AXI_bvalid : out STD_LOGIC;
    S_AXI_rdata : out STD_LOGIC_VECTOR ( 31 downto 0 );
    S_AXI_rid : out STD_LOGIC_VECTOR ( 11 downto 0 );
    S_AXI_rlast : out STD_LOGIC;
    S_AXI_rready : in STD_LOGIC;
    S_AXI_rresp : out STD_LOGIC_VECTOR ( 1 downto 0 );
    S_AXI_rvalid : out STD_LOGIC;
    S_AXI_wdata : in STD_LOGIC_VECTOR ( 31 downto 0 );
    S_AXI_wid : in STD_LOGIC_VECTOR ( 11 downto 0 );
    S_AXI_wlast : in STD_LOGIC;
    S_AXI_wready : out STD_LOGIC;
    S_AXI_wstrb : in STD_LOGIC_VECTOR ( 3 downto 0 );
    S_AXI_wvalid : in STD_LOGIC
  );
end s00_couplers_imp_1JB4A1T;

architecture STRUCTURE of s00_couplers_imp_1JB4A1T is
  component base_zynq_auto_pc_1 is
  port (
    aclk : in STD_LOGIC;
    aresetn : in STD_LOGIC;
    s_axi_awid : in STD_LOGIC_VECTOR ( 11 downto 0 );
    s_axi_awaddr : in STD_LOGIC_VECTOR ( 31 downto 0 );
    s_axi_awlen : in STD_LOGIC_VECTOR ( 3 downto 0 );
    s_axi_awsize : in STD_LOGIC_VECTOR ( 2 downto 0 );
    s_axi_awburst : in STD_LOGIC_VECTOR ( 1 downto 0 );
    s_axi_awlock : in STD_LOGIC_VECTOR ( 1 downto 0 );
    s_axi_awcache : in STD_LOGIC_VECTOR ( 3 downto 0 );
    s_axi_awprot : in STD_LOGIC_VECTOR ( 2 downto 0 );
    s_axi_awqos : in STD_LOGIC_VECTOR ( 3 downto 0 );
    s_axi_awvalid : in STD_LOGIC;
    s_axi_awready : out STD_LOGIC;
    s_axi_wid : in STD_LOGIC_VECTOR ( 11 downto 0 );
    s_axi_wdata : in STD_LOGIC_VECTOR ( 31 downto 0 );
    s_axi_wstrb : in STD_LOGIC_VECTOR ( 3 downto 0 );
    s_axi_wlast : in STD_LOGIC;
    s_axi_wvalid : in STD_LOGIC;
    s_axi_wready : out STD_LOGIC;
    s_axi_bid : out STD_LOGIC_VECTOR ( 11 downto 0 );
    s_axi_bresp : out STD_LOGIC_VECTOR ( 1 downto 0 );
    s_axi_bvalid : out STD_LOGIC;
    s_axi_bready : in STD_LOGIC;
    s_axi_arid : in STD_LOGIC_VECTOR ( 11 downto 0 );
    s_axi_araddr : in STD_LOGIC_VECTOR ( 31 downto 0 );
    s_axi_arlen : in STD_LOGIC_VECTOR ( 3 downto 0 );
    s_axi_arsize : in STD_LOGIC_VECTOR ( 2 downto 0 );
    s_axi_arburst : in STD_LOGIC_VECTOR ( 1 downto 0 );
    s_axi_arlock : in STD_LOGIC_VECTOR ( 1 downto 0 );
    s_axi_arcache : in STD_LOGIC_VECTOR ( 3 downto 0 );
    s_axi_arprot : in STD_LOGIC_VECTOR ( 2 downto 0 );
    s_axi_arqos : in STD_LOGIC_VECTOR ( 3 downto 0 );
    s_axi_arvalid : in STD_LOGIC;
    s_axi_arready : out STD_LOGIC;
    s_axi_rid : out STD_LOGIC_VECTOR ( 11 downto 0 );
    s_axi_rdata : out STD_LOGIC_VECTOR ( 31 downto 0 );
    s_axi_rresp : out STD_LOGIC_VECTOR ( 1 downto 0 );
    s_axi_rlast : out STD_LOGIC;
    s_axi_rvalid : out STD_LOGIC;
    s_axi_rready : in STD_LOGIC;
    m_axi_awaddr : out STD_LOGIC_VECTOR ( 31 downto 0 );
    m_axi_awprot : out STD_LOGIC_VECTOR ( 2 downto 0 );
    m_axi_awvalid : out STD_LOGIC;
    m_axi_awready : in STD_LOGIC;
    m_axi_wdata : out STD_LOGIC_VECTOR ( 31 downto 0 );
    m_axi_wstrb : out STD_LOGIC_VECTOR ( 3 downto 0 );
    m_axi_wvalid : out STD_LOGIC;
    m_axi_wready : in STD_LOGIC;
    m_axi_bresp : in STD_LOGIC_VECTOR ( 1 downto 0 );
    m_axi_bvalid : in STD_LOGIC;
    m_axi_bready : out STD_LOGIC;
    m_axi_araddr : out STD_LOGIC_VECTOR ( 31 downto 0 );
    m_axi_arprot : out STD_LOGIC_VECTOR ( 2 downto 0 );
    m_axi_arvalid : out STD_LOGIC;
    m_axi_arready : in STD_LOGIC;
    m_axi_rdata : in STD_LOGIC_VECTOR ( 31 downto 0 );
    m_axi_rresp : in STD_LOGIC_VECTOR ( 1 downto 0 );
    m_axi_rvalid : in STD_LOGIC;
    m_axi_rready : out STD_LOGIC
  );
  end component base_zynq_auto_pc_1;
  signal S_ACLK_1 : STD_LOGIC;
  signal S_ARESETN_1 : STD_LOGIC;
  signal auto_pc_to_s00_couplers_ARADDR : STD_LOGIC_VECTOR ( 31 downto 0 );
  signal auto_pc_to_s00_couplers_ARPROT : STD_LOGIC_VECTOR ( 2 downto 0 );
  signal auto_pc_to_s00_couplers_ARREADY : STD_LOGIC;
  signal auto_pc_to_s00_couplers_ARVALID : STD_LOGIC;
  signal auto_pc_to_s00_couplers_AWADDR : STD_LOGIC_VECTOR ( 31 downto 0 );
  signal auto_pc_to_s00_couplers_AWPROT : STD_LOGIC_VECTOR ( 2 downto 0 );
  signal auto_pc_to_s00_couplers_AWREADY : STD_LOGIC;
  signal auto_pc_to_s00_couplers_AWVALID : STD_LOGIC;
  signal auto_pc_to_s00_couplers_BREADY : STD_LOGIC;
  signal auto_pc_to_s00_couplers_BRESP : STD_LOGIC_VECTOR ( 1 downto 0 );
  signal auto_pc_to_s00_couplers_BVALID : STD_LOGIC;
  signal auto_pc_to_s00_couplers_RDATA : STD_LOGIC_VECTOR ( 31 downto 0 );
  signal auto_pc_to_s00_couplers_RREADY : STD_LOGIC;
  signal auto_pc_to_s00_couplers_RRESP : STD_LOGIC_VECTOR ( 1 downto 0 );
  signal auto_pc_to_s00_couplers_RVALID : STD_LOGIC;
  signal auto_pc_to_s00_couplers_WDATA : STD_LOGIC_VECTOR ( 31 downto 0 );
  signal auto_pc_to_s00_couplers_WREADY : STD_LOGIC;
  signal auto_pc_to_s00_couplers_WSTRB : STD_LOGIC_VECTOR ( 3 downto 0 );
  signal auto_pc_to_s00_couplers_WVALID : STD_LOGIC;
  signal s00_couplers_to_auto_pc_ARADDR : STD_LOGIC_VECTOR ( 31 downto 0 );
  signal s00_couplers_to_auto_pc_ARBURST : STD_LOGIC_VECTOR ( 1 downto 0 );
  signal s00_couplers_to_auto_pc_ARCACHE : STD_LOGIC_VECTOR ( 3 downto 0 );
  signal s00_couplers_to_auto_pc_ARID : STD_LOGIC_VECTOR ( 11 downto 0 );
  signal s00_couplers_to_auto_pc_ARLEN : STD_LOGIC_VECTOR ( 3 downto 0 );
  signal s00_couplers_to_auto_pc_ARLOCK : STD_LOGIC_VECTOR ( 1 downto 0 );
  signal s00_couplers_to_auto_pc_ARPROT : STD_LOGIC_VECTOR ( 2 downto 0 );
  signal s00_couplers_to_auto_pc_ARQOS : STD_LOGIC_VECTOR ( 3 downto 0 );
  signal s00_couplers_to_auto_pc_ARREADY : STD_LOGIC;
  signal s00_couplers_to_auto_pc_ARSIZE : STD_LOGIC_VECTOR ( 2 downto 0 );
  signal s00_couplers_to_auto_pc_ARVALID : STD_LOGIC;
  signal s00_couplers_to_auto_pc_AWADDR : STD_LOGIC_VECTOR ( 31 downto 0 );
  signal s00_couplers_to_auto_pc_AWBURST : STD_LOGIC_VECTOR ( 1 downto 0 );
  signal s00_couplers_to_auto_pc_AWCACHE : STD_LOGIC_VECTOR ( 3 downto 0 );
  signal s00_couplers_to_auto_pc_AWID : STD_LOGIC_VECTOR ( 11 downto 0 );
  signal s00_couplers_to_auto_pc_AWLEN : STD_LOGIC_VECTOR ( 3 downto 0 );
  signal s00_couplers_to_auto_pc_AWLOCK : STD_LOGIC_VECTOR ( 1 downto 0 );
  signal s00_couplers_to_auto_pc_AWPROT : STD_LOGIC_VECTOR ( 2 downto 0 );
  signal s00_couplers_to_auto_pc_AWQOS : STD_LOGIC_VECTOR ( 3 downto 0 );
  signal s00_couplers_to_auto_pc_AWREADY : STD_LOGIC;
  signal s00_couplers_to_auto_pc_AWSIZE : STD_LOGIC_VECTOR ( 2 downto 0 );
  signal s00_couplers_to_auto_pc_AWVALID : STD_LOGIC;
  signal s00_couplers_to_auto_pc_BID : STD_LOGIC_VECTOR ( 11 downto 0 );
  signal s00_couplers_to_auto_pc_BREADY : STD_LOGIC;
  signal s00_couplers_to_auto_pc_BRESP : STD_LOGIC_VECTOR ( 1 downto 0 );
  signal s00_couplers_to_auto_pc_BVALID : STD_LOGIC;
  signal s00_couplers_to_auto_pc_RDATA : STD_LOGIC_VECTOR ( 31 downto 0 );
  signal s00_couplers_to_auto_pc_RID : STD_LOGIC_VECTOR ( 11 downto 0 );
  signal s00_couplers_to_auto_pc_RLAST : STD_LOGIC;
  signal s00_couplers_to_auto_pc_RREADY : STD_LOGIC;
  signal s00_couplers_to_auto_pc_RRESP : STD_LOGIC_VECTOR ( 1 downto 0 );
  signal s00_couplers_to_auto_pc_RVALID : STD_LOGIC;
  signal s00_couplers_to_auto_pc_WDATA : STD_LOGIC_VECTOR ( 31 downto 0 );
  signal s00_couplers_to_auto_pc_WID : STD_LOGIC_VECTOR ( 11 downto 0 );
  signal s00_couplers_to_auto_pc_WLAST : STD_LOGIC;
  signal s00_couplers_to_auto_pc_WREADY : STD_LOGIC;
  signal s00_couplers_to_auto_pc_WSTRB : STD_LOGIC_VECTOR ( 3 downto 0 );
  signal s00_couplers_to_auto_pc_WVALID : STD_LOGIC;
begin
  M_AXI_araddr(31 downto 0) <= auto_pc_to_s00_couplers_ARADDR(31 downto 0);
  M_AXI_arprot(2 downto 0) <= auto_pc_to_s00_couplers_ARPROT(2 downto 0);
  M_AXI_arvalid <= auto_pc_to_s00_couplers_ARVALID;
  M_AXI_awaddr(31 downto 0) <= auto_pc_to_s00_couplers_AWADDR(31 downto 0);
  M_AXI_awprot(2 downto 0) <= auto_pc_to_s00_couplers_AWPROT(2 downto 0);
  M_AXI_awvalid <= auto_pc_to_s00_couplers_AWVALID;
  M_AXI_bready <= auto_pc_to_s00_couplers_BREADY;
  M_AXI_rready <= auto_pc_to_s00_couplers_RREADY;
  M_AXI_wdata(31 downto 0) <= auto_pc_to_s00_couplers_WDATA(31 downto 0);
  M_AXI_wstrb(3 downto 0) <= auto_pc_to_s00_couplers_WSTRB(3 downto 0);
  M_AXI_wvalid <= auto_pc_to_s00_couplers_WVALID;
  S_ACLK_1 <= S_ACLK;
  S_ARESETN_1 <= S_ARESETN;
  S_AXI_arready <= s00_couplers_to_auto_pc_ARREADY;
  S_AXI_awready <= s00_couplers_to_auto_pc_AWREADY;
  S_AXI_bid(11 downto 0) <= s00_couplers_to_auto_pc_BID(11 downto 0);
  S_AXI_bresp(1 downto 0) <= s00_couplers_to_auto_pc_BRESP(1 downto 0);
  S_AXI_bvalid <= s00_couplers_to_auto_pc_BVALID;
  S_AXI_rdata(31 downto 0) <= s00_couplers_to_auto_pc_RDATA(31 downto 0);
  S_AXI_rid(11 downto 0) <= s00_couplers_to_auto_pc_RID(11 downto 0);
  S_AXI_rlast <= s00_couplers_to_auto_pc_RLAST;
  S_AXI_rresp(1 downto 0) <= s00_couplers_to_auto_pc_RRESP(1 downto 0);
  S_AXI_rvalid <= s00_couplers_to_auto_pc_RVALID;
  S_AXI_wready <= s00_couplers_to_auto_pc_WREADY;
  auto_pc_to_s00_couplers_ARREADY <= M_AXI_arready;
  auto_pc_to_s00_couplers_AWREADY <= M_AXI_awready;
  auto_pc_to_s00_couplers_BRESP(1 downto 0) <= M_AXI_bresp(1 downto 0);
  auto_pc_to_s00_couplers_BVALID <= M_AXI_bvalid;
  auto_pc_to_s00_couplers_RDATA(31 downto 0) <= M_AXI_rdata(31 downto 0);
  auto_pc_to_s00_couplers_RRESP(1 downto 0) <= M_AXI_rresp(1 downto 0);
  auto_pc_to_s00_couplers_RVALID <= M_AXI_rvalid;
  auto_pc_to_s00_couplers_WREADY <= M_AXI_wready;
  s00_couplers_to_auto_pc_ARADDR(31 downto 0) <= S_AXI_araddr(31 downto 0);
  s00_couplers_to_auto_pc_ARBURST(1 downto 0) <= S_AXI_arburst(1 downto 0);
  s00_couplers_to_auto_pc_ARCACHE(3 downto 0) <= S_AXI_arcache(3 downto 0);
  s00_couplers_to_auto_pc_ARID(11 downto 0) <= S_AXI_arid(11 downto 0);
  s00_couplers_to_auto_pc_ARLEN(3 downto 0) <= S_AXI_arlen(3 downto 0);
  s00_couplers_to_auto_pc_ARLOCK(1 downto 0) <= S_AXI_arlock(1 downto 0);
  s00_couplers_to_auto_pc_ARPROT(2 downto 0) <= S_AXI_arprot(2 downto 0);
  s00_couplers_to_auto_pc_ARQOS(3 downto 0) <= S_AXI_arqos(3 downto 0);
  s00_couplers_to_auto_pc_ARSIZE(2 downto 0) <= S_AXI_arsize(2 downto 0);
  s00_couplers_to_auto_pc_ARVALID <= S_AXI_arvalid;
  s00_couplers_to_auto_pc_AWADDR(31 downto 0) <= S_AXI_awaddr(31 downto 0);
  s00_couplers_to_auto_pc_AWBURST(1 downto 0) <= S_AXI_awburst(1 downto 0);
  s00_couplers_to_auto_pc_AWCACHE(3 downto 0) <= S_AXI_awcache(3 downto 0);
  s00_couplers_to_auto_pc_AWID(11 downto 0) <= S_AXI_awid(11 downto 0);
  s00_couplers_to_auto_pc_AWLEN(3 downto 0) <= S_AXI_awlen(3 downto 0);
  s00_couplers_to_auto_pc_AWLOCK(1 downto 0) <= S_AXI_awlock(1 downto 0);
  s00_couplers_to_auto_pc_AWPROT(2 downto 0) <= S_AXI_awprot(2 downto 0);
  s00_couplers_to_auto_pc_AWQOS(3 downto 0) <= S_AXI_awqos(3 downto 0);
  s00_couplers_to_auto_pc_AWSIZE(2 downto 0) <= S_AXI_awsize(2 downto 0);
  s00_couplers_to_auto_pc_AWVALID <= S_AXI_awvalid;
  s00_couplers_to_auto_pc_BREADY <= S_AXI_bready;
  s00_couplers_to_auto_pc_RREADY <= S_AXI_rready;
  s00_couplers_to_auto_pc_WDATA(31 downto 0) <= S_AXI_wdata(31 downto 0);
  s00_couplers_to_auto_pc_WID(11 downto 0) <= S_AXI_wid(11 downto 0);
  s00_couplers_to_auto_pc_WLAST <= S_AXI_wlast;
  s00_couplers_to_auto_pc_WSTRB(3 downto 0) <= S_AXI_wstrb(3 downto 0);
  s00_couplers_to_auto_pc_WVALID <= S_AXI_wvalid;
auto_pc: component base_zynq_auto_pc_1
     port map (
      aclk => S_ACLK_1,
      aresetn => S_ARESETN_1,
      m_axi_araddr(31 downto 0) => auto_pc_to_s00_couplers_ARADDR(31 downto 0),
      m_axi_arprot(2 downto 0) => auto_pc_to_s00_couplers_ARPROT(2 downto 0),
      m_axi_arready => auto_pc_to_s00_couplers_ARREADY,
      m_axi_arvalid => auto_pc_to_s00_couplers_ARVALID,
      m_axi_awaddr(31 downto 0) => auto_pc_to_s00_couplers_AWADDR(31 downto 0),
      m_axi_awprot(2 downto 0) => auto_pc_to_s00_couplers_AWPROT(2 downto 0),
      m_axi_awready => auto_pc_to_s00_couplers_AWREADY,
      m_axi_awvalid => auto_pc_to_s00_couplers_AWVALID,
      m_axi_bready => auto_pc_to_s00_couplers_BREADY,
      m_axi_bresp(1 downto 0) => auto_pc_to_s00_couplers_BRESP(1 downto 0),
      m_axi_bvalid => auto_pc_to_s00_couplers_BVALID,
      m_axi_rdata(31 downto 0) => auto_pc_to_s00_couplers_RDATA(31 downto 0),
      m_axi_rready => auto_pc_to_s00_couplers_RREADY,
      m_axi_rresp(1 downto 0) => auto_pc_to_s00_couplers_RRESP(1 downto 0),
      m_axi_rvalid => auto_pc_to_s00_couplers_RVALID,
      m_axi_wdata(31 downto 0) => auto_pc_to_s00_couplers_WDATA(31 downto 0),
      m_axi_wready => auto_pc_to_s00_couplers_WREADY,
      m_axi_wstrb(3 downto 0) => auto_pc_to_s00_couplers_WSTRB(3 downto 0),
      m_axi_wvalid => auto_pc_to_s00_couplers_WVALID,
      s_axi_araddr(31 downto 0) => s00_couplers_to_auto_pc_ARADDR(31 downto 0),
      s_axi_arburst(1 downto 0) => s00_couplers_to_auto_pc_ARBURST(1 downto 0),
      s_axi_arcache(3 downto 0) => s00_couplers_to_auto_pc_ARCACHE(3 downto 0),
      s_axi_arid(11 downto 0) => s00_couplers_to_auto_pc_ARID(11 downto 0),
      s_axi_arlen(3 downto 0) => s00_couplers_to_auto_pc_ARLEN(3 downto 0),
      s_axi_arlock(1 downto 0) => s00_couplers_to_auto_pc_ARLOCK(1 downto 0),
      s_axi_arprot(2 downto 0) => s00_couplers_to_auto_pc_ARPROT(2 downto 0),
      s_axi_arqos(3 downto 0) => s00_couplers_to_auto_pc_ARQOS(3 downto 0),
      s_axi_arready => s00_couplers_to_auto_pc_ARREADY,
      s_axi_arsize(2 downto 0) => s00_couplers_to_auto_pc_ARSIZE(2 downto 0),
      s_axi_arvalid => s00_couplers_to_auto_pc_ARVALID,
      s_axi_awaddr(31 downto 0) => s00_couplers_to_auto_pc_AWADDR(31 downto 0),
      s_axi_awburst(1 downto 0) => s00_couplers_to_auto_pc_AWBURST(1 downto 0),
      s_axi_awcache(3 downto 0) => s00_couplers_to_auto_pc_AWCACHE(3 downto 0),
      s_axi_awid(11 downto 0) => s00_couplers_to_auto_pc_AWID(11 downto 0),
      s_axi_awlen(3 downto 0) => s00_couplers_to_auto_pc_AWLEN(3 downto 0),
      s_axi_awlock(1 downto 0) => s00_couplers_to_auto_pc_AWLOCK(1 downto 0),
      s_axi_awprot(2 downto 0) => s00_couplers_to_auto_pc_AWPROT(2 downto 0),
      s_axi_awqos(3 downto 0) => s00_couplers_to_auto_pc_AWQOS(3 downto 0),
      s_axi_awready => s00_couplers_to_auto_pc_AWREADY,
      s_axi_awsize(2 downto 0) => s00_couplers_to_auto_pc_AWSIZE(2 downto 0),
      s_axi_awvalid => s00_couplers_to_auto_pc_AWVALID,
      s_axi_bid(11 downto 0) => s00_couplers_to_auto_pc_BID(11 downto 0),
      s_axi_bready => s00_couplers_to_auto_pc_BREADY,
      s_axi_bresp(1 downto 0) => s00_couplers_to_auto_pc_BRESP(1 downto 0),
      s_axi_bvalid => s00_couplers_to_auto_pc_BVALID,
      s_axi_rdata(31 downto 0) => s00_couplers_to_auto_pc_RDATA(31 downto 0),
      s_axi_rid(11 downto 0) => s00_couplers_to_auto_pc_RID(11 downto 0),
      s_axi_rlast => s00_couplers_to_auto_pc_RLAST,
      s_axi_rready => s00_couplers_to_auto_pc_RREADY,
      s_axi_rresp(1 downto 0) => s00_couplers_to_auto_pc_RRESP(1 downto 0),
      s_axi_rvalid => s00_couplers_to_auto_pc_RVALID,
      s_axi_wdata(31 downto 0) => s00_couplers_to_auto_pc_WDATA(31 downto 0),
      s_axi_wid(11 downto 0) => s00_couplers_to_auto_pc_WID(11 downto 0),
      s_axi_wlast => s00_couplers_to_auto_pc_WLAST,
      s_axi_wready => s00_couplers_to_auto_pc_WREADY,
      s_axi_wstrb(3 downto 0) => s00_couplers_to_auto_pc_WSTRB(3 downto 0),
      s_axi_wvalid => s00_couplers_to_auto_pc_WVALID
    );
end STRUCTURE;
library IEEE;
use IEEE.STD_LOGIC_1164.ALL;
library UNISIM;
use UNISIM.VCOMPONENTS.ALL;
entity s01_couplers_imp_Z3K9KA is
  port (
    M_AXIS_ACLK : in STD_LOGIC;
    M_AXIS_ARESETN : in STD_LOGIC;
    M_AXIS_tdata : out STD_LOGIC_VECTOR ( 31 downto 0 );
    M_AXIS_tid : out STD_LOGIC_VECTOR ( 1 downto 0 );
    M_AXIS_tlast : out STD_LOGIC;
    M_AXIS_tready : in STD_LOGIC;
    M_AXIS_tstrb : out STD_LOGIC_VECTOR ( 3 downto 0 );
    M_AXIS_tvalid : out STD_LOGIC;
    S_AXIS_ACLK : in STD_LOGIC;
    S_AXIS_ARESETN : in STD_LOGIC;
    S_AXIS_tdata : in STD_LOGIC_VECTOR ( 31 downto 0 );
    S_AXIS_tid : in STD_LOGIC_VECTOR ( 1 downto 0 );
    S_AXIS_tlast : in STD_LOGIC;
    S_AXIS_tready : out STD_LOGIC;
    S_AXIS_tstrb : in STD_LOGIC_VECTOR ( 3 downto 0 );
    S_AXIS_tvalid : in STD_LOGIC
  );
end s01_couplers_imp_Z3K9KA;

architecture STRUCTURE of s01_couplers_imp_Z3K9KA is
  component base_zynq_s01_data_fifo_0 is
  port (
    s_axis_aresetn : in STD_LOGIC;
    s_axis_aclk : in STD_LOGIC;
    s_axis_tvalid : in STD_LOGIC;
    s_axis_tready : out STD_LOGIC;
    s_axis_tdata : in STD_LOGIC_VECTOR ( 31 downto 0 );
    s_axis_tstrb : in STD_LOGIC_VECTOR ( 3 downto 0 );
    s_axis_tlast : in STD_LOGIC;
    s_axis_tid : in STD_LOGIC_VECTOR ( 1 downto 0 );
    m_axis_tvalid : out STD_LOGIC;
    m_axis_tready : in STD_LOGIC;
    m_axis_tdata : out STD_LOGIC_VECTOR ( 31 downto 0 );
    m_axis_tstrb : out STD_LOGIC_VECTOR ( 3 downto 0 );
    m_axis_tlast : out STD_LOGIC;
    m_axis_tid : out STD_LOGIC_VECTOR ( 1 downto 0 );
    axis_wr_data_count : out STD_LOGIC_VECTOR ( 31 downto 0 );
    axis_rd_data_count : out STD_LOGIC_VECTOR ( 31 downto 0 )
  );
  end component base_zynq_s01_data_fifo_0;
  signal AXIS_RD_DATA_COUNT_to_S_AXIS_RD_DATA_COUNT : STD_LOGIC_VECTOR ( 31 downto 0 );
  signal AXIS_WR_DATA_COUNT_to_S_AXIS_WR_DATA_COUNT : STD_LOGIC_VECTOR ( 31 downto 0 );
  signal s01_couplers_to_s01_data_fifo_TDATA : STD_LOGIC_VECTOR ( 31 downto 0 );
  signal s01_couplers_to_s01_data_fifo_TID : STD_LOGIC_VECTOR ( 1 downto 0 );
  signal s01_couplers_to_s01_data_fifo_TLAST : STD_LOGIC;
  signal s01_couplers_to_s01_data_fifo_TREADY : STD_LOGIC;
  signal s01_couplers_to_s01_data_fifo_TSTRB : STD_LOGIC_VECTOR ( 3 downto 0 );
  signal s01_couplers_to_s01_data_fifo_TVALID : STD_LOGIC;
  signal s01_data_fifo_to_s01_couplers_TDATA : STD_LOGIC_VECTOR ( 31 downto 0 );
  signal s01_data_fifo_to_s01_couplers_TID : STD_LOGIC_VECTOR ( 1 downto 0 );
  signal s01_data_fifo_to_s01_couplers_TLAST : STD_LOGIC;
  signal s01_data_fifo_to_s01_couplers_TREADY : STD_LOGIC;
  signal s01_data_fifo_to_s01_couplers_TSTRB : STD_LOGIC_VECTOR ( 3 downto 0 );
  signal s01_data_fifo_to_s01_couplers_TVALID : STD_LOGIC;
begin
  M_AXIS_tdata(31 downto 0) <= s01_data_fifo_to_s01_couplers_TDATA(31 downto 0);
  M_AXIS_tid(1 downto 0) <= s01_data_fifo_to_s01_couplers_TID(1 downto 0);
  M_AXIS_tlast <= s01_data_fifo_to_s01_couplers_TLAST;
  M_AXIS_tstrb(3 downto 0) <= s01_data_fifo_to_s01_couplers_TSTRB(3 downto 0);
  M_AXIS_tvalid <= s01_data_fifo_to_s01_couplers_TVALID;
  S_AXIS_tready <= s01_couplers_to_s01_data_fifo_TREADY;
  s01_couplers_to_s01_data_fifo_TDATA(31 downto 0) <= S_AXIS_tdata(31 downto 0);
  s01_couplers_to_s01_data_fifo_TID(1 downto 0) <= S_AXIS_tid(1 downto 0);
  s01_couplers_to_s01_data_fifo_TLAST <= S_AXIS_tlast;
  s01_couplers_to_s01_data_fifo_TSTRB(3 downto 0) <= S_AXIS_tstrb(3 downto 0);
  s01_couplers_to_s01_data_fifo_TVALID <= S_AXIS_tvalid;
  s01_data_fifo_to_s01_couplers_TREADY <= M_AXIS_tready;
s01_data_fifo: component base_zynq_s01_data_fifo_0
     port map (
      axis_rd_data_count(31 downto 0) => AXIS_RD_DATA_COUNT_to_S_AXIS_RD_DATA_COUNT(31 downto 0),
      axis_wr_data_count(31 downto 0) => AXIS_WR_DATA_COUNT_to_S_AXIS_WR_DATA_COUNT(31 downto 0),
      m_axis_tdata(31 downto 0) => s01_data_fifo_to_s01_couplers_TDATA(31 downto 0),
      m_axis_tid(1 downto 0) => s01_data_fifo_to_s01_couplers_TID(1 downto 0),
      m_axis_tlast => s01_data_fifo_to_s01_couplers_TLAST,
      m_axis_tready => s01_data_fifo_to_s01_couplers_TREADY,
      m_axis_tstrb(3 downto 0) => s01_data_fifo_to_s01_couplers_TSTRB(3 downto 0),
      m_axis_tvalid => s01_data_fifo_to_s01_couplers_TVALID,
      s_axis_aclk => M_AXIS_ACLK,
      s_axis_aresetn => M_AXIS_ARESETN,
      s_axis_tdata(31 downto 0) => s01_couplers_to_s01_data_fifo_TDATA(31 downto 0),
      s_axis_tid(1 downto 0) => s01_couplers_to_s01_data_fifo_TID(1 downto 0),
      s_axis_tlast => s01_couplers_to_s01_data_fifo_TLAST,
      s_axis_tready => s01_couplers_to_s01_data_fifo_TREADY,
      s_axis_tstrb(3 downto 0) => s01_couplers_to_s01_data_fifo_TSTRB(3 downto 0),
      s_axis_tvalid => s01_couplers_to_s01_data_fifo_TVALID
    );
end STRUCTURE;
library IEEE;
use IEEE.STD_LOGIC_1164.ALL;
library UNISIM;
use UNISIM.VCOMPONENTS.ALL;
entity base_zynq_axi_interconnect_0_0 is
  port (
    ACLK : in STD_LOGIC;
    ARESETN : in STD_LOGIC;
    M00_ACLK : in STD_LOGIC;
    M00_ARESETN : in STD_LOGIC;
    M00_AXI_awaddr : out STD_LOGIC_VECTOR ( 31 downto 0 );
    M00_AXI_awburst : out STD_LOGIC_VECTOR ( 1 downto 0 );
    M00_AXI_awcache : out STD_LOGIC_VECTOR ( 3 downto 0 );
    M00_AXI_awlen : out STD_LOGIC_VECTOR ( 3 downto 0 );
    M00_AXI_awlock : out STD_LOGIC_VECTOR ( 1 downto 0 );
    M00_AXI_awprot : out STD_LOGIC_VECTOR ( 2 downto 0 );
    M00_AXI_awqos : out STD_LOGIC_VECTOR ( 3 downto 0 );
    M00_AXI_awready : in STD_LOGIC;
    M00_AXI_awsize : out STD_LOGIC_VECTOR ( 2 downto 0 );
    M00_AXI_awvalid : out STD_LOGIC;
    M00_AXI_bready : out STD_LOGIC;
    M00_AXI_bresp : in STD_LOGIC_VECTOR ( 1 downto 0 );
    M00_AXI_bvalid : in STD_LOGIC;
    M00_AXI_wdata : out STD_LOGIC_VECTOR ( 31 downto 0 );
    M00_AXI_wlast : out STD_LOGIC;
    M00_AXI_wready : in STD_LOGIC;
    M00_AXI_wstrb : out STD_LOGIC_VECTOR ( 3 downto 0 );
    M00_AXI_wvalid : out STD_LOGIC;
    S00_ACLK : in STD_LOGIC;
    S00_ARESETN : in STD_LOGIC;
    S00_AXI_awaddr : in STD_LOGIC_VECTOR ( 31 downto 0 );
    S00_AXI_awburst : in STD_LOGIC_VECTOR ( 1 downto 0 );
    S00_AXI_awcache : in STD_LOGIC_VECTOR ( 3 downto 0 );
    S00_AXI_awlen : in STD_LOGIC_VECTOR ( 7 downto 0 );
    S00_AXI_awprot : in STD_LOGIC_VECTOR ( 2 downto 0 );
    S00_AXI_awready : out STD_LOGIC;
    S00_AXI_awsize : in STD_LOGIC_VECTOR ( 2 downto 0 );
    S00_AXI_awvalid : in STD_LOGIC;
    S00_AXI_bready : in STD_LOGIC;
    S00_AXI_bresp : out STD_LOGIC_VECTOR ( 1 downto 0 );
    S00_AXI_bvalid : out STD_LOGIC;
    S00_AXI_wdata : in STD_LOGIC_VECTOR ( 31 downto 0 );
    S00_AXI_wlast : in STD_LOGIC;
    S00_AXI_wready : out STD_LOGIC;
    S00_AXI_wstrb : in STD_LOGIC_VECTOR ( 3 downto 0 );
    S00_AXI_wvalid : in STD_LOGIC
  );
end base_zynq_axi_interconnect_0_0;

architecture STRUCTURE of base_zynq_axi_interconnect_0_0 is
  signal S00_ACLK_1 : STD_LOGIC;
  signal S00_ARESETN_1 : STD_LOGIC;
  signal axi_interconnect_0_ACLK_net : STD_LOGIC;
  signal axi_interconnect_0_ARESETN_net : STD_LOGIC;
  signal axi_interconnect_0_to_s00_couplers_AWADDR : STD_LOGIC_VECTOR ( 31 downto 0 );
  signal axi_interconnect_0_to_s00_couplers_AWBURST : STD_LOGIC_VECTOR ( 1 downto 0 );
  signal axi_interconnect_0_to_s00_couplers_AWCACHE : STD_LOGIC_VECTOR ( 3 downto 0 );
  signal axi_interconnect_0_to_s00_couplers_AWLEN : STD_LOGIC_VECTOR ( 7 downto 0 );
  signal axi_interconnect_0_to_s00_couplers_AWPROT : STD_LOGIC_VECTOR ( 2 downto 0 );
  signal axi_interconnect_0_to_s00_couplers_AWREADY : STD_LOGIC;
  signal axi_interconnect_0_to_s00_couplers_AWSIZE : STD_LOGIC_VECTOR ( 2 downto 0 );
  signal axi_interconnect_0_to_s00_couplers_AWVALID : STD_LOGIC;
  signal axi_interconnect_0_to_s00_couplers_BREADY : STD_LOGIC;
  signal axi_interconnect_0_to_s00_couplers_BRESP : STD_LOGIC_VECTOR ( 1 downto 0 );
  signal axi_interconnect_0_to_s00_couplers_BVALID : STD_LOGIC;
  signal axi_interconnect_0_to_s00_couplers_WDATA : STD_LOGIC_VECTOR ( 31 downto 0 );
  signal axi_interconnect_0_to_s00_couplers_WLAST : STD_LOGIC;
  signal axi_interconnect_0_to_s00_couplers_WREADY : STD_LOGIC;
  signal axi_interconnect_0_to_s00_couplers_WSTRB : STD_LOGIC_VECTOR ( 3 downto 0 );
  signal axi_interconnect_0_to_s00_couplers_WVALID : STD_LOGIC;
  signal s00_couplers_to_axi_interconnect_0_AWADDR : STD_LOGIC_VECTOR ( 31 downto 0 );
  signal s00_couplers_to_axi_interconnect_0_AWBURST : STD_LOGIC_VECTOR ( 1 downto 0 );
  signal s00_couplers_to_axi_interconnect_0_AWCACHE : STD_LOGIC_VECTOR ( 3 downto 0 );
  signal s00_couplers_to_axi_interconnect_0_AWLEN : STD_LOGIC_VECTOR ( 3 downto 0 );
  signal s00_couplers_to_axi_interconnect_0_AWLOCK : STD_LOGIC_VECTOR ( 1 downto 0 );
  signal s00_couplers_to_axi_interconnect_0_AWPROT : STD_LOGIC_VECTOR ( 2 downto 0 );
  signal s00_couplers_to_axi_interconnect_0_AWQOS : STD_LOGIC_VECTOR ( 3 downto 0 );
  signal s00_couplers_to_axi_interconnect_0_AWREADY : STD_LOGIC;
  signal s00_couplers_to_axi_interconnect_0_AWSIZE : STD_LOGIC_VECTOR ( 2 downto 0 );
  signal s00_couplers_to_axi_interconnect_0_AWVALID : STD_LOGIC;
  signal s00_couplers_to_axi_interconnect_0_BREADY : STD_LOGIC;
  signal s00_couplers_to_axi_interconnect_0_BRESP : STD_LOGIC_VECTOR ( 1 downto 0 );
  signal s00_couplers_to_axi_interconnect_0_BVALID : STD_LOGIC;
  signal s00_couplers_to_axi_interconnect_0_WDATA : STD_LOGIC_VECTOR ( 31 downto 0 );
  signal s00_couplers_to_axi_interconnect_0_WLAST : STD_LOGIC;
  signal s00_couplers_to_axi_interconnect_0_WREADY : STD_LOGIC;
  signal s00_couplers_to_axi_interconnect_0_WSTRB : STD_LOGIC_VECTOR ( 3 downto 0 );
  signal s00_couplers_to_axi_interconnect_0_WVALID : STD_LOGIC;
begin
  M00_AXI_awaddr(31 downto 0) <= s00_couplers_to_axi_interconnect_0_AWADDR(31 downto 0);
  M00_AXI_awburst(1 downto 0) <= s00_couplers_to_axi_interconnect_0_AWBURST(1 downto 0);
  M00_AXI_awcache(3 downto 0) <= s00_couplers_to_axi_interconnect_0_AWCACHE(3 downto 0);
  M00_AXI_awlen(3 downto 0) <= s00_couplers_to_axi_interconnect_0_AWLEN(3 downto 0);
  M00_AXI_awlock(1 downto 0) <= s00_couplers_to_axi_interconnect_0_AWLOCK(1 downto 0);
  M00_AXI_awprot(2 downto 0) <= s00_couplers_to_axi_interconnect_0_AWPROT(2 downto 0);
  M00_AXI_awqos(3 downto 0) <= s00_couplers_to_axi_interconnect_0_AWQOS(3 downto 0);
  M00_AXI_awsize(2 downto 0) <= s00_couplers_to_axi_interconnect_0_AWSIZE(2 downto 0);
  M00_AXI_awvalid <= s00_couplers_to_axi_interconnect_0_AWVALID;
  M00_AXI_bready <= s00_couplers_to_axi_interconnect_0_BREADY;
  M00_AXI_wdata(31 downto 0) <= s00_couplers_to_axi_interconnect_0_WDATA(31 downto 0);
  M00_AXI_wlast <= s00_couplers_to_axi_interconnect_0_WLAST;
  M00_AXI_wstrb(3 downto 0) <= s00_couplers_to_axi_interconnect_0_WSTRB(3 downto 0);
  M00_AXI_wvalid <= s00_couplers_to_axi_interconnect_0_WVALID;
  S00_ACLK_1 <= S00_ACLK;
  S00_ARESETN_1 <= S00_ARESETN;
  S00_AXI_awready <= axi_interconnect_0_to_s00_couplers_AWREADY;
  S00_AXI_bresp(1 downto 0) <= axi_interconnect_0_to_s00_couplers_BRESP(1 downto 0);
  S00_AXI_bvalid <= axi_interconnect_0_to_s00_couplers_BVALID;
  S00_AXI_wready <= axi_interconnect_0_to_s00_couplers_WREADY;
  axi_interconnect_0_ACLK_net <= M00_ACLK;
  axi_interconnect_0_ARESETN_net <= M00_ARESETN;
  axi_interconnect_0_to_s00_couplers_AWADDR(31 downto 0) <= S00_AXI_awaddr(31 downto 0);
  axi_interconnect_0_to_s00_couplers_AWBURST(1 downto 0) <= S00_AXI_awburst(1 downto 0);
  axi_interconnect_0_to_s00_couplers_AWCACHE(3 downto 0) <= S00_AXI_awcache(3 downto 0);
  axi_interconnect_0_to_s00_couplers_AWLEN(7 downto 0) <= S00_AXI_awlen(7 downto 0);
  axi_interconnect_0_to_s00_couplers_AWPROT(2 downto 0) <= S00_AXI_awprot(2 downto 0);
  axi_interconnect_0_to_s00_couplers_AWSIZE(2 downto 0) <= S00_AXI_awsize(2 downto 0);
  axi_interconnect_0_to_s00_couplers_AWVALID <= S00_AXI_awvalid;
  axi_interconnect_0_to_s00_couplers_BREADY <= S00_AXI_bready;
  axi_interconnect_0_to_s00_couplers_WDATA(31 downto 0) <= S00_AXI_wdata(31 downto 0);
  axi_interconnect_0_to_s00_couplers_WLAST <= S00_AXI_wlast;
  axi_interconnect_0_to_s00_couplers_WSTRB(3 downto 0) <= S00_AXI_wstrb(3 downto 0);
  axi_interconnect_0_to_s00_couplers_WVALID <= S00_AXI_wvalid;
  s00_couplers_to_axi_interconnect_0_AWREADY <= M00_AXI_awready;
  s00_couplers_to_axi_interconnect_0_BRESP(1 downto 0) <= M00_AXI_bresp(1 downto 0);
  s00_couplers_to_axi_interconnect_0_BVALID <= M00_AXI_bvalid;
  s00_couplers_to_axi_interconnect_0_WREADY <= M00_AXI_wready;
s00_couplers: entity work.s00_couplers_imp_1IAW1WV
     port map (
      M_ACLK => axi_interconnect_0_ACLK_net,
      M_ARESETN => axi_interconnect_0_ARESETN_net,
      M_AXI_awaddr(31 downto 0) => s00_couplers_to_axi_interconnect_0_AWADDR(31 downto 0),
      M_AXI_awburst(1 downto 0) => s00_couplers_to_axi_interconnect_0_AWBURST(1 downto 0),
      M_AXI_awcache(3 downto 0) => s00_couplers_to_axi_interconnect_0_AWCACHE(3 downto 0),
      M_AXI_awlen(3 downto 0) => s00_couplers_to_axi_interconnect_0_AWLEN(3 downto 0),
      M_AXI_awlock(1 downto 0) => s00_couplers_to_axi_interconnect_0_AWLOCK(1 downto 0),
      M_AXI_awprot(2 downto 0) => s00_couplers_to_axi_interconnect_0_AWPROT(2 downto 0),
      M_AXI_awqos(3 downto 0) => s00_couplers_to_axi_interconnect_0_AWQOS(3 downto 0),
      M_AXI_awready => s00_couplers_to_axi_interconnect_0_AWREADY,
      M_AXI_awsize(2 downto 0) => s00_couplers_to_axi_interconnect_0_AWSIZE(2 downto 0),
      M_AXI_awvalid => s00_couplers_to_axi_interconnect_0_AWVALID,
      M_AXI_bready => s00_couplers_to_axi_interconnect_0_BREADY,
      M_AXI_bresp(1 downto 0) => s00_couplers_to_axi_interconnect_0_BRESP(1 downto 0),
      M_AXI_bvalid => s00_couplers_to_axi_interconnect_0_BVALID,
      M_AXI_wdata(31 downto 0) => s00_couplers_to_axi_interconnect_0_WDATA(31 downto 0),
      M_AXI_wlast => s00_couplers_to_axi_interconnect_0_WLAST,
      M_AXI_wready => s00_couplers_to_axi_interconnect_0_WREADY,
      M_AXI_wstrb(3 downto 0) => s00_couplers_to_axi_interconnect_0_WSTRB(3 downto 0),
      M_AXI_wvalid => s00_couplers_to_axi_interconnect_0_WVALID,
      S_ACLK => S00_ACLK_1,
      S_ARESETN => S00_ARESETN_1,
      S_AXI_awaddr(31 downto 0) => axi_interconnect_0_to_s00_couplers_AWADDR(31 downto 0),
      S_AXI_awburst(1 downto 0) => axi_interconnect_0_to_s00_couplers_AWBURST(1 downto 0),
      S_AXI_awcache(3 downto 0) => axi_interconnect_0_to_s00_couplers_AWCACHE(3 downto 0),
      S_AXI_awlen(7 downto 0) => axi_interconnect_0_to_s00_couplers_AWLEN(7 downto 0),
      S_AXI_awprot(2 downto 0) => axi_interconnect_0_to_s00_couplers_AWPROT(2 downto 0),
      S_AXI_awready => axi_interconnect_0_to_s00_couplers_AWREADY,
      S_AXI_awsize(2 downto 0) => axi_interconnect_0_to_s00_couplers_AWSIZE(2 downto 0),
      S_AXI_awvalid => axi_interconnect_0_to_s00_couplers_AWVALID,
      S_AXI_bready => axi_interconnect_0_to_s00_couplers_BREADY,
      S_AXI_bresp(1 downto 0) => axi_interconnect_0_to_s00_couplers_BRESP(1 downto 0),
      S_AXI_bvalid => axi_interconnect_0_to_s00_couplers_BVALID,
      S_AXI_wdata(31 downto 0) => axi_interconnect_0_to_s00_couplers_WDATA(31 downto 0),
      S_AXI_wlast => axi_interconnect_0_to_s00_couplers_WLAST,
      S_AXI_wready => axi_interconnect_0_to_s00_couplers_WREADY,
      S_AXI_wstrb(3 downto 0) => axi_interconnect_0_to_s00_couplers_WSTRB(3 downto 0),
      S_AXI_wvalid => axi_interconnect_0_to_s00_couplers_WVALID
    );
end STRUCTURE;
library IEEE;
use IEEE.STD_LOGIC_1164.ALL;
library UNISIM;
use UNISIM.VCOMPONENTS.ALL;
entity base_zynq_axis_interconnect_0_1 is
  port (
    ACLK : in STD_LOGIC;
    ARESETN : in STD_LOGIC;
    M00_AXIS_ACLK : in STD_LOGIC;
    M00_AXIS_ARESETN : in STD_LOGIC;
    M00_AXIS_tdata : out STD_LOGIC_VECTOR ( 31 downto 0 );
    M00_AXIS_tkeep : out STD_LOGIC_VECTOR ( 3 downto 0 );
    M00_AXIS_tlast : out STD_LOGIC;
    M00_AXIS_tready : in STD_LOGIC;
    M00_AXIS_tvalid : out STD_LOGIC;
    S00_ARB_REQ_SUPPRESS : in STD_LOGIC;
    S00_AXIS_ACLK : in STD_LOGIC;
    S00_AXIS_ARESETN : in STD_LOGIC;
    S00_AXIS_tdata : in STD_LOGIC_VECTOR ( 31 downto 0 );
    S00_AXIS_tid : in STD_LOGIC_VECTOR ( 1 downto 0 );
    S00_AXIS_tlast : in STD_LOGIC;
    S00_AXIS_tready : out STD_LOGIC;
    S00_AXIS_tstrb : in STD_LOGIC_VECTOR ( 3 downto 0 );
    S00_AXIS_tvalid : in STD_LOGIC;
    S01_ARB_REQ_SUPPRESS : in STD_LOGIC;
    S01_AXIS_ACLK : in STD_LOGIC;
    S01_AXIS_ARESETN : in STD_LOGIC;
    S01_AXIS_tdata : in STD_LOGIC_VECTOR ( 31 downto 0 );
    S01_AXIS_tid : in STD_LOGIC_VECTOR ( 1 downto 0 );
    S01_AXIS_tlast : in STD_LOGIC;
    S01_AXIS_tready : out STD_LOGIC;
    S01_AXIS_tstrb : in STD_LOGIC_VECTOR ( 3 downto 0 );
    S01_AXIS_tvalid : in STD_LOGIC
  );
end base_zynq_axis_interconnect_0_1;

architecture STRUCTURE of base_zynq_axis_interconnect_0_1 is
  component base_zynq_xbar_7 is
  port (
    aclk : in STD_LOGIC;
    aresetn : in STD_LOGIC;
    s_axis_tvalid : in STD_LOGIC_VECTOR ( 1 downto 0 );
    s_axis_tready : out STD_LOGIC_VECTOR ( 1 downto 0 );
    s_axis_tdata : in STD_LOGIC_VECTOR ( 63 downto 0 );
    s_axis_tstrb : in STD_LOGIC_VECTOR ( 7 downto 0 );
    s_axis_tlast : in STD_LOGIC_VECTOR ( 1 downto 0 );
    s_axis_tid : in STD_LOGIC_VECTOR ( 3 downto 0 );
    m_axis_tvalid : out STD_LOGIC_VECTOR ( 0 to 0 );
    m_axis_tready : in STD_LOGIC_VECTOR ( 0 to 0 );
    m_axis_tdata : out STD_LOGIC_VECTOR ( 31 downto 0 );
    m_axis_tstrb : out STD_LOGIC_VECTOR ( 3 downto 0 );
    m_axis_tlast : out STD_LOGIC_VECTOR ( 0 to 0 );
    m_axis_tid : out STD_LOGIC_VECTOR ( 1 downto 0 );
    s_req_suppress : in STD_LOGIC_VECTOR ( 1 downto 0 );
    s_decode_err : out STD_LOGIC_VECTOR ( 1 downto 0 )
  );
  end component base_zynq_xbar_7;
  component base_zynq_s_arb_req_suppress_concat_0 is
  port (
    In0 : in STD_LOGIC_VECTOR ( 0 to 0 );
    In1 : in STD_LOGIC_VECTOR ( 0 to 0 );
    dout : out STD_LOGIC_VECTOR ( 1 downto 0 )
  );
  end component base_zynq_s_arb_req_suppress_concat_0;
  signal axis_interconnect_0_ACLK_net : STD_LOGIC;
  signal axis_interconnect_0_ARESETN_net : STD_LOGIC;
  signal axis_interconnect_0_to_s00_couplers_TDATA : STD_LOGIC_VECTOR ( 31 downto 0 );
  signal axis_interconnect_0_to_s00_couplers_TID : STD_LOGIC_VECTOR ( 1 downto 0 );
  signal axis_interconnect_0_to_s00_couplers_TLAST : STD_LOGIC;
  signal axis_interconnect_0_to_s00_couplers_TREADY : STD_LOGIC;
  signal axis_interconnect_0_to_s00_couplers_TSTRB : STD_LOGIC_VECTOR ( 3 downto 0 );
  signal axis_interconnect_0_to_s00_couplers_TVALID : STD_LOGIC;
  signal axis_interconnect_0_to_s01_couplers_TDATA : STD_LOGIC_VECTOR ( 31 downto 0 );
  signal axis_interconnect_0_to_s01_couplers_TID : STD_LOGIC_VECTOR ( 1 downto 0 );
  signal axis_interconnect_0_to_s01_couplers_TLAST : STD_LOGIC;
  signal axis_interconnect_0_to_s01_couplers_TREADY : STD_LOGIC;
  signal axis_interconnect_0_to_s01_couplers_TSTRB : STD_LOGIC_VECTOR ( 3 downto 0 );
  signal axis_interconnect_0_to_s01_couplers_TVALID : STD_LOGIC;
  signal m00_couplers_to_axis_interconnect_0_TDATA : STD_LOGIC_VECTOR ( 31 downto 0 );
  signal m00_couplers_to_axis_interconnect_0_TKEEP : STD_LOGIC_VECTOR ( 3 downto 0 );
  signal m00_couplers_to_axis_interconnect_0_TLAST : STD_LOGIC;
  signal m00_couplers_to_axis_interconnect_0_TREADY : STD_LOGIC;
  signal m00_couplers_to_axis_interconnect_0_TVALID : STD_LOGIC;
  signal s00_arb_req_suppress_to_s_arb_req_suppress_concat : STD_LOGIC;
  signal s00_couplers_to_xbar_TDATA : STD_LOGIC_VECTOR ( 31 downto 0 );
  signal s00_couplers_to_xbar_TID : STD_LOGIC_VECTOR ( 1 downto 0 );
  signal s00_couplers_to_xbar_TLAST : STD_LOGIC;
  signal s00_couplers_to_xbar_TREADY : STD_LOGIC_VECTOR ( 0 to 0 );
  signal s00_couplers_to_xbar_TSTRB : STD_LOGIC_VECTOR ( 3 downto 0 );
  signal s00_couplers_to_xbar_TVALID : STD_LOGIC;
  signal s01_arb_req_suppress_to_s_arb_req_suppress_concat : STD_LOGIC;
  signal s01_couplers_to_xbar_TDATA : STD_LOGIC_VECTOR ( 31 downto 0 );
  signal s01_couplers_to_xbar_TID : STD_LOGIC_VECTOR ( 1 downto 0 );
  signal s01_couplers_to_xbar_TLAST : STD_LOGIC;
  signal s01_couplers_to_xbar_TREADY : STD_LOGIC_VECTOR ( 1 to 1 );
  signal s01_couplers_to_xbar_TSTRB : STD_LOGIC_VECTOR ( 3 downto 0 );
  signal s01_couplers_to_xbar_TVALID : STD_LOGIC;
  signal s_arb_req_suppress_concat_dout : STD_LOGIC_VECTOR ( 1 downto 0 );
  signal xbar_to_m00_couplers_TDATA : STD_LOGIC_VECTOR ( 31 downto 0 );
  signal xbar_to_m00_couplers_TID : STD_LOGIC_VECTOR ( 1 downto 0 );
  signal xbar_to_m00_couplers_TLAST : STD_LOGIC_VECTOR ( 0 to 0 );
  signal xbar_to_m00_couplers_TREADY : STD_LOGIC;
  signal xbar_to_m00_couplers_TSTRB : STD_LOGIC_VECTOR ( 3 downto 0 );
  signal xbar_to_m00_couplers_TVALID : STD_LOGIC_VECTOR ( 0 to 0 );
  signal NLW_xbar_s_decode_err_UNCONNECTED : STD_LOGIC_VECTOR ( 1 downto 0 );
begin
  M00_AXIS_tdata(31 downto 0) <= m00_couplers_to_axis_interconnect_0_TDATA(31 downto 0);
  M00_AXIS_tkeep(3 downto 0) <= m00_couplers_to_axis_interconnect_0_TKEEP(3 downto 0);
  M00_AXIS_tlast <= m00_couplers_to_axis_interconnect_0_TLAST;
  M00_AXIS_tvalid <= m00_couplers_to_axis_interconnect_0_TVALID;
  S00_AXIS_tready <= axis_interconnect_0_to_s00_couplers_TREADY;
  S01_AXIS_tready <= axis_interconnect_0_to_s01_couplers_TREADY;
  axis_interconnect_0_ACLK_net <= ACLK;
  axis_interconnect_0_ARESETN_net <= ARESETN;
  axis_interconnect_0_to_s00_couplers_TDATA(31 downto 0) <= S00_AXIS_tdata(31 downto 0);
  axis_interconnect_0_to_s00_couplers_TID(1 downto 0) <= S00_AXIS_tid(1 downto 0);
  axis_interconnect_0_to_s00_couplers_TLAST <= S00_AXIS_tlast;
  axis_interconnect_0_to_s00_couplers_TSTRB(3 downto 0) <= S00_AXIS_tstrb(3 downto 0);
  axis_interconnect_0_to_s00_couplers_TVALID <= S00_AXIS_tvalid;
  axis_interconnect_0_to_s01_couplers_TDATA(31 downto 0) <= S01_AXIS_tdata(31 downto 0);
  axis_interconnect_0_to_s01_couplers_TID(1 downto 0) <= S01_AXIS_tid(1 downto 0);
  axis_interconnect_0_to_s01_couplers_TLAST <= S01_AXIS_tlast;
  axis_interconnect_0_to_s01_couplers_TSTRB(3 downto 0) <= S01_AXIS_tstrb(3 downto 0);
  axis_interconnect_0_to_s01_couplers_TVALID <= S01_AXIS_tvalid;
  m00_couplers_to_axis_interconnect_0_TREADY <= M00_AXIS_tready;
  s00_arb_req_suppress_to_s_arb_req_suppress_concat <= S00_ARB_REQ_SUPPRESS;
  s01_arb_req_suppress_to_s_arb_req_suppress_concat <= S01_ARB_REQ_SUPPRESS;
m00_couplers: entity work.m00_couplers_imp_DSJXWU
     port map (
      M_AXIS_ACLK => axis_interconnect_0_ACLK_net,
      M_AXIS_ARESETN => axis_interconnect_0_ARESETN_net,
      M_AXIS_tdata(31 downto 0) => m00_couplers_to_axis_interconnect_0_TDATA(31 downto 0),
      M_AXIS_tkeep(3 downto 0) => m00_couplers_to_axis_interconnect_0_TKEEP(3 downto 0),
      M_AXIS_tlast => m00_couplers_to_axis_interconnect_0_TLAST,
      M_AXIS_tready => m00_couplers_to_axis_interconnect_0_TREADY,
      M_AXIS_tvalid => m00_couplers_to_axis_interconnect_0_TVALID,
      S_AXIS_ACLK => axis_interconnect_0_ACLK_net,
      S_AXIS_ARESETN => axis_interconnect_0_ARESETN_net,
      S_AXIS_tdata(31 downto 0) => xbar_to_m00_couplers_TDATA(31 downto 0),
      S_AXIS_tid(1 downto 0) => xbar_to_m00_couplers_TID(1 downto 0),
      S_AXIS_tlast => xbar_to_m00_couplers_TLAST(0),
      S_AXIS_tready => xbar_to_m00_couplers_TREADY,
      S_AXIS_tstrb(3 downto 0) => xbar_to_m00_couplers_TSTRB(3 downto 0),
      S_AXIS_tvalid => xbar_to_m00_couplers_TVALID(0)
    );
s00_couplers: entity work.s00_couplers_imp_1B288QA
     port map (
      M_AXIS_ACLK => axis_interconnect_0_ACLK_net,
      M_AXIS_ARESETN => axis_interconnect_0_ARESETN_net,
      M_AXIS_tdata(31 downto 0) => s00_couplers_to_xbar_TDATA(31 downto 0),
      M_AXIS_tid(1 downto 0) => s00_couplers_to_xbar_TID(1 downto 0),
      M_AXIS_tlast => s00_couplers_to_xbar_TLAST,
      M_AXIS_tready => s00_couplers_to_xbar_TREADY(0),
      M_AXIS_tstrb(3 downto 0) => s00_couplers_to_xbar_TSTRB(3 downto 0),
      M_AXIS_tvalid => s00_couplers_to_xbar_TVALID,
      S_AXIS_ACLK => axis_interconnect_0_ACLK_net,
      S_AXIS_ARESETN => axis_interconnect_0_ARESETN_net,
      S_AXIS_tdata(31 downto 0) => axis_interconnect_0_to_s00_couplers_TDATA(31 downto 0),
      S_AXIS_tid(1 downto 0) => axis_interconnect_0_to_s00_couplers_TID(1 downto 0),
      S_AXIS_tlast => axis_interconnect_0_to_s00_couplers_TLAST,
      S_AXIS_tready => axis_interconnect_0_to_s00_couplers_TREADY,
      S_AXIS_tstrb(3 downto 0) => axis_interconnect_0_to_s00_couplers_TSTRB(3 downto 0),
      S_AXIS_tvalid => axis_interconnect_0_to_s00_couplers_TVALID
    );
s01_couplers: entity work.s01_couplers_imp_Z3K9KA
     port map (
      M_AXIS_ACLK => axis_interconnect_0_ACLK_net,
      M_AXIS_ARESETN => axis_interconnect_0_ARESETN_net,
      M_AXIS_tdata(31 downto 0) => s01_couplers_to_xbar_TDATA(31 downto 0),
      M_AXIS_tid(1 downto 0) => s01_couplers_to_xbar_TID(1 downto 0),
      M_AXIS_tlast => s01_couplers_to_xbar_TLAST,
      M_AXIS_tready => s01_couplers_to_xbar_TREADY(1),
      M_AXIS_tstrb(3 downto 0) => s01_couplers_to_xbar_TSTRB(3 downto 0),
      M_AXIS_tvalid => s01_couplers_to_xbar_TVALID,
      S_AXIS_ACLK => axis_interconnect_0_ACLK_net,
      S_AXIS_ARESETN => axis_interconnect_0_ARESETN_net,
      S_AXIS_tdata(31 downto 0) => axis_interconnect_0_to_s01_couplers_TDATA(31 downto 0),
      S_AXIS_tid(1 downto 0) => axis_interconnect_0_to_s01_couplers_TID(1 downto 0),
      S_AXIS_tlast => axis_interconnect_0_to_s01_couplers_TLAST,
      S_AXIS_tready => axis_interconnect_0_to_s01_couplers_TREADY,
      S_AXIS_tstrb(3 downto 0) => axis_interconnect_0_to_s01_couplers_TSTRB(3 downto 0),
      S_AXIS_tvalid => axis_interconnect_0_to_s01_couplers_TVALID
    );
s_arb_req_suppress_concat: component base_zynq_s_arb_req_suppress_concat_0
     port map (
      In0(0) => s00_arb_req_suppress_to_s_arb_req_suppress_concat,
      In1(0) => s01_arb_req_suppress_to_s_arb_req_suppress_concat,
      dout(1 downto 0) => s_arb_req_suppress_concat_dout(1 downto 0)
    );
xbar: component base_zynq_xbar_7
     port map (
      aclk => axis_interconnect_0_ACLK_net,
      aresetn => axis_interconnect_0_ARESETN_net,
      m_axis_tdata(31 downto 0) => xbar_to_m00_couplers_TDATA(31 downto 0),
      m_axis_tid(1 downto 0) => xbar_to_m00_couplers_TID(1 downto 0),
      m_axis_tlast(0) => xbar_to_m00_couplers_TLAST(0),
      m_axis_tready(0) => xbar_to_m00_couplers_TREADY,
      m_axis_tstrb(3 downto 0) => xbar_to_m00_couplers_TSTRB(3 downto 0),
      m_axis_tvalid(0) => xbar_to_m00_couplers_TVALID(0),
      s_axis_tdata(63 downto 32) => s01_couplers_to_xbar_TDATA(31 downto 0),
      s_axis_tdata(31 downto 0) => s00_couplers_to_xbar_TDATA(31 downto 0),
      s_axis_tid(3 downto 2) => s01_couplers_to_xbar_TID(1 downto 0),
      s_axis_tid(1 downto 0) => s00_couplers_to_xbar_TID(1 downto 0),
      s_axis_tlast(1) => s01_couplers_to_xbar_TLAST,
      s_axis_tlast(0) => s00_couplers_to_xbar_TLAST,
      s_axis_tready(1) => s01_couplers_to_xbar_TREADY(1),
      s_axis_tready(0) => s00_couplers_to_xbar_TREADY(0),
      s_axis_tstrb(7 downto 4) => s01_couplers_to_xbar_TSTRB(3 downto 0),
      s_axis_tstrb(3 downto 0) => s00_couplers_to_xbar_TSTRB(3 downto 0),
      s_axis_tvalid(1) => s01_couplers_to_xbar_TVALID,
      s_axis_tvalid(0) => s00_couplers_to_xbar_TVALID,
      s_decode_err(1 downto 0) => NLW_xbar_s_decode_err_UNCONNECTED(1 downto 0),
      s_req_suppress(1 downto 0) => s_arb_req_suppress_concat_dout(1 downto 0)
    );
end STRUCTURE;
library IEEE;
use IEEE.STD_LOGIC_1164.ALL;
library UNISIM;
use UNISIM.VCOMPONENTS.ALL;
entity base_zynq_ps7_0_axi_periph_1 is
  port (
    ACLK : in STD_LOGIC;
    ARESETN : in STD_LOGIC;
    M00_ACLK : in STD_LOGIC;
    M00_ARESETN : in STD_LOGIC;
    M00_AXI_araddr : out STD_LOGIC_VECTOR ( 31 downto 0 );
    M00_AXI_arprot : out STD_LOGIC_VECTOR ( 2 downto 0 );
    M00_AXI_arready : in STD_LOGIC;
    M00_AXI_arvalid : out STD_LOGIC;
    M00_AXI_awaddr : out STD_LOGIC_VECTOR ( 31 downto 0 );
    M00_AXI_awprot : out STD_LOGIC_VECTOR ( 2 downto 0 );
    M00_AXI_awready : in STD_LOGIC;
    M00_AXI_awvalid : out STD_LOGIC;
    M00_AXI_bready : out STD_LOGIC;
    M00_AXI_bresp : in STD_LOGIC_VECTOR ( 1 downto 0 );
    M00_AXI_bvalid : in STD_LOGIC;
    M00_AXI_rdata : in STD_LOGIC_VECTOR ( 31 downto 0 );
    M00_AXI_rready : out STD_LOGIC;
    M00_AXI_rresp : in STD_LOGIC_VECTOR ( 1 downto 0 );
    M00_AXI_rvalid : in STD_LOGIC;
    M00_AXI_wdata : out STD_LOGIC_VECTOR ( 31 downto 0 );
    M00_AXI_wready : in STD_LOGIC;
    M00_AXI_wstrb : out STD_LOGIC_VECTOR ( 3 downto 0 );
    M00_AXI_wvalid : out STD_LOGIC;
    M01_ACLK : in STD_LOGIC;
    M01_ARESETN : in STD_LOGIC;
    M01_AXI_araddr : out STD_LOGIC_VECTOR ( 31 downto 0 );
    M01_AXI_arready : in STD_LOGIC_VECTOR ( 0 to 0 );
    M01_AXI_arvalid : out STD_LOGIC_VECTOR ( 0 to 0 );
    M01_AXI_awaddr : out STD_LOGIC_VECTOR ( 31 downto 0 );
    M01_AXI_awready : in STD_LOGIC_VECTOR ( 0 to 0 );
    M01_AXI_awvalid : out STD_LOGIC_VECTOR ( 0 to 0 );
    M01_AXI_bready : out STD_LOGIC_VECTOR ( 0 to 0 );
    M01_AXI_bresp : in STD_LOGIC_VECTOR ( 1 downto 0 );
    M01_AXI_bvalid : in STD_LOGIC_VECTOR ( 0 to 0 );
    M01_AXI_rdata : in STD_LOGIC_VECTOR ( 31 downto 0 );
    M01_AXI_rready : out STD_LOGIC_VECTOR ( 0 to 0 );
    M01_AXI_rresp : in STD_LOGIC_VECTOR ( 1 downto 0 );
    M01_AXI_rvalid : in STD_LOGIC_VECTOR ( 0 to 0 );
    M01_AXI_wdata : out STD_LOGIC_VECTOR ( 31 downto 0 );
    M01_AXI_wready : in STD_LOGIC_VECTOR ( 0 to 0 );
    M01_AXI_wvalid : out STD_LOGIC_VECTOR ( 0 to 0 );
    M02_ACLK : in STD_LOGIC;
    M02_ARESETN : in STD_LOGIC;
    M02_AXI_araddr : out STD_LOGIC_VECTOR ( 31 downto 0 );
    M02_AXI_arprot : out STD_LOGIC_VECTOR ( 2 downto 0 );
    M02_AXI_arready : in STD_LOGIC;
    M02_AXI_arvalid : out STD_LOGIC;
    M02_AXI_awaddr : out STD_LOGIC_VECTOR ( 31 downto 0 );
    M02_AXI_awprot : out STD_LOGIC_VECTOR ( 2 downto 0 );
    M02_AXI_awready : in STD_LOGIC;
    M02_AXI_awvalid : out STD_LOGIC;
    M02_AXI_bready : out STD_LOGIC;
    M02_AXI_bresp : in STD_LOGIC_VECTOR ( 1 downto 0 );
    M02_AXI_bvalid : in STD_LOGIC;
    M02_AXI_rdata : in STD_LOGIC_VECTOR ( 31 downto 0 );
    M02_AXI_rready : out STD_LOGIC;
    M02_AXI_rresp : in STD_LOGIC_VECTOR ( 1 downto 0 );
    M02_AXI_rvalid : in STD_LOGIC;
    M02_AXI_wdata : out STD_LOGIC_VECTOR ( 31 downto 0 );
    M02_AXI_wready : in STD_LOGIC;
    M02_AXI_wstrb : out STD_LOGIC_VECTOR ( 3 downto 0 );
    M02_AXI_wvalid : out STD_LOGIC;
    M03_ACLK : in STD_LOGIC;
    M03_ARESETN : in STD_LOGIC;
    M03_AXI_araddr : out STD_LOGIC_VECTOR ( 31 downto 0 );
    M03_AXI_arprot : out STD_LOGIC_VECTOR ( 2 downto 0 );
    M03_AXI_arready : in STD_LOGIC;
    M03_AXI_arvalid : out STD_LOGIC;
    M03_AXI_awaddr : out STD_LOGIC_VECTOR ( 31 downto 0 );
    M03_AXI_awprot : out STD_LOGIC_VECTOR ( 2 downto 0 );
    M03_AXI_awready : in STD_LOGIC;
    M03_AXI_awvalid : out STD_LOGIC;
    M03_AXI_bready : out STD_LOGIC;
    M03_AXI_bresp : in STD_LOGIC_VECTOR ( 1 downto 0 );
    M03_AXI_bvalid : in STD_LOGIC;
    M03_AXI_rdata : in STD_LOGIC_VECTOR ( 31 downto 0 );
    M03_AXI_rready : out STD_LOGIC;
    M03_AXI_rresp : in STD_LOGIC_VECTOR ( 1 downto 0 );
    M03_AXI_rvalid : in STD_LOGIC;
    M03_AXI_wdata : out STD_LOGIC_VECTOR ( 31 downto 0 );
    M03_AXI_wready : in STD_LOGIC;
    M03_AXI_wstrb : out STD_LOGIC_VECTOR ( 3 downto 0 );
    M03_AXI_wvalid : out STD_LOGIC;
    S00_ACLK : in STD_LOGIC;
    S00_ARESETN : in STD_LOGIC;
    S00_AXI_araddr : in STD_LOGIC_VECTOR ( 31 downto 0 );
    S00_AXI_arburst : in STD_LOGIC_VECTOR ( 1 downto 0 );
    S00_AXI_arcache : in STD_LOGIC_VECTOR ( 3 downto 0 );
    S00_AXI_arid : in STD_LOGIC_VECTOR ( 11 downto 0 );
    S00_AXI_arlen : in STD_LOGIC_VECTOR ( 3 downto 0 );
    S00_AXI_arlock : in STD_LOGIC_VECTOR ( 1 downto 0 );
    S00_AXI_arprot : in STD_LOGIC_VECTOR ( 2 downto 0 );
    S00_AXI_arqos : in STD_LOGIC_VECTOR ( 3 downto 0 );
    S00_AXI_arready : out STD_LOGIC;
    S00_AXI_arsize : in STD_LOGIC_VECTOR ( 2 downto 0 );
    S00_AXI_arvalid : in STD_LOGIC;
    S00_AXI_awaddr : in STD_LOGIC_VECTOR ( 31 downto 0 );
    S00_AXI_awburst : in STD_LOGIC_VECTOR ( 1 downto 0 );
    S00_AXI_awcache : in STD_LOGIC_VECTOR ( 3 downto 0 );
    S00_AXI_awid : in STD_LOGIC_VECTOR ( 11 downto 0 );
    S00_AXI_awlen : in STD_LOGIC_VECTOR ( 3 downto 0 );
    S00_AXI_awlock : in STD_LOGIC_VECTOR ( 1 downto 0 );
    S00_AXI_awprot : in STD_LOGIC_VECTOR ( 2 downto 0 );
    S00_AXI_awqos : in STD_LOGIC_VECTOR ( 3 downto 0 );
    S00_AXI_awready : out STD_LOGIC;
    S00_AXI_awsize : in STD_LOGIC_VECTOR ( 2 downto 0 );
    S00_AXI_awvalid : in STD_LOGIC;
    S00_AXI_bid : out STD_LOGIC_VECTOR ( 11 downto 0 );
    S00_AXI_bready : in STD_LOGIC;
    S00_AXI_bresp : out STD_LOGIC_VECTOR ( 1 downto 0 );
    S00_AXI_bvalid : out STD_LOGIC;
    S00_AXI_rdata : out STD_LOGIC_VECTOR ( 31 downto 0 );
    S00_AXI_rid : out STD_LOGIC_VECTOR ( 11 downto 0 );
    S00_AXI_rlast : out STD_LOGIC;
    S00_AXI_rready : in STD_LOGIC;
    S00_AXI_rresp : out STD_LOGIC_VECTOR ( 1 downto 0 );
    S00_AXI_rvalid : out STD_LOGIC;
    S00_AXI_wdata : in STD_LOGIC_VECTOR ( 31 downto 0 );
    S00_AXI_wid : in STD_LOGIC_VECTOR ( 11 downto 0 );
    S00_AXI_wlast : in STD_LOGIC;
    S00_AXI_wready : out STD_LOGIC;
    S00_AXI_wstrb : in STD_LOGIC_VECTOR ( 3 downto 0 );
    S00_AXI_wvalid : in STD_LOGIC
  );
end base_zynq_ps7_0_axi_periph_1;
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
