sventurag/watchman-readout/6UVMEboard_Zynq/hw/src/Round_Buffer/WindowStoreV4.vhd

library IEEE;
use IEEE.STD_LOGIC_1164.ALL;
use IEEE.NUMERIC_STD.ALL;
use work.TARGETC_pkg.all;
use work.WindowCPU_pkg.all;

entity WindowStoreV4 is
--	Generic(
--		NBRWINDOWS : integer := 16
--	);
	Port (
	nrst : 			in	std_Logic;
	ClockBus:		in T_ClockBus;

	ValidData:		in	std_logic;

	CPUBus:			in 	std_logic_vector(10 downto 0);
	CPUTime:		in	T_timestamp;
	TriggerInfo:	in 	std_logic_vector(11 downto 0);
	--trigger:        in  std_logic_vector(3 downto 0);

	
    -- Control Signals
    CtrlBus_IxSL:    in     T_CtrlBus_IxSL;

	-- Overwatch of Transmission
	NbrOfPackets:	out	std_logic_vector(7 downto 0);
	Reg_Clr:		in	std_logic;

	-- FIFO out for Reading RDAD
    RDAD_ReadEn  :in  std_logic;
    RDAD_DataOut : out std_logic_vector(8 downto 0);
    RDAD_Empty	: out std_logic;
    RDAD_Data_trig : in std_logic_vector(8 downto 0);
    RDAD_WriteEn_trig: in std_logic;

	-- FIFO for FiFoManager
	AXI_ReadEn:	in	std_logic;
	AXI_Time_DataOut : out std_logic_vector(63 downto 0);
	AXI_WdoAddr_DataOut : out std_logic_vector(8 downto 0);
	AXI_TrigInfo_DataOut : out std_logic_vector(11 downto 0);
	AXI_Spare_DataOut :	out std_logic_vector(10 downto 0);
    AXI_Empty	: out std_logic
	);

end WindowStoreV4;

architecture Behavioral of WindowStoreV4 is
--	component aFifoV2 is
--    generic (
--        DATA_WIDTH :integer := 8;
--        ADDR_WIDTH :integer := 4
--    );
--    port (
--    	rst :		in std_logic;
--        -- Reading port.
--        Data_out    :out std_logic_vector (DATA_WIDTH-1 downto 0);
--        Empty_out   :out std_logic;
--        ReadEn_in   :in  std_logic;
--        RClk        :in  std_logic;
--        -- Writing port.
--        Data_in     :in  std_logic_vector (DATA_WIDTH-1 downto 0);
--        Full_out    :out std_logic;
--        WriteEn_in  :in  std_logic;
--        WClk        :in  std_logic
--    );
--	end component aFifoV2;

COMPONENT axi_wdo_addr_fifo
  PORT (
   -- rst : IN STD_LOGIC;
    wr_clk : IN STD_LOGIC;
    rd_clk : IN STD_LOGIC;
    din : IN STD_LOGIC_VECTOR(8 DOWNTO 0);
    wr_en : IN STD_LOGIC;
    rd_en : IN STD_LOGIC;
    dout : OUT STD_LOGIC_VECTOR(8 DOWNTO 0);
    full : OUT STD_LOGIC;
    empty : OUT STD_LOGIC
  );
END COMPONENT;


COMPONENT axi_cmd_fifo_11W_5D
  PORT (
    wr_clk : IN STD_LOGIC;
    rd_clk : IN STD_LOGIC;
    din : IN STD_LOGIC_VECTOR(10 DOWNTO 0);
    wr_en : IN STD_LOGIC;
    rd_en : IN STD_LOGIC;
    dout : OUT STD_LOGIC_VECTOR(10 DOWNTO 0);
    full : OUT STD_LOGIC;
    empty : OUT STD_LOGIC
  );
END COMPONENT;

COMPONENT axi_time_fifo_64W_32D
  PORT (
    wr_clk : IN STD_LOGIC;
    rd_clk : IN STD_LOGIC;
    din : IN STD_LOGIC_VECTOR(63 DOWNTO 0);
    wr_en : IN STD_LOGIC;
    rd_en : IN STD_LOGIC;
    dout : OUT STD_LOGIC_VECTOR(63 DOWNTO 0);
    full : OUT STD_LOGIC;
    empty : OUT STD_LOGIC
  );
END COMPONENT;
--COMPONENT axi_trig_afifo_12W_32D
--  PORT (
--    wr_clk : IN STD_LOGIC;
--    rd_clk : IN STD_LOGIC;
--    din : IN STD_LOGIC_VECTOR(11 DOWNTO 0);
--    wr_en : IN STD_LOGIC;
--    rd_en : IN STD_LOGIC;
--    dout : OUT STD_LOGIC_VECTOR(11 DOWNTO 0);
--    full : OUT STD_LOGIC;
--    empty : OUT STD_LOGIC
--  );
--END COMPONENT;
        
        
        COMPONENT AXI_TRIG_AFIFO
  PORT (
    wr_clk : IN STD_LOGIC;
    rd_clk : IN STD_LOGIC;
    din : IN STD_LOGIC_VECTOR(11 DOWNTO 0);
    wr_en : IN STD_LOGIC;
    rd_en : IN STD_LOGIC;
    dout : OUT STD_LOGIC_VECTOR(11 DOWNTO 0);
    full : OUT STD_LOGIC;
    empty : OUT STD_LOGIC
  );
END COMPONENT;
--COMPONENT trig_fifo_3W_16D
--  PORT (
--    wr_clk : IN STD_LOGIC;
--    rd_clk : IN STD_LOGIC;
--    din : IN STD_LOGIC_VECTOR(3 DOWNTO 0);
--    wr_en : IN STD_LOGIC;
--    rd_en : IN STD_LOGIC;
--    dout : OUT STD_LOGIC_VECTOR(3 DOWNTO 0);
--    full : OUT STD_LOGIC;
--    empty : OUT STD_LOGIC
--  );
--END COMPONENT;


	type T_storestate is(
		IDLE,
		STABILIZE,
		PREPARE,
		PULSE,
		STABILIZE2,
		PREPARE2,
		PULSE2
	);

	constant TRIG_LAST_MASK : std_logic_vector(11 downto 0) := "000000001111";

	signal writeEn_stm : T_storestate := IDLE;

	signal Full_out_intl    : std_logic;
	signal WriteEn_intl  : std_logic;
	signal WriteEn  : std_logic;

	signal Counter:		std_logic_vector(63 downto 0);

	--signal TrigInfoDly, TrigInfoBuf, TrigInfoBuf_dly : std_logic_vector(11 downto 0);

--	signal Trig:	std_logic_vector(11 downto 0);

	signal Wdo1:	std_logic_vector(8 downto 0);
    signal WdoNumber:	std_logic_vector(8 downto 0);

	signal CMD_s:	std_logic_vector(10 downto 0);
    signal CMD_s1:	std_logic_vector(10 downto 0);

	signal axi_full_s:	std_logic_vector(3 downto 0);
	signal axi_empty_s:	std_logic_vector(3 downto 0);

	signal NbrOfPackets_intl : std_logic_vector(7 downto 0);
	   signal trigger125MHz_s:     std_logic_vector(3 downto 0);
     signal trigger_empty_s:        std_logic;
    signal trigger_full_s:        std_logic;
   signal WriteEn_mult: std_logic;
   signal WdoNumber_mult: std_logic_vector(8 downto 0);
   
--   attribute mark_debug : string;

--   attribute mark_debug of WriteEn: signal is "true";
--   attribute mark_debug of WdoNumber: signal is "true";
--   attribute mark_debug of WdoNumber_mult: signal is "true";
--   attribute mark_debug of WriteEn_mult: signal is "true";
--   attribute mark_debug of RDAD_WriteEn_trig: signal is "true";
--   attribute mark_debug of RDAD_Data_trig: signal is "true";
--   attribute mark_debug of WriteEn_intl: signal is "true";

   
   
	-- -------------------------------------------------------------
	-- Constraints on Signals
	-- -------------------------------------------------------------
	--attribute DONT_TOUCH : string;
	--attribute DONT_TOUCH of RDAD_STO_AFIFO : label is "TRUE";
	--attribute DONT_TOUCH of writeEn_stm : signal is "TRUE";
	--attribute DONT_TOUCH of writeen_intl : signal is "TRUE";
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
