sventurag/watchman-readout/6UVMEboard_Zynq/hw/src/Round_Buffer/circularBuffer.vhd

---------------------------------------------------------------------------------
-- Company: IDLAB, Hawaii
-- Engineer: Salvador Ventura
-- 
-- Create Date: 09/11/2019
-- Design Name: 
-- Module Name: circularBuffer - 
-- Project Name: WATCHMAN
-- Target Devices: 
-- Tool Versions: 

-- Description: This module controls the writting process in TargetC in function of 
-- a trigger. The main part is done by a state machine with two types of states:
-- hitX and wr_add. All the states monitor the trigger signal but the hit7 and wr_add also
-- contains the logic for moving to the next WR address. 4-window SubBuffers are considered
-- for this version.
-- State machine states:
--   | hit0  |   hit1 |  hit2  |   hit3  |  hit4  |   hit5  | hit6  |   hit7 |  hit8  |   hit9 |  hit10  |   hit11  |  hit12  |   hit13  | hit14  |   wr_add    |
--   WR ADD.   WR_B =  WR_A +1
--  |                                      WR_A                                              |                                       WR_B                                                           |    
--  Window numbers to be digitized, x = WR_A*2
--  |               x                             |                 x+1                       |                 x+2                           |                    x + 3                             |                 

-- Revision:
-- Revision 0.01 - File Created
-- Additional Comments:
-- 
----------------------------------------------------------------------------------
library ieee;
use ieee.std_logic_1164.all;
 use ieee.numeric_std.all;
-- use work.TARGETC_pkg.all; --not used in simulations
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
