sventurag/watchman-readout/(commit log)

2018-10-01 Adding AXI DMA STREAM Testbench
    [waveform.csv]
2018-10-02 Removed more files from Xilinxbuild folder
    [waveform.csv]
2018-11-01 Commit the TargetC Prototype Project
2018-12-10 TargetC Prototype
    Minor Changes with header and all
2018-12-14 TargetC Prototype Ready for Merge with Anthony
2018-12-20 Clock Domain Issue
    Clock domain issue and MMCM from WL trouble, all clocks are 100 MHz referenced from FCLK0 of Zynq. MMCM has 100 MHz and 250MHz clock only.
    [TARGETC_Control.vhd, TARGETC_TOPLEVEL.vhd, TARGETC_pkg.vhd, base_zynq.vhd, base_zynq_auto_pc_0.v, base_zynq_auto_pc_0_sim_netlist.v, base_zynq_auto_pc_0_stub.v]
2019-01-16 Working RoundBuffer with still some Timing Issues
    [Implementation.xdc, TARGETC_Control.vhd, TARGETC_TOPLEVEL.vhd, TARGETC_pkg.vhd, Timing.xdc, base_zynq.vhd, base_zynq_auto_pc_0.v, base_zynq_auto_pc_0_sim_netlist.v]
2019-01-17 Commit DONT_TOUCH attribute
    TIming analyis on the code to see where clocks and all are going wrong
    [TARGETC_Control.vhd, TARGETC_TOPLEVEL.vhd, base_zynq.vhd, base_zynq_wrapper.vhd]
2019-01-26 FMC TargetC Prototype - Project Added (changes in progress)
2019-02-15 Documentation Update + SDK Anthony
    [TARGETC_pinout_hej.xlsx, param.txt]
2019-03-12 mv GUI dir, rm Python dir & old Vivado projects
    [ParametersVivado.txt, param.txt]
2019-04-09 Revert "NBRWINDOWS=16 in TARGETC_TOPLEVEL.vhd"
    This reverts commit efecadfe5839183a0ed404f33fed46de36f4d9cf.
    Wrong commit
    [TARGETC_TOPLEVEL.vhd]
2019-04-29 Add nextAddressCnt to replace linked-list CPUs
    [RoundBufferV6.vhd]
2019-05-06 replace aFIFOV2 by IP FIFO
    [WindowStoreV4.vhd, base_zynq.vhd, base_zynq_TARGET_C_TopLevel_Sy_0_0_stub.v, base_zynq_TARGET_C_TopLevel_Sy_0_0_stub.vhdl, base_zynq_wrapper.vhd]
2019-05-06 replace aFIfo by IP
    [WindowStoreV4.vhd]
2019-06-06 fixing waveform_gen_33600 instantiation problems
    [waveform_gen_33600.py]
2019-06-14 Change update WR to fix window order
    [CPU_CONTROLLERV3.vhd]
2019-06-17 Windows in reverse order for WR_RS after trying to compensate the 0,1,3,2 pattern. Windows are sorted in SW
    [CPU_CONTROLLERV3.vhd, Implementation.xdc, TARGETC_TOPLEVEL.vhd, Timing.xdc, base_zynq.vhd, base_zynq_TARGET_C_TopLevel_Sy_0_0_stub.v, base_zynq_TARGET_C_TopLevel_Sy_0_0_stub.vhdl]
2019-06-28 Raw data from PS to get offline pedestal on Python, major changes on targetc.py to avoid writting to a txt file
    [targetc.py]
2019-07-24 omit sample 32
2019-07-26 replace 250 MHz clock by 125MHz in vivado project
    [CLOCK_MANAGEMENT.vhd, CPU_CONTROLLERV3.vhd, TARGETC_pkg.vhd, WindowStoreV4.vhd, base_zynq.vhd, base_zynq_TARGET_C_TopLevel_Sy_0_0_stub.v, base_zynq_TARGET_C_TopLevel_Sy_0_0_stub.vhdl, base_zynq_auto_pc_0.v]
2019-08-07 fixing timing, tested failed on TARGETC
    [CLOCK_MANAGEMENT.vhd, CPU_CONTROLLERV3.vhd, Implementation.xdc, RoundBufferV6.vhd, TARGETC_Control.vhd, TARGETC_TOPLEVEL.vhd, Timing.xdc]
2019-08-08 Timing closure ongoing on READOUT_DIGITIZATION_SAMPLE.vhd, acknowledge not working for SyncBit.vhd
    [base_zynq.vhd, base_zynq_wrapper.vhd]
2019-09-04 DLL working properly, trigger setup using oscilloscope, timing problems fixed
    [targetc.py]
2019-09-13 Missing hits, need to change state machine
    [circularBuffer.vhd, circularBufferTB.vhd]
2019-09-26 Revert "changes in BuildProject.tcl and SynchBit files"
    This reverts commit 7ca532425c577659d6aa126613913f7503585f91.
    [base_zynq.vhd, base_zynq_auto_pc_0_sim_netlist.v, base_zynq_auto_pc_0_stub.v, base_zynq_auto_pc_0_stub.vhdl, base_zynq_auto_pc_1_sim_netlist.v, base_zynq_auto_pc_1_sim_netlist.vhdl, base_zynq_auto_pc_1_stub.v]
2019-11-13 DMA transfer done using the interrupt
2019-11-16 trying comparators work, adding option in sdk to change DAC voltages, new FIFO in PL for trigger signals
2019-11-16 performance measurement on a simple dma transfer
2019-11-20 Watchdog timer set to 10 sec, getting one window from trigger mode working correctly
2019-11-21 thread_trigger added, changes in thread name to thread_user_mode, previously thread_data_int_2
2019-11-26 PS CLK 100
    Working properly, no timing violations getting windows in user and trigger modes
    [iladata.csv]
2019-11-26 PS CLK 125 MHz
    Both modes, user and trigger working properly. One problem: first sample on every window is zero.
    [base_zynq.vhd, base_zynq_TARGET_C_TopLevel_Sy_0_0_stub.v, base_zynq_TARGET_C_TopLevel_Sy_0_0_stub.vhdl, base_zynq_auto_pc_0.v, base_zynq_auto_pc_0_sim_netlist.v, base_zynq_auto_pc_0_stub.v]
2019-11-26 PS 200 MHz
    Timing violations, TNS : -10839921, Test pattern failed
    [base_zynq.vhd, base_zynq_TARGET_C_TopLevel_Sy_0_0_stub.v, base_zynq_TARGET_C_TopLevel_Sy_0_0_stub.vhdl, base_zynq_auto_pc_0.v, base_zynq_auto_pc_0_sim_netlist.v, base_zynq_auto_pc_0_stub.v]
2019-11-27 Speeding up II
    INCR_WAIT_PERIOD to 0x001, and reducing the states in wlstate FSM to get 1 cycle of HSCLK for every sample. TestPattern Generator failed
    [TARGETC_TOPLEVEL.vhd, Timing.xdc, base_zynq.vhd, base_zynq_TARGET_C_TopLevel_Sy_0_0_stub.v, base_zynq_TARGET_C_TopLevel_Sy_0_0_stub.vhdl, base_zynq_wrapper.vhd]
2019-11-28 User mode working fine, crashes after one try on trigger mode
    [base_zynq.vhd, base_zynq_TARGET_C_TopLevel_Sy_0_0_stub.v, base_zynq_TARGET_C_TopLevel_Sy_0_0_stub.vhdl, base_zynq_wrapper.vhd, targetc.py]
2019-12-03 upgrated IPs, test pattern failed with some samples= 3338
    [base_zynq.vhd, base_zynq_TARGET_C_TopLevel_Sy_0_0_stub.v, base_zynq_TARGET_C_TopLevel_Sy_0_0_stub.vhdl, base_zynq_auto_pc_0.v, base_zynq_auto_pc_0_sim_netlist.v, base_zynq_auto_pc_0_stub.v]
2019-12-03 Timing problems fixed, TPG failed
    After upgrading, the PS IP core changed to 155 MHz, that was the origin of the timing problems, however, the TPG shows 645 for the first 27 samples of channel 0 and zero for the first 27 samples of the rest of the channels. Samples 28-32 showed the correct value=1290
    [base_zynq.vhd, base_zynq_TARGET_C_TopLevel_Sy_0_0_stub.v, base_zynq_TARGET_C_TopLevel_Sy_0_0_stub.vhdl, base_zynq_auto_pc_0.v, base_zynq_auto_pc_0_sim_netlist.v, base_zynq_auto_pc_0_stub.v]
2019-12-03 HIGH_SET1 state commented out in READ_DIG module (after ip upgrade)
    32 us dig time, no timing issues
    [base_zynq.vhd, base_zynq_TARGET_C_TopLevel_Sy_0_0_stub.v, base_zynq_TARGET_C_TopLevel_Sy_0_0_stub.vhdl, base_zynq_auto_pc_0_sim_netlist.v, base_zynq_auto_pc_0_stub.v, base_zynq_auto_pc_0_stub.vhdl, base_zynq_auto_pc_1_sim_netlist.v]
2019-12-05 [after synt and impl] changes for RAMP and working properly
    [TARGETC_pinout_hej.xlsx, iladata.csv]
2019-12-06 HSCLK high for 1 cycle after sample 0
2019-12-06 [after synth and impl] HSCLK high for 1... TPG failed
    All channels showing 2580:
    1290 010100001010
    2580 101000010100
    [base_zynq.vhd, base_zynq_TARGET_C_TopLevel_Sy_0_0_stub.v, base_zynq_TARGET_C_TopLevel_Sy_0_0_stub.vhdl, base_zynq_wrapper.vhd]
2019-12-06 Incrementing one cycle before every sample
2019-12-09 Trigger mode crash
    No timing issues, debug core on, but still not working.
    [base_zynq.vhd, base_zynq_TARGET_C_TopLevel_Sy_0_0_stub.v, base_zynq_TARGET_C_TopLevel_Sy_0_0_stub.vhdl, base_zynq_wrapper.vhd]
2019-12-09 zeros in the output
    first output samples in channel 4: 1339,1301,1311,1327,0,0,0,0,0,0,0,0,0,0,1481,1359,
2019-12-11 Updating watchdog and timers while waiting for pulse
2019-12-11 Testing updating watchdog and timing
    The board is not crashing when the pulse is not intermediately triggered, but once it is (asynch), no pulse is shown in the output and the level of the last window is ~1500, when the rest of the windows are ~1200. Then, the dig time is 7 us and the output is similar to asynchronous pulse even when is synchronous.
2019-12-11 [after synth] Vivado confused about the top module
    Fixed by recreating the VHDL wrapper of the block diagram
    [base_zynq.vhd, base_zynq_TARGET_C_TopLevel_Sy_0_0_stub.v, base_zynq_TARGET_C_TopLevel_Sy_0_0_stub.vhdl, base_zynq_axi_dma_0_0_stub.v]
2019-12-11 trigger thread and saving data to a txt file
2020-01-17 Switch to positive pulse trigger mode
2020-01-18 Switch to positive pulses, fixing wrong treshold
    The threshold should be > Vped for positive pulses. 1.78V in this case.
    [Timing.xdc, base_zynq.vhd, base_zynq_TARGET_C_TopLevel_Sy_0_0_stub.v, base_zynq_TARGET_C_TopLevel_Sy_0_0_stub.vhdl, base_zynq_wrapper.vhd]
2020-01-18 Simulations
    Changes in the circularBuffer file for handling the edge problem at this point only for the first case (hit0),. Change of variable names for flag0 and hit0. Not simulated yet.
    [circularBuffer.vhd, circularBufferTB.vhd]
2020-01-31 Wiring up circular buffer again
2020-02-04 RD_ADD bug
    RD_ADD was not updated, so the output window was always = zero
    [circularBuffer.vhd]
2020-03-01 disabling thread for trigger mode receive and process data
2020-03-06 replacing printf by xil_printf
2020-03-06 usleep commented in interrupt.c sleep(5) uncommented in data_analysis
2020-03-27 Working in trigger mode
    There was a recurrent problem at starting the trigger mode, the first subbuffer used to pass without trigger, fixed by disconnecting the cable for the usermode in BB2.
    [base_zynq.vhd, base_zynq_TARGET_C_TopLevel_Sy_0_0_stub.v, base_zynq_TARGET_C_TopLevel_Sy_0_0_stub.vhdl, base_zynq_wrapper.vhd, targetc.py]
2020-03-29 Testing simpletransferDMA
    The system is working remotely, including control over the waveform generator, which was extended to set the burst. As the pulse frequency reaches ~5 kHz some windows are lost, this is likely due to the simple transfer mode, which interrupts the data transfer between the PS and the PC.
2020-04-03 Test Pattern failed
    Running synthesis and implementation again
    [base_zynq.vhd, base_zynq_TARGET_C_TopLevel_Sy_0_0_stub.v, base_zynq_TARGET_C_TopLevel_Sy_0_0_stub.vhdl, base_zynq_wrapper.vhd]
2020-04-04 Bug in PL due to errors in update
    p_delay_fifo_wr_cycle not included in update
    [Timing.xdc, base_zynq.vhd, base_zynq_TARGET_C_TopLevel_Sy_0_0_stub.v, base_zynq_TARGET_C_TopLevel_Sy_0_0_stub.vhdl, base_zynq_wrapper.vhd, circularBuffer.vhd]
2020-04-04 Test pattern failed
    Also, another bug in p_delay_fifo_wr_cycle implementation
    [base_zynq.vhd, base_zynq_TARGET_C_TopLevel_Sy_0_0_stub.v, base_zynq_TARGET_C_TopLevel_Sy_0_0_stub.vhdl, base_zynq_wrapper.vhd]
2020-04-05 Writting process reviewed and updated
    Multiple changes in both writting and digitize process for the circular buffer. TO FIX: When the pulse occurs in the edge of a subBuffer, the amount of windows to be digitize should be 2 not 1.
    [circularBuffer.vhd]
2020-04-07 WR to change in SSTIN rising edge.
    Timestamp.samplecnt="011"
2020-04-07 Test on hardware for SSTIN = 011
    Showing different behavior for two window case, but apparently less digitized pulse than falling edge
2020-04-11 Still having problems in window edges
    [base_zynq.vhd, base_zynq_TARGET_C_TopLevel_Sy_0_0_stub.v, base_zynq_TARGET_C_TopLevel_Sy_0_0_stub.vhdl, base_zynq_wrapper.vhd, circularBuffer.vhd]
2020-04-13 Test on user mode to get the WR transition relative to SSTIN
    WR is updated at 100 in SampleCnt
2020-04-16 Replacing counter_i by Timestamp.samplecnt
2020-04-16 SSTIN and statemachine synched to 011
    fixing wrong change in f4fabaf168832f39260568e391c37bdaeab96823
    [Timing.xdc, base_zynq.vhd, base_zynq_TARGET_C_TopLevel_Sy_0_0_stub.v, base_zynq_TARGET_C_TopLevel_Sy_0_0_stub.vhdl, base_zynq_wrapper.vhd, circularBuffer.vhd]
2020-04-17 100 pulses test at 1 Hz shows no baseline level problem
    [base_zynq.vhd, base_zynq_TARGET_C_TopLevel_Sy_0_0_stub.v, base_zynq_TARGET_C_TopLevel_Sy_0_0_stub.vhdl, base_zynq_wrapper.vhd]
2020-04-24 Query, pulseWidth, loadHz and volt functions added
2020-04-24 Configuration to get pulses
    The current threshold values requires the pulses to be at 0 - 0.070 range in order to not saturate the ADC. There is also a probable relationship between pulse width and noise, to be confirmed. Pedestal must be reviewed as well.
2020-05-12 SSTIN to 100 not working
    [base_zynq.vhd, base_zynq_TARGET_C_TopLevel_Sy_0_0_stub.v, base_zynq_TARGET_C_TopLevel_Sy_0_0_stub.vhdl, base_zynq_wrapper.vhd, circularBuffer.vhd]
2020-05-13 Synch with SSTIN to 011, pulse_analysis.py replace lookIntoPackets.py
    [base_zynq.vhd, base_zynq_TARGET_C_TopLevel_Sy_0_0_stub.v, base_zynq_TARGET_C_TopLevel_Sy_0_0_stub.vhdl, base_zynq_wrapper.vhd, circularBuffer.vhd, pulse_analysis.py]
2020-05-21 fix no writeEn pulse for Window 0
    [circularBuffer.vhd]
2020-05-21 fix no window zero dig when inter-buffer pulse occurs
    [circularBuffer.vhd]
2020-05-28 Fix port mismatch for average number
    [RoundBufferV6.vhd]
2020-05-29 Fixing not connected trigger signal
    [RoundBufferV6.vhd]
2020-06-02 adding others=> null to case statement
2020-06-09 Fixing problem with first window
    Going out of the trigger mode not necessary after pedestal acquisition
    [base_zynq.vhd, base_zynq_TARGET_C_TopLevel_Sy_0_0_stub.v, base_zynq_TARGET_C_TopLevel_Sy_0_0_stub.vhdl, base_zynq_wrapper.vhd]
2020-06-10 Workaround for getting average
    [base_zynq.vhd, base_zynq_TARGET_C_TopLevel_Sy_0_0_stub.v, base_zynq_TARGET_C_TopLevel_Sy_0_0_stub.vhdl, base_zynq_wrapper.vhd]
2020-06-14 Test DMA and udp_transfer for 1000 average passed
2020-06-14 Updating processed packets correctly, bad data sent
    [targetc.py]
2020-06-21 Replacing repetitive code by procedure
    window2read signal is not updated as before, the two right-most bits are not updated in each statement because it is not necessary. The corrected window number includes two bits from the flag_number which contains the information.
    [circularBuffer.vhd]
2020-07-02 Optimization and fix OR in stm_2windows
    [circularBuffer.vhd]
2020-07-19 Inverting rango and repeticiones for loop
    [PulseSweep.py]
2020-07-19 commenting print statement
2020-07-19 Pulse sweep showing position error increase after 4 windows
    [PulseSweep.py, Timing.xdc, base_zynq.vhd, base_zynq_TARGET_C_TopLevel_Sy_0_0_stub.v, base_zynq_TARGET_C_TopLevel_Sy_0_0_stub.vhdl, base_zynq_wrapper.vhd]
2020-07-20 Fixing no pulse windows
    [PulseSweep.py]
2020-08-28 Microzed pinout tables from Microzed website
    [MicroZed_JX_pinout_tables_jx1.csv, MicroZed_JX_pinout_tables_jx2.csv]
2020-08-28 Pinout VME board
2020-08-28 Pulse Generator class
    import waveform_gen_33600 and targetc classes to control waveform generator and targetc boards
2020-08-28 Working on xdc constraint file, JX2 DONE
    [MicroZed_JX_pinout_tables_jx1_SOMA.csv]
2020-08-29 Constraint file 6UVME TARGETC board generated with JX1_JX2_pinout.ipynb
2020-08-29 Cleaning constraint directory
    [MicroZed_JX_pinout_tables_jx1_SOMA.csv]
2020-09-09 Swapped ports according to schematics
    [6UVME_TARGETC_BOARD_constraints.xdc]
2020-09-09 testing constraints
    [6UVME_TARGETC_BOARD_constraints.csv]
2020-10-09 DAC init pass but no output voltage
    DAC initialization pass! CHANNEL:7 DAC_VPED:7 1.750000 V
    CHANNEL:0 DAC_GRP_0:0 1.780000 V
    CHANNEL:1 DAC_GRP_1:1 1.780000 V
    CHANNEL:2 DAC_GRP_2:2 1.780000 V
    CHANNEL:3 DAC_GRP_3:3 1.780000 V
2020-10-29 Found a pinout mismatch in schematics, Upgrading to Vitis
    Not trying IIC PS anymore, but bit banging I2C AND SPI
2020-10-30 bitbanging for I2C first try
2020-11-26 I2C_bit_banging.c tested, the signals are toggling on oscilloscope, no voltage output on testpoint.
2020-11-30 Bitbanging sequence not working after pullup resistors
2021-01-08 Bitbanging working for I2C
2021-02-11 Uncomment Package pin and IOSTANDARD for TARGETC B ports
2021-03-29 Fan out WindowStorage signal in firmware
2021-04-01 Double the size of the DMA array structure for 2 TARGETC
2021-04-21 Tracking down noTARGETC_1 bug
    [6UVME_TARGETC_BOARD_constraints.xdc, CLOCK_MANAGEMENT.vhd, CPU_CONTROLLERV3.vhd, PulseSweep.py, TARGETC_Control.vhd, TARGETC_TOPLEVEL.vhd, WindowStoreV4.vhd, base_zynq.vhd]
2021-05-27 Implementation failed, WL_CLK in TC_1 not connected
    [AXI_TRIG_AFIFO.v, AXI_TRIG_AFIFO.vhd, HMB_roundBuffer.vhd, TARGETC.h, TARGETC_v1_0.vhd, TARGETC_v1_0_S00_AXI.vhd, axi_cmd_fifo_11W_5D.v, axi_cmd_fifo_11W_5D.vhd]
2021-06-01 Implementation succed, not tested on board yet
2021-06-03 VPED 1.75V
2021-06-03 VPED 1.5 V
2021-06-03 VPED 2.0V in script, 1.78 in board
2021-06-04 VPED 1.3V script/1.2V in board. 300 mv waveform gen
2021-06-07 Looking for the source of the noise in the board
    [PulseSweep.py, getPackets.py]
2021-06-12 Fix bug in getPacketsTrigMode
    [6UVME_TARGETC_BOARD_constraints.xdc, HMBtriggerMode.py, Implementation.xdc, Timing.xdc, base_zynq.vhd, base_zynq_Start_digitization_ip_0_0_sim_netlist.v, base_zynq_Start_digitization_ip_0_0_sim_netlist.vhdl]
2021-06-14 After impl, noise out of the roundBuffer
    [base_zynq.vhd, base_zynq_Start_digitization_ip_0_0_sim_netlist.v, base_zynq_Start_digitization_ip_0_0_sim_netlist.vhdl, base_zynq_Start_digitization_ip_0_0_stub.v, base_zynq_Start_digitization_ip_0_0_stub.vhdl, base_zynq_TARGET_C_TopLevel_Sy_0_0_stub.v, base_zynq_TARGET_C_TopLevel_Sy_0_0_stub.vhdl, base_zynq_TARGET_C_TopLevel_Sy_1_6_stub.v]
2021-06-14 Noise out of RoundBuffer still there
    [base_zynq.vhd, base_zynq_Start_digitization_ip_0_0_sim_netlist.v, base_zynq_Start_digitization_ip_0_0_sim_netlist.vhdl, base_zynq_Start_digitization_ip_0_0_stub.v, base_zynq_Start_digitization_ip_0_0_stub.vhdl, base_zynq_TARGET_C_TopLevel_Sy_0_0_stub.v, base_zynq_TARGET_C_TopLevel_Sy_0_0_stub.vhdl, base_zynq_TARGET_C_TopLevel_Sy_1_6_stub.v]
2021-07-03 TC1 disconnected in DMA IP, both modes working
2021-07-08 Rename directory for 6UVMEboard_Zynq
    [6UVME_TARGETC_BOARD_constraints.csv, MicroZed_JX_pinout_tables_jx1.csv, MicroZed_JX_pinout_tables_jx2.csv, iladata.csv]
2021-07-09 Update TCL file for 6UVME board
