sventurag/watchman-readout/(notices)

Notices in the files:
6UVMEboard_Zynq/hw/bd/base_zynq/ip/base_zynq_auto_ss_k_0_1/hdl/top_base_zynq_auto_ss_k_0.v:
-- (c) Copyright 2012 - 2013 Xilinx, Inc. All rights reserved.
